romalik/cpu5/microcode/instruction_set.ods

Sheet: ISA
 | 0* | 1* | 2* | 3* | 4* | 5* | 6* | 7* | 8* | 9* | A* | B* | C* | D* | E* | F*
 | 0000 | 0001 | 0010 | 0011 | 0100 | 0101 | 0110 | 0111 | 1000 | 1001 | 1010 | 1011 | 1100 | 1101 | 1110 | 1111
*0 | hlt |  |  |  |  |  | movw w, [m+#] | movw [m+#], w | mov wl,a | mov a,wl | jnz | tadd rd#, rs#, rs# | add | mov b,a | mov a,b | push xm
*1 | di |  |  |  |  |  | movw y, [m+#] | movw [m+#], y | mov wh,a | mov a,wh | jnc | tsub rd#, rs#, rs# | sub | mov sl,a | mov a,sl | pop mx
*2 | ei |  |  |  |  |  | movw z, [m+#] | movw [m+#], z | mov yl,a | mov a,yl | jg | tneg rd#, rs# | neg | mov sh,a | mov a,sh | sp+=2
*3 | nop |  |  |  |  |  | mov [w],a | mov a,[w] | mov yh,a | mov a,yh | ja | tshl rd#, rs# | shl | mov ml,a | mov a,ml | sp+=8
*4 |  |  |  |  |  |  | mov [y],a | mov a,[y] | mov zl,a | mov a,zl | jge | tshlc rd#, rs# | shlc | mov mh,a | mov a,mh | sp-=2
*5 |  |  |  |  |  |  | mov [z],a | mov a,[z] | mov zh,a | mov a,zh | - | tinc rd#, rs# | inc | mov [m+#],a | mov a,[m+#] | sp-=8
*6 |  |  |  |  |  |  | push w | pop w | w++ | w-- | - | tadc rd#, rs#, rs# | adc | mov xl,a | mov a,xl | push [m+#]
*7 | x++ |  |  |  |  |  | push y | pop y | y++ | y-- | - | tsbc rd#, rs#, rs# | sbc | mov xh,a | mov a,xh | pop [m+#]
*8 |  |  |  |  |  |  | push z | pop z | z++ | z-- | jz | tnot rd#, rs# | not |  |  | pushw [m+#]
*9 |  |  |  |  |  |  |  |  | ldd w, ## | y++ & z++ | jc | tand rd#, rs#, rs# | and | push a | pop a | popw [m+#]
*A |  |  |  |  |  |  |  |  | ldd y, ## | [y]→[z] | jle | tor rd#, rs#, rs# | or | mov f,a | mov a,f | mov [m+#],[m+#]
*B |  |  |  |  |  |  |  |  | ldd z, ## |  | jbe | txor rd#, rs#, rs# | xor | mov [x],a | mov a,[x] | mov2 [m+#],[m+#]
*C |  |  |  |  |  |  |  |  |  |  | jl | tzero rd# | zero | ldd s, ## | ld a, #
*D |  |  |  |  |  |  |  |  |  |  | - | ttest rd#, rs# | test | ldd m, ##
*E |  |  |  |  |  |  |  |  |  |  | - | tshr rd#, rs# | shr | ldd x, ## | movsm | movw x, [m+#]
*F | iret | syscall | iretf |  |  |  |  |  |  |  | jmp | tshrc rd#, rs# | shrc | ld r#, # | movms

Sheet: Timings
 |  |  |  |  |  |  | ns | steps | adjusted steps | min step length | adjusted stage time ns | slack ns
 |  |  |  |  |  | mc | 70 | 4.28571428571429 | 4 | 17.5 | 80 | 10
Step 20 ns |  |  |  |  |  | R(tlb+ram) | 130 | 7.95918367346939 | 8 | 16.25 | 160 | 30
CLK freq 100 MHz |  |  |  |  |  | W | 45 | 2.75510204081633 | 3 | 15 | 60 | 15
 |  |  |  |  |  |  | 245 | 15 | 15
cw | 0 | 0 | 0 | 0 | start = NOT(OR(OR(0,1),OR(2,3)))
cw | 0 | 0 | 0 | 1 |  |  |  |  |  | step duration ns | cycle ns | main clock ns | main clock sec | main clock freq Hz | main clock freq MHz
cw | 0 | 0 | 1 | 0 |  |  |  |  |  | 20 | 320 | 10 | 0.00000001 | 100000000 | 100
cw | 0 | 0 | 1 | 1
RD | 0 | 1 | 0 | 0 | cw_clk = AND(NOT(OR(OR(0,1),3)),2)
RD | 0 | 1 | 0 | 1 | phase_read = OR(2,3)
RD | 0 | 1 | 1 | 0
RD | 0 | 1 | 1 | 1
RD | 1 | 0 | 0 | 0
RD | 1 | 0 | 0 | 1
RD | 1 | 0 | 1 | 0
RD | 1 | 0 | 1 | 1
W | 1 | 1 | 0 | 0 | phase_write = AND(2,3)
W | 1 | 1 | 0 | 1
W | 1 | 1 | 1 | 0 |  |  |  |  |  |  |  |  |  |  | 128
RST | 1 | 1 | 1 | 1 | phase_reset = AND(AND(2,3),AND(1,2))
