romalik/cpu5/schematics/cpu5/cpu5.kicad_pcb

## KiCad design schematics/cpu5/cpu5.kicad_pcb (2025-09-12)

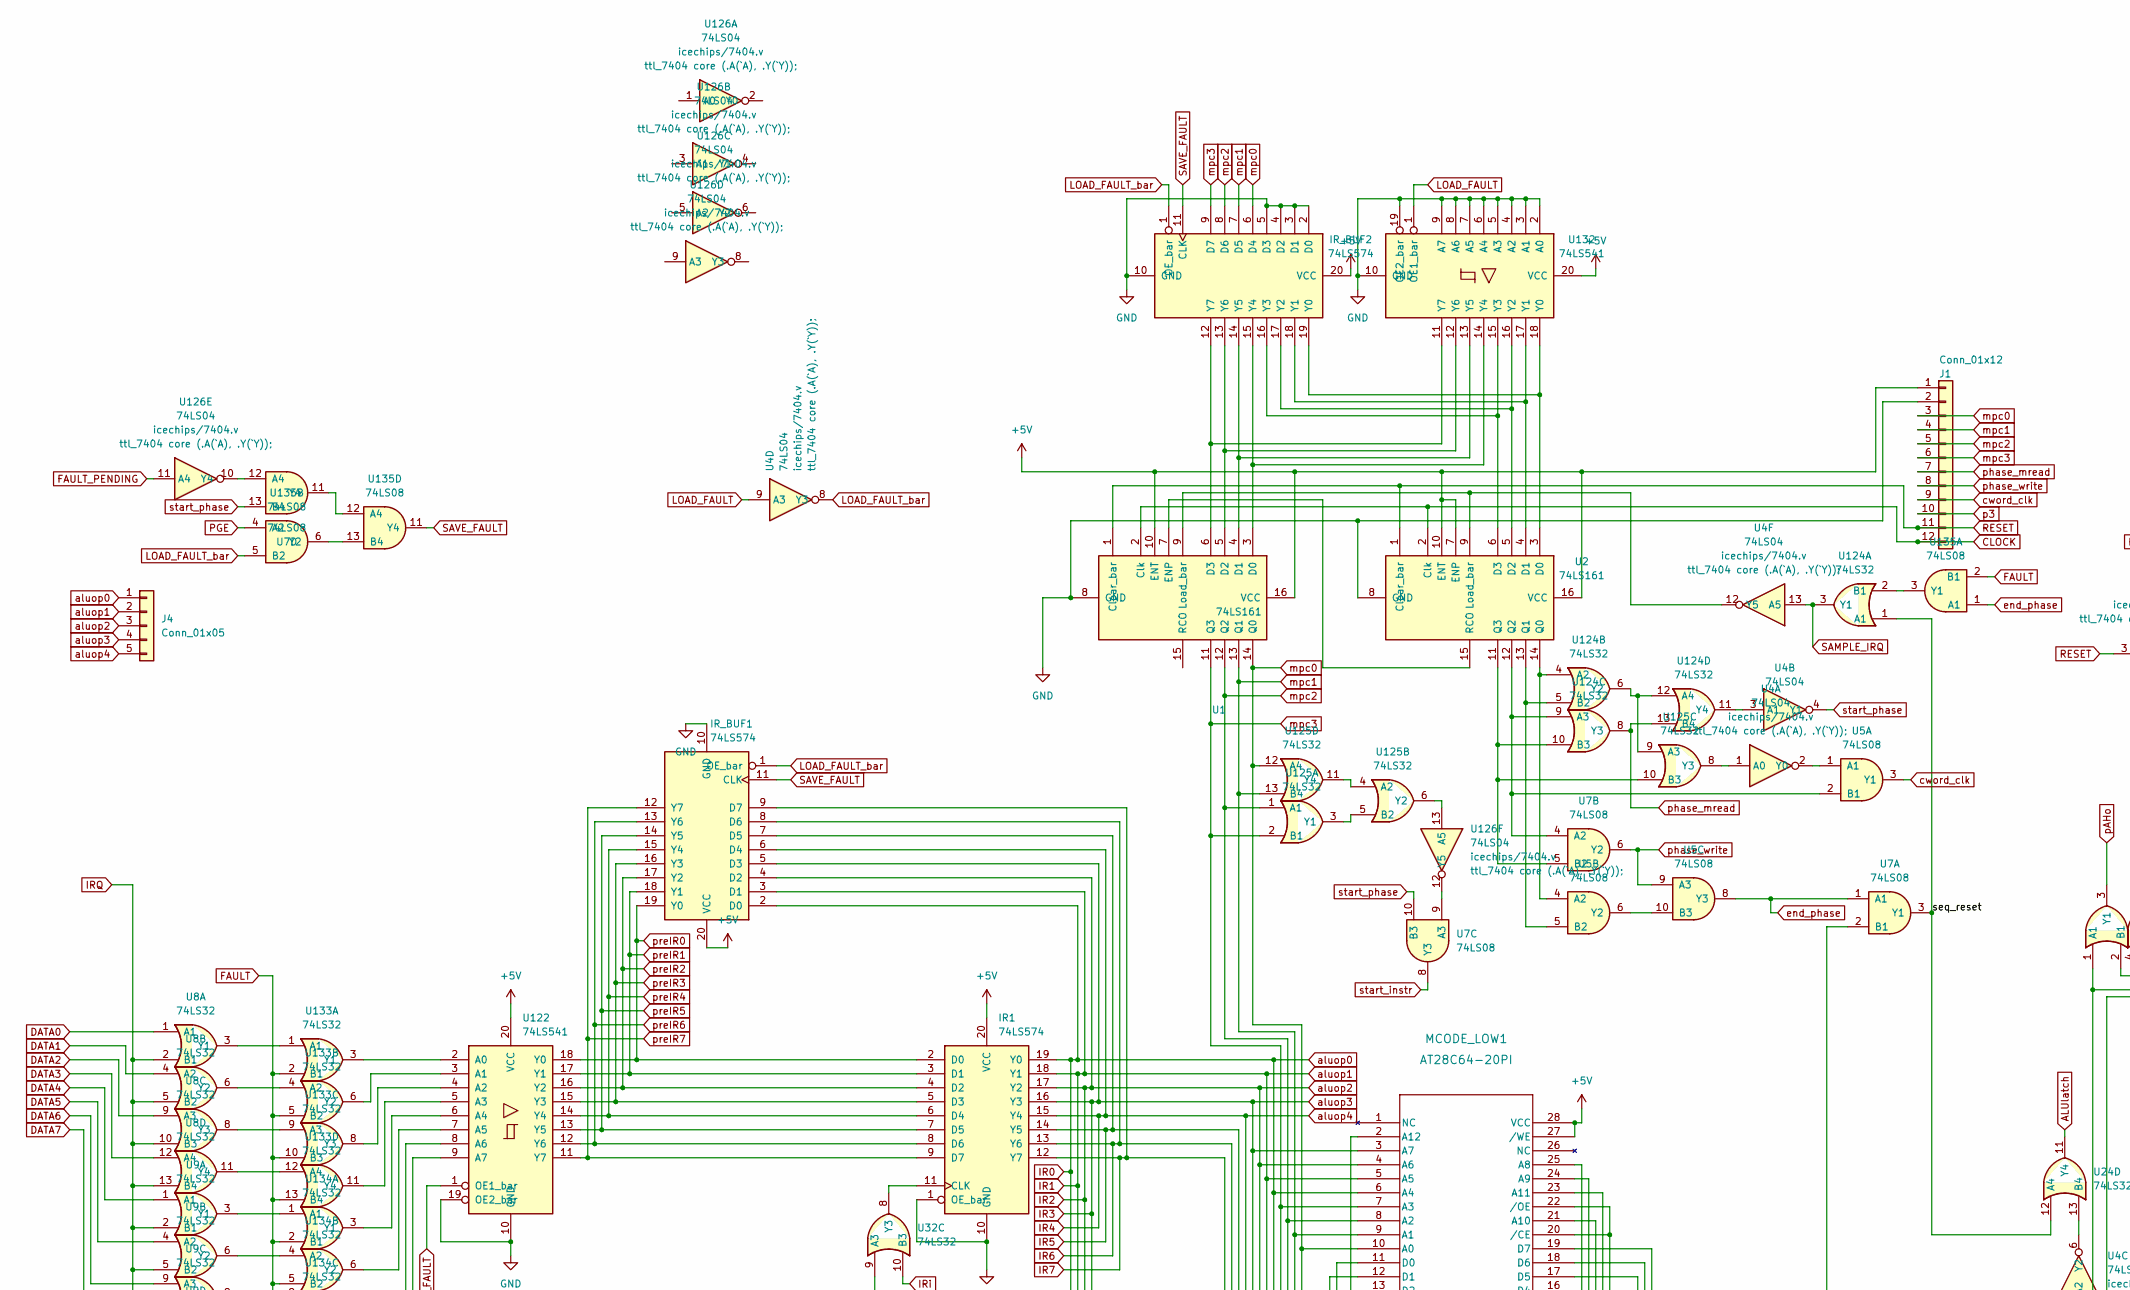
[picture p1: schematic cpu5.kicad_sch, part in row 1, column 1]

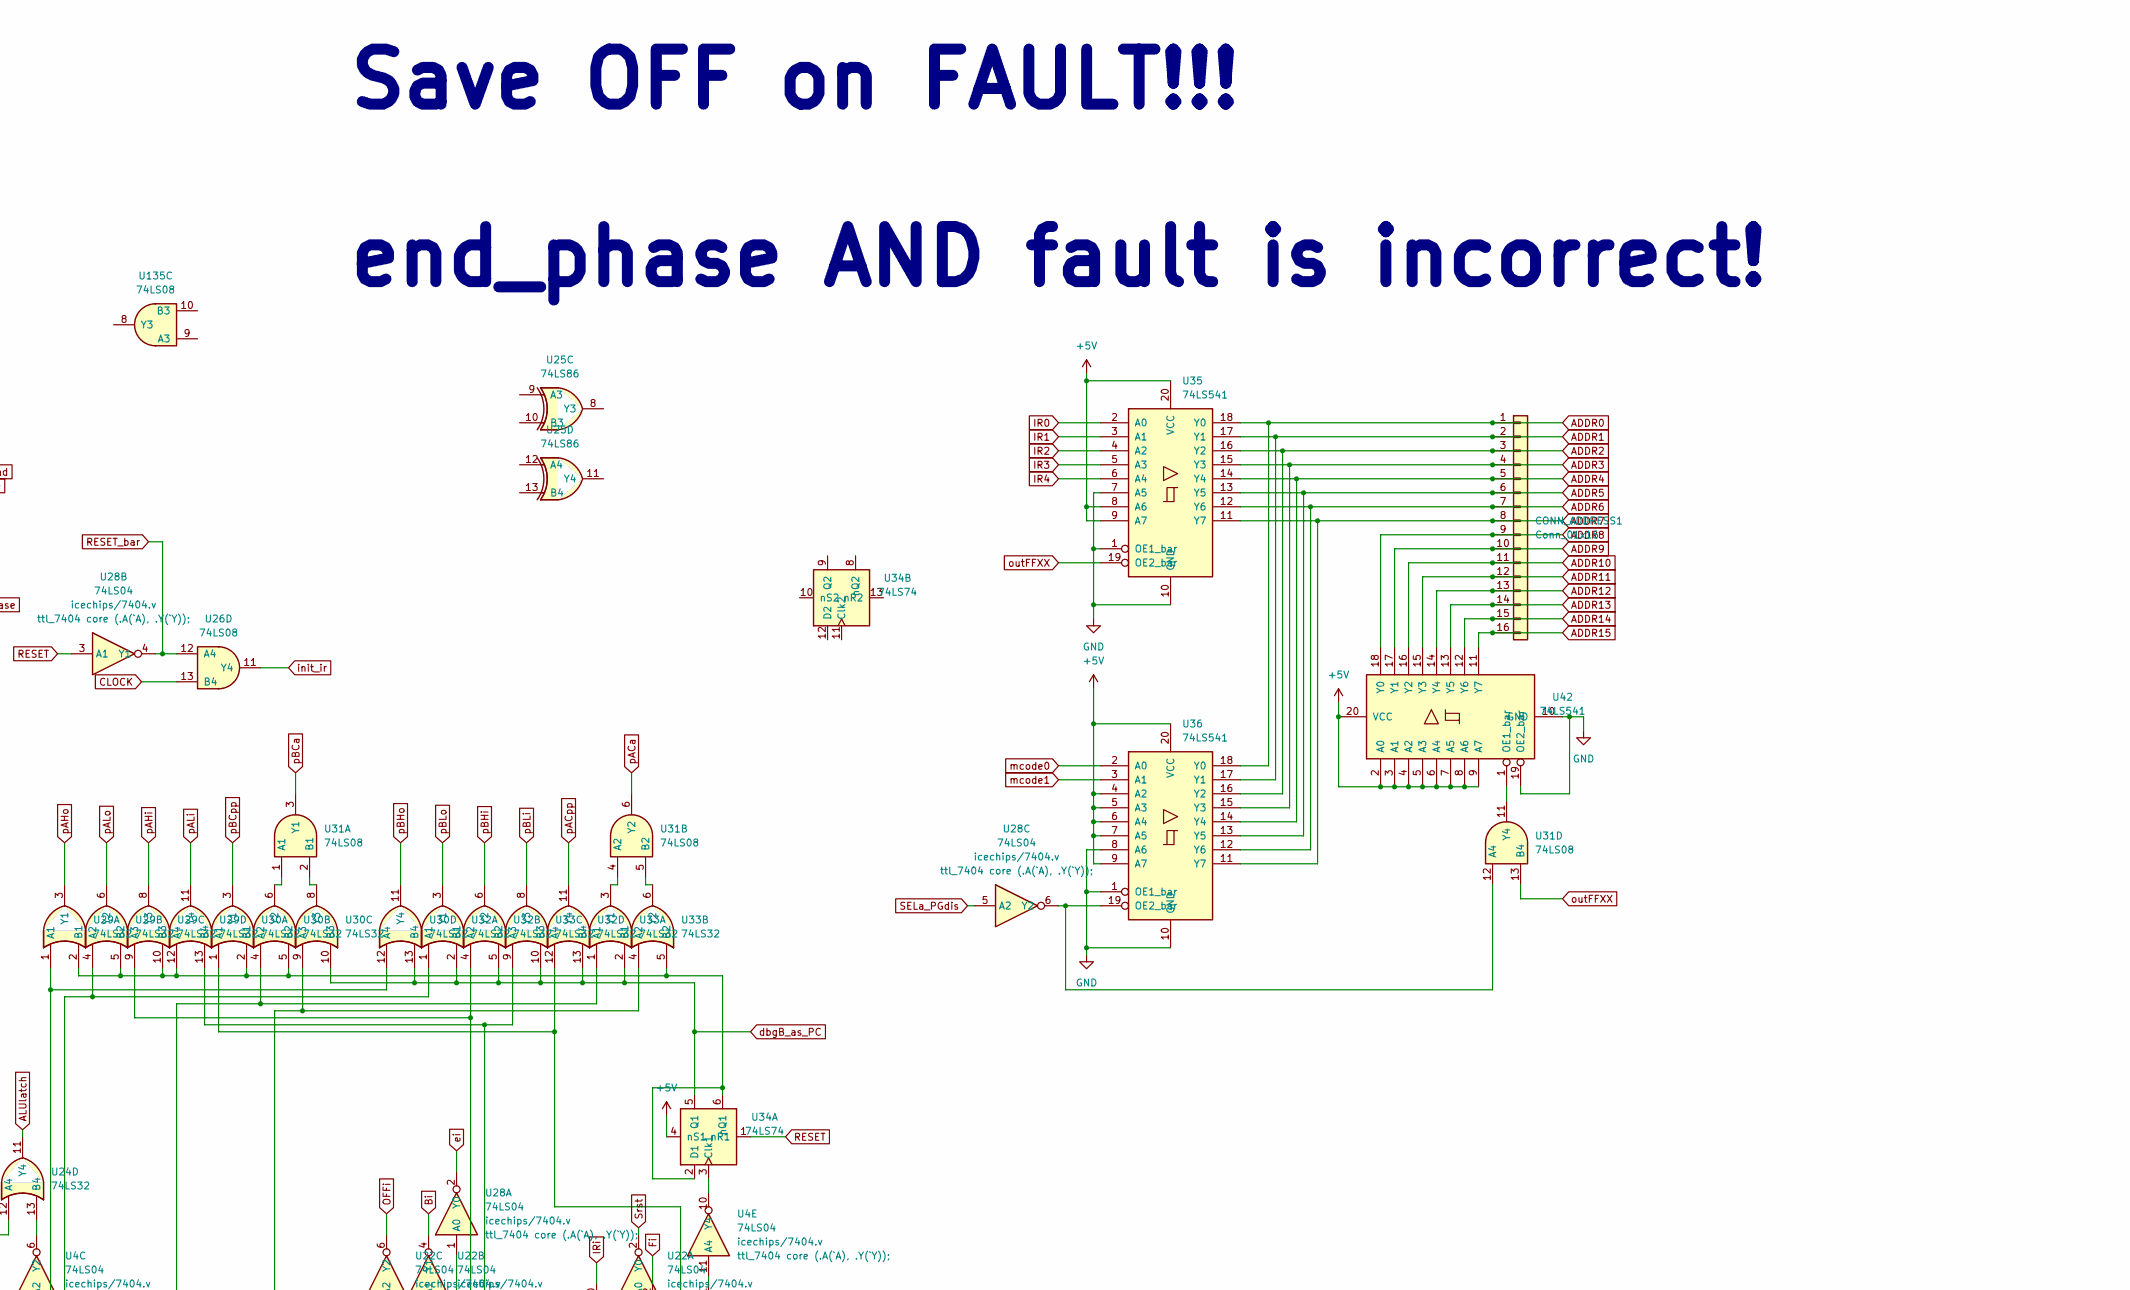
[picture p2: schematic cpu5.kicad_sch, part in row 1, column 2]

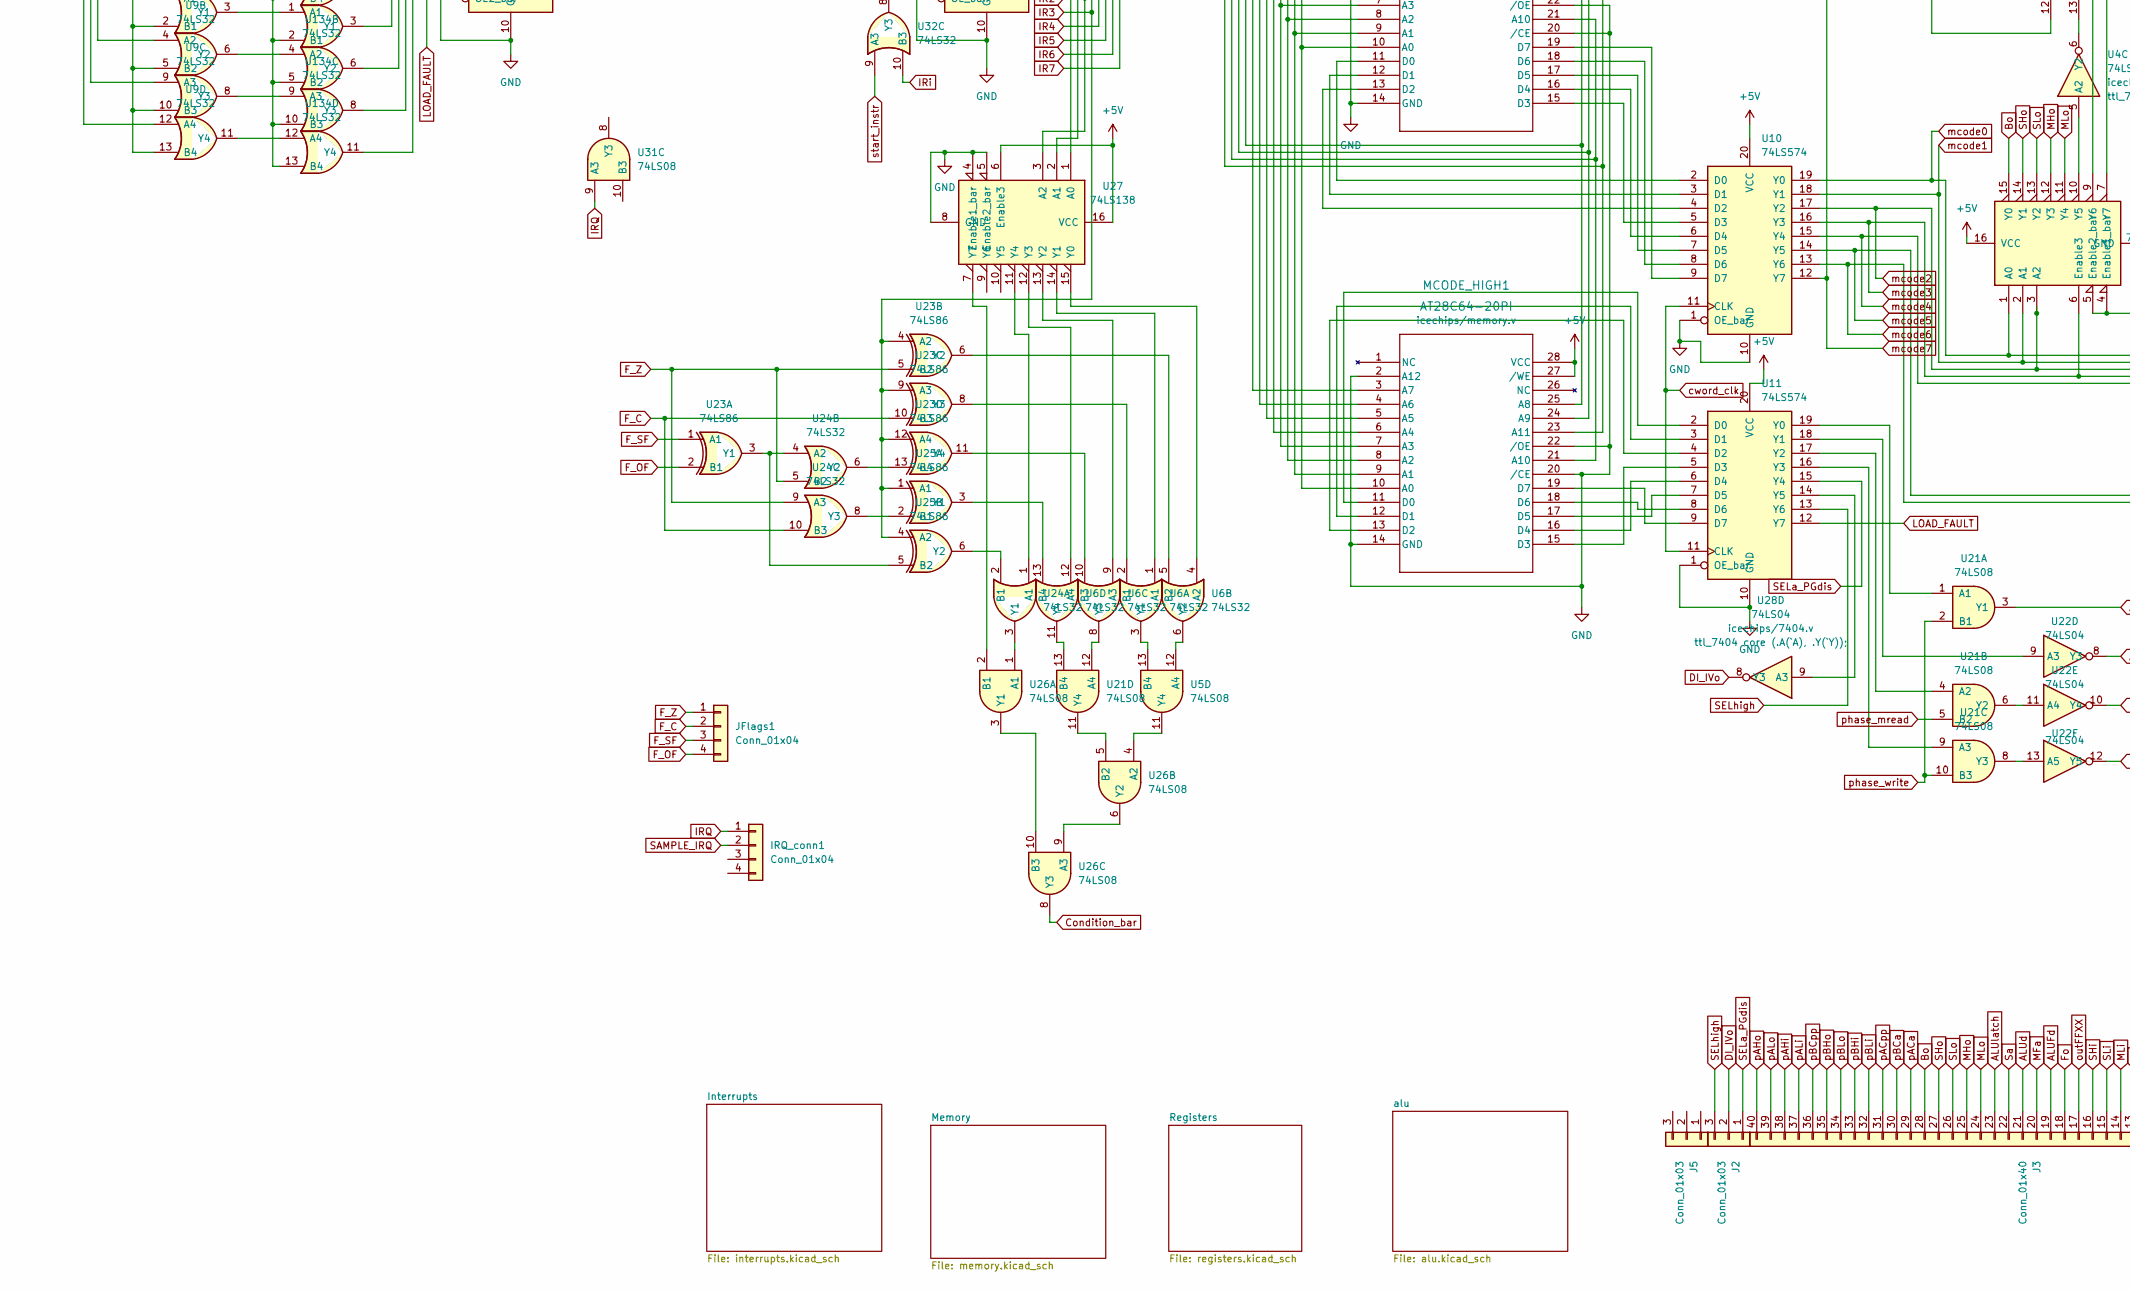
[picture p3: schematic cpu5.kicad_sch, part in row 2, column 1]

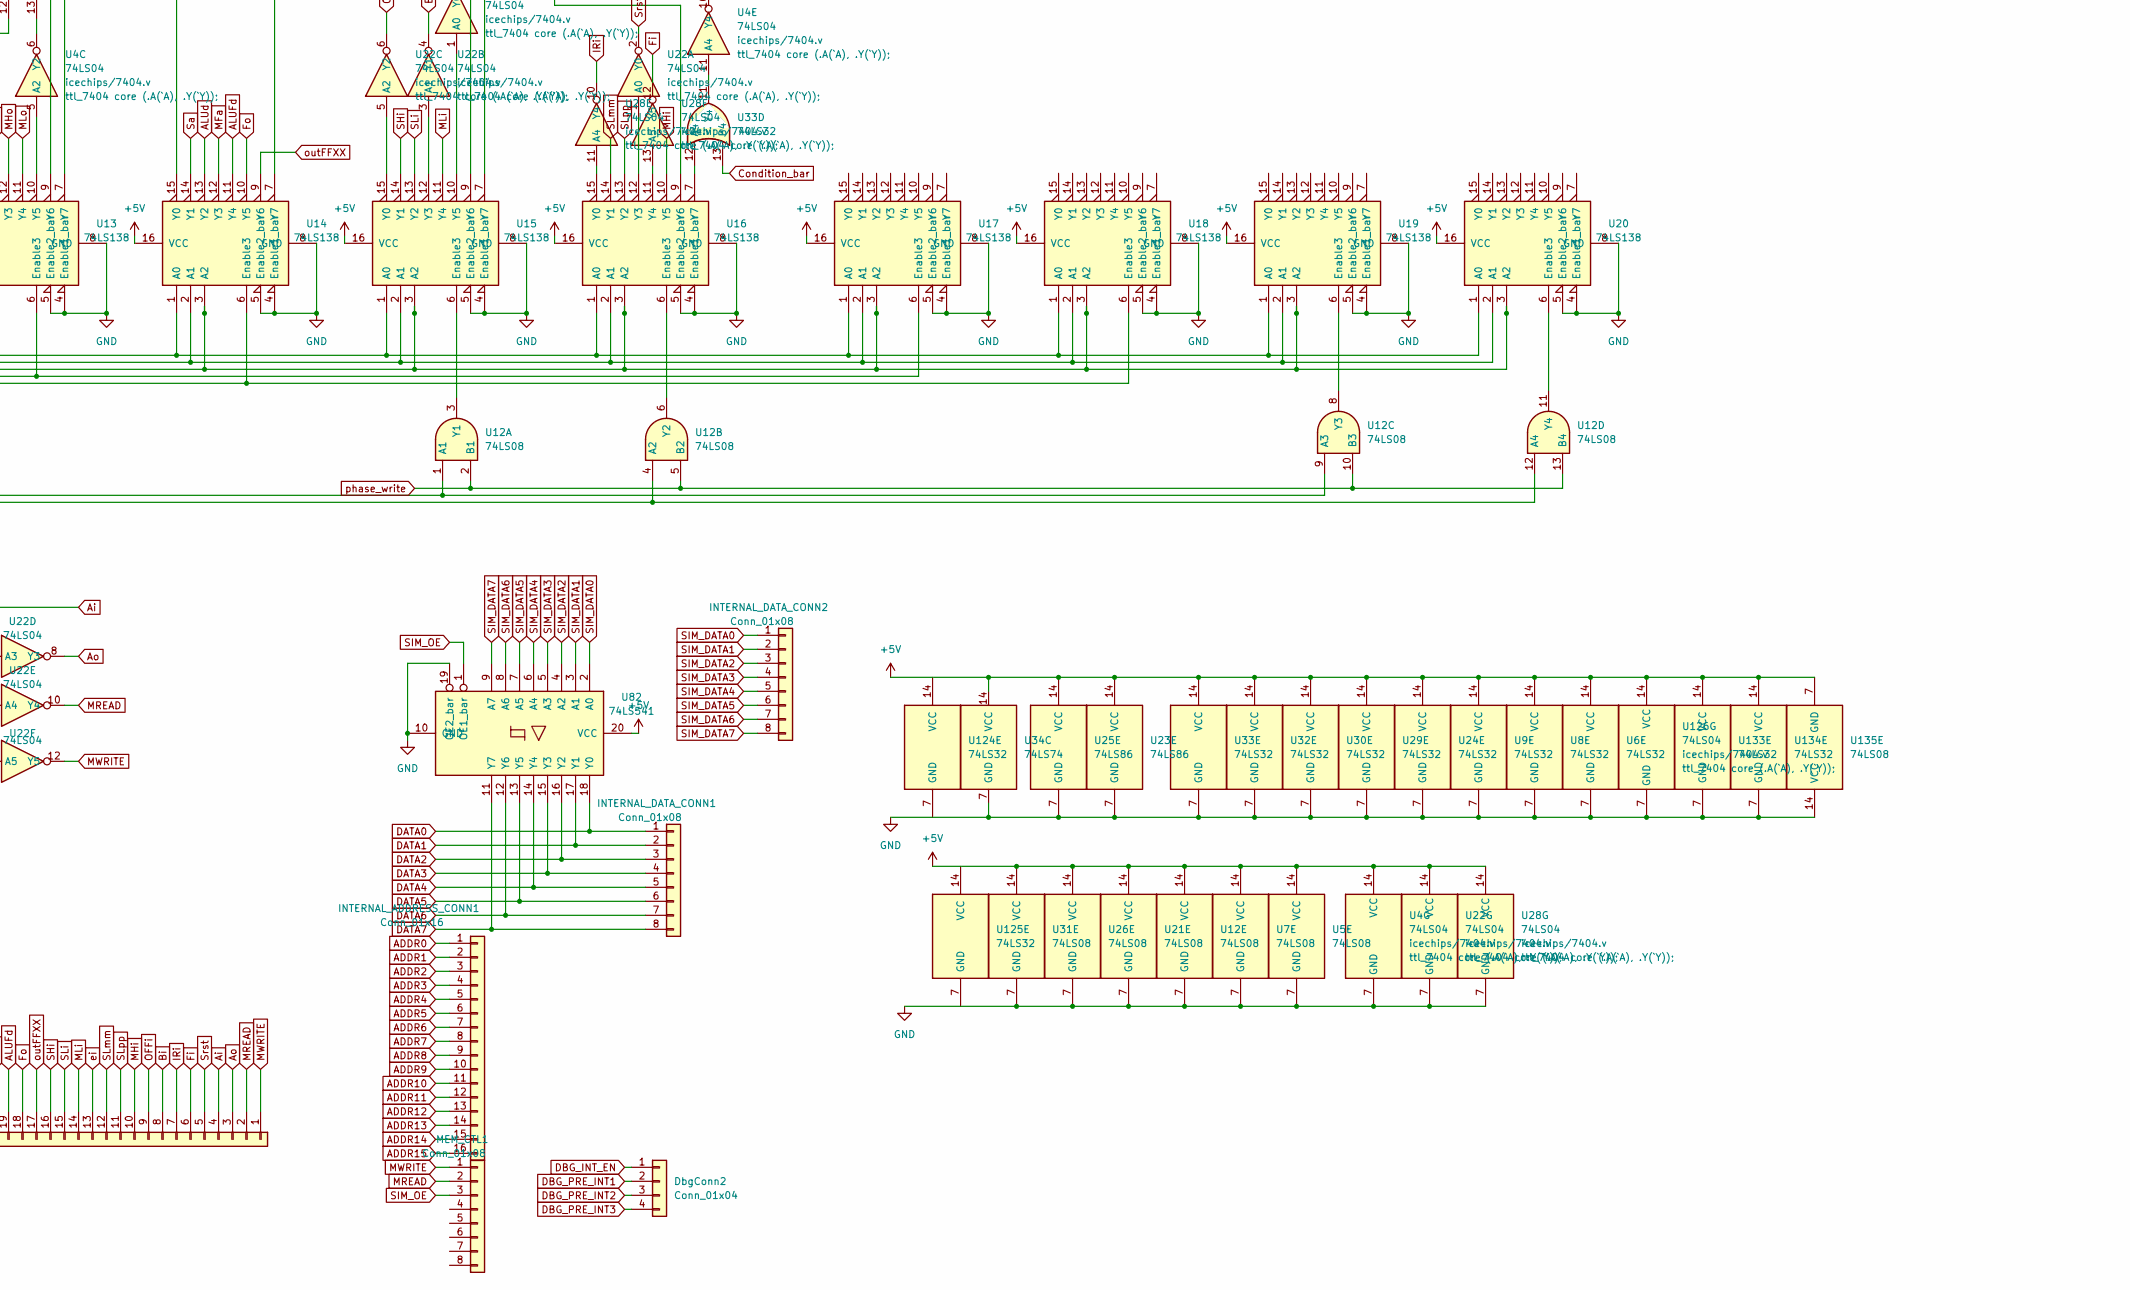
[picture p4: schematic cpu5.kicad_sch, part in row 2, column 2]

Parts:
CONN_ADDRESS1: Conn_01x16; PinHeader_1x16_P2.54mm_Vertical
DbgConn2: Conn_01x04; PinHeader_1x04_P1.00mm_Vertical
INTERNAL_ADDRESS_CONN1: Conn_01x16; PinHeader_1x16_P2.54mm_Vertical
INTERNAL_DATA_CONN1, INTERNAL_DATA_CONN2: Conn_01x08; PinHeader_1x08_P2.54mm_Vertical
IR1: 74LS574; DIP-20_W7.62mm
IRQ_conn1: Conn_01x04; PinHeader_1x04_P1.00mm_Vertical
IR_BUF1, IR_BUF2: 74LS574; DIP-20_W7.62mm
J1: Conn_01x12; PinHeader_1x12_P2.54mm_Vertical
J2, J5: Conn_01x03; PinHeader_1x03_P2.54mm_Vertical
J3: Conn_01x40; PinHeader_1x40_P2.54mm_Vertical
J4: Conn_01x05; PinHeader_1x05_P2.54mm_Vertical
JFlags1: Conn_01x04; PinHeader_1x04_P1.00mm_Vertical
MCODE_HIGH1: AT28C64-20PI; DIP-28_W15.24mm
MCODE_LOW1: AT28C64-20PI; DIP-28_W15.24mm
MEM_CTL1: Conn_01x08; PinHeader_1x08_P2.54mm_Vertical
U1, U2: 74LS161; DIP-16_W7.62mm
U4, U22, U28, U126: 74LS04; DIP-14_W7.62mm
U5, U7, U12, U21, U26, U31, U135: 74LS08; DIP-14_W7.62mm
U6, U8, U9, U24, U29, U30, U32, U33, U124, U125, U133, U134: 74LS32; DIP-14_W7.62mm
U10, U11: 74LS574; DIP-20_W7.62mm
U13, U14, U15, U16, U17, U18, U19, U20, U27: 74LS138; DIP-16_W7.62mm
U23, U25: 74LS86; DIP-14_W7.62mm
U34: 74LS74; DIP-14_W7.62mm
U35, U36, U42, U82, U122, U132: 74LS541; DIP-20_W7.62mm

Connections:
+5V: IR1.20 (VCC), IR_BUF1.20 (VCC), IR_BUF2.20 (VCC), J1.1, MCODE_HIGH1.27 (/WE), MCODE_HIGH1.28 (VCC), MCODE_LOW1.27 (/WE), MCODE_LOW1.28 (VCC), U1.10 (ENT), U1.16 (VCC), U2.7 (ENP), U2.10 (ENT), U2.16 (VCC), U4.14 (VCC), U5.14 (VCC), U6.14 (VCC), U7.14 (VCC), U8.14 (VCC), U9.14 (VCC), U10.20 (VCC), U11.20 (VCC), U12.14 (VCC), U13.16 (VCC), U14.16 (VCC), U15.16 (VCC), U16.16 (VCC), U17.16 (VCC), U18.16 (VCC), U19.16 (VCC), U20.16 (VCC), U21.14 (VCC), U22.14 (VCC), U23.14 (VCC), U24.14 (VCC), U25.14 (VCC), U26.14 (VCC), U27.6 (Enable3), U27.16 (VCC), U28.14 (VCC), U29.14 (VCC), U30.14 (VCC), U31.14 (VCC), U32.14 (VCC), U33.14 (VCC), U34.4 (nS1), U34.14 (VCC), U35.8 (A6), U35.9 (A7), U35.20 (VCC), U36.4 (A2), U36.5 (A3), U36.6 (A4), U36.7 (A5), U36.9 (A7), U36.20 (VCC), U42.2 (A0), U42.3 (A1), U42.4 (A2), U42.5 (A3), U42.6 (A4), U42.7 (A5), U42.8 (A6), U42.9 (A7), U42.20 (VCC), U82.20 (VCC), U122.20 (VCC), U126.14 (VCC), U132.20 (VCC), U133.14 (VCC), U134.14 (VCC), U135.7 (GND); also elsewhere on the board
/seq_reset: U7.3 (Y1), U24.12 (A4), U124.1 (A1)
ADDR0: CONN_ADDRESS1.1, INTERNAL_ADDRESS_CONN1.1, U35.18 (Y0), U36.18 (Y0); also elsewhere on the board
ADDR1: CONN_ADDRESS1.2, INTERNAL_ADDRESS_CONN1.2, U35.17 (Y1), U36.17 (Y1); also elsewhere on the board
ADDR2: CONN_ADDRESS1.3, INTERNAL_ADDRESS_CONN1.3, U35.16 (Y2), U36.16 (Y2); also elsewhere on the board
ADDR3: CONN_ADDRESS1.4, INTERNAL_ADDRESS_CONN1.4, U35.15 (Y3), U36.15 (Y3); also elsewhere on the board
ADDR4: CONN_ADDRESS1.5, INTERNAL_ADDRESS_CONN1.5, U35.14 (Y4), U36.14 (Y4); also elsewhere on the board
ADDR5: CONN_ADDRESS1.6, INTERNAL_ADDRESS_CONN1.6, U35.13 (Y5), U36.13 (Y5); also elsewhere on the board
ADDR6: CONN_ADDRESS1.7, INTERNAL_ADDRESS_CONN1.7, U35.12 (Y6), U36.12 (Y6); also elsewhere on the board
ADDR7: CONN_ADDRESS1.8, INTERNAL_ADDRESS_CONN1.8, U35.11 (Y7), U36.11 (Y7); also elsewhere on the board
ADDR8: CONN_ADDRESS1.9, INTERNAL_ADDRESS_CONN1.9, U42.18 (Y0); also elsewhere on the board
ADDR9: CONN_ADDRESS1.10, INTERNAL_ADDRESS_CONN1.10, U42.17 (Y1); also elsewhere on the board
ADDR10: CONN_ADDRESS1.11, INTERNAL_ADDRESS_CONN1.11, U42.16 (Y2); also elsewhere on the board
ADDR11: CONN_ADDRESS1.12, INTERNAL_ADDRESS_CONN1.12, U42.15 (Y3); also elsewhere on the board
ADDR12: CONN_ADDRESS1.13, INTERNAL_ADDRESS_CONN1.13, U42.14 (Y4); also elsewhere on the board
ADDR13: CONN_ADDRESS1.14, INTERNAL_ADDRESS_CONN1.14, U42.13 (Y5); also elsewhere on the board
ADDR14: CONN_ADDRESS1.15, INTERNAL_ADDRESS_CONN1.15, U42.12 (Y6); also elsewhere on the board
ADDR15: CONN_ADDRESS1.16, INTERNAL_ADDRESS_CONN1.16, U42.11 (Y7); also elsewhere on the board
ALUFd: J3.19, U14.11 (Y4); also elsewhere on the board
ALUd: J3.21, U14.13 (Y2); also elsewhere on the board
ALUlatch: J3.23, U24.11 (Y4); also elsewhere on the board
Ai: J3.4, U21.3 (Y1); also elsewhere on the board
Ao: J3.3, U22.8 (Y3); also elsewhere on the board
Bi: J3.8, U22.4 (Y1); also elsewhere on the board
Bo: J3.28, U13.15 (Y0); also elsewhere on the board
CLOCK: J1.12, U1.2 (Clk), U2.2 (Clk), U26.13 (B4)
Condition_bar: U26.8 (Y3), U33.13 (B4)
DATA0: INTERNAL_DATA_CONN1.1, U8.1 (A1), U82.18 (Y0); also elsewhere on the board
DATA1: INTERNAL_DATA_CONN1.2, U8.4 (A2), U82.17 (Y1); also elsewhere on the board
DATA2: INTERNAL_DATA_CONN1.3, U8.9 (A3), U82.16 (Y2); also elsewhere on the board
DATA3: INTERNAL_DATA_CONN1.4, U8.12 (A4), U82.15 (Y3); also elsewhere on the board
DATA4: INTERNAL_DATA_CONN1.5, U9.1 (A1), U82.14 (Y4); also elsewhere on the board
DATA5: INTERNAL_DATA_CONN1.6, U9.4 (A2), U82.13 (Y5); also elsewhere on the board
DATA6: INTERNAL_DATA_CONN1.7, U9.9 (A3), U82.12 (Y6); also elsewhere on the board
DATA7: INTERNAL_DATA_CONN1.8, U9.12 (A4), U82.11 (Y7); also elsewhere on the board
DBG_INT_EN: DbgConn2.1; also elsewhere on the board
DBG_PRE_INT1: DbgConn2.2; also elsewhere on the board
DBG_PRE_INT2: DbgConn2.3; also elsewhere on the board
DBG_PRE_INT3: DbgConn2.4; also elsewhere on the board
DI_IVo: J2.2, U28.8 (Y3); also elsewhere on the board
FAULT: U133.2 (B1), U133.5 (B2), U133.10 (B3), U133.13 (B4), U134.2 (B1), U134.5 (B2), U134.10 (B3), U134.13 (B4), U135.2 (B1); also elsewhere on the board
FAULT_PENDING: U126.11 (A4); also elsewhere on the board
F_C: JFlags1.2, U23.10 (B3), U24.10 (B3); also elsewhere on the board
F_OF: JFlags1.4, U23.2 (B1); also elsewhere on the board
F_SF: JFlags1.3, U23.1 (A1); also elsewhere on the board
F_Z: JFlags1.1, U23.5 (B2), U24.5 (B2), U24.9 (A3); also elsewhere on the board
Fi: J3.6, U28.12 (Y5); also elsewhere on the board
Fo: J3.18, U14.10 (Y5); also elsewhere on the board
GND: IR1.1 (OE_bar), IR1.10 (GND), IR_BUF1.10 (GND), IR_BUF2.2 (D0), IR_BUF2.3 (D1), IR_BUF2.4 (D2), IR_BUF2.5 (D3), IR_BUF2.10 (GND), J1.2, MCODE_HIGH1.2 (A12), MCODE_HIGH1.14 (GND), MCODE_HIGH1.20 (/CE), MCODE_HIGH1.22 (/OE), MCODE_LOW1.2 (A12), MCODE_LOW1.14 (GND), MCODE_LOW1.20 (/CE), MCODE_LOW1.22 (/OE), U1.8 (GND), U2.8 (GND), U4.7 (GND), U5.7 (GND), U6.7 (GND), U7.7 (GND), U8.7 (GND), U9.7 (GND), U10.1 (OE_bar), U10.10 (GND), U11.1 (OE_bar), U11.10 (GND), U12.7 (GND), U13.4 (Enable1_bar), U13.5 (Enable2_bar), U13.8 (GND), U14.4 (Enable1_bar), U14.5 (Enable2_bar), U14.8 (GND), U15.4 (Enable1_bar), U15.5 (Enable2_bar), U15.8 (GND), U16.4 (Enable1_bar), U16.5 (Enable2_bar), U16.8 (GND), U17.4 (Enable1_bar), U17.5 (Enable2_bar), U17.8 (GND), U18.4 (Enable1_bar), U18.5 (Enable2_bar), U18.8 (GND), U19.4 (Enable1_bar), U19.5 (Enable2_bar), U19.8 (GND), U20.4 (Enable1_bar), U20.5 (Enable2_bar), U20.8 (GND), U21.7 (GND), U22.7 (GND), U23.7 (GND), U24.7 (GND), U25.7 (GND), U26.7 (GND), U27.4 (Enable1_bar), U27.5 (Enable2_bar), U27.8 (GND), U28.7 (GND), U29.7 (GND), U30.7 (GND), U31.7 (GND), U32.7 (GND), U33.7 (GND), U34.7 (GND), U35.1 (OE1_bar), U35.7 (A5), U35.10 (GND), U36.1 (OE1_bar), U36.8 (A6), U36.10 (GND), U42.10 (GND), U42.19 (OE2_bar), U82.10 (GND), U82.19 (OE2_bar), U122.10 (GND), U122.19 (OE2_bar), U126.7 (GND), U132.2 (A0), U132.3 (A1), U132.4 (A2), U132.5 (A3), U132.6 (A4), U132.7 (A5), U132.8 (A6), U132.9 (A7), U132.10 (GND), U132.19 (OE2_bar), U133.7 (GND), U134.7 (GND), U135.14 (VCC); also elsewhere on the board
IR0: IR1.19 (Y0), IR_BUF1.2 (D0), J4.1, MCODE_HIGH1.6 (A4), MCODE_LOW1.6 (A4), U27.1 (A0), U35.2 (A0); also elsewhere on the board
IR1: IR1.18 (Y1), IR_BUF1.3 (D1), J4.2, MCODE_HIGH1.5 (A5), MCODE_LOW1.5 (A5), U27.2 (A1), U35.3 (A1); also elsewhere on the board
IR2: IR1.17 (Y2), IR_BUF1.4 (D2), J4.3, MCODE_HIGH1.4 (A6), MCODE_LOW1.4 (A6), U27.3 (A2), U35.4 (A2); also elsewhere on the board
IR3: IR1.16 (Y3), IR_BUF1.5 (D3), J4.4, MCODE_HIGH1.3 (A7), MCODE_LOW1.3 (A7), U23.4 (A2), U23.9 (A3), U23.12 (A4), U25.1 (A1), U25.4 (A2), U35.5 (A3); also elsewhere on the board
IR4: IR1.15 (Y4), IR_BUF1.6 (D4), J4.5, MCODE_HIGH1.25 (A8), MCODE_LOW1.25 (A8), U35.6 (A4); also elsewhere on the board
IR5: IR1.14 (Y5), IR_BUF1.7 (D5), MCODE_HIGH1.24 (A9), MCODE_LOW1.24 (A9)
IR6: IR1.13 (Y6), IR_BUF1.8 (D6), MCODE_HIGH1.21 (A10), MCODE_LOW1.21 (A10)
IR7: IR1.12 (Y7), IR_BUF1.9 (D7), MCODE_HIGH1.23 (A11), MCODE_LOW1.23 (A11)
IRQ: IRQ_conn1.1, U8.2 (B1), U8.5 (B2), U8.10 (B3), U8.13 (B4), U9.2 (B1), U9.5 (B2), U9.10 (B3), U9.13 (B4), U31.9 (A3); also elsewhere on the board
IRi: J3.7, U28.10 (Y4), U32.10 (B3)
LOAD_FAULT: U4.9 (A3), U11.12 (Y7), U122.1 (OE1_bar), U132.1 (OE1_bar); also elsewhere on the board
LOAD_FAULT_bar: IR_BUF1.1 (OE_bar), IR_BUF2.1 (OE_bar), U4.8 (Y3), U135.5 (B2); also elsewhere on the board
MFa: J3.20, U14.12 (Y3); also elsewhere on the board
MHi: J3.10, U16.10 (Y5); also elsewhere on the board
MHo: J3.25, U13.12 (Y3); also elsewhere on the board
MLi: J3.14, U15.11 (Y4); also elsewhere on the board
MLo: J3.24, U13.11 (Y4); also elsewhere on the board
MREAD: J3.2, MEM_CTL1.2, U22.10 (Y4); also elsewhere on the board
MWRITE: J3.1, MEM_CTL1.1, U22.12 (Y5); also elsewhere on the board
unnamed: IR1.11 (CLK), U32.8 (Y3)
unnamed: IR_BUF2.12 (Y7), U1.6 (D3), U132.11 (Y7)
unnamed: IR_BUF2.13 (Y6), U1.5 (D2), U132.12 (Y6)
unnamed: IR_BUF2.14 (Y5), U1.4 (D1), U132.13 (Y5)
unnamed: IR_BUF2.15 (Y4), U1.3 (D0), U132.14 (Y4)
unnamed: IR_BUF2.16 (Y3), U2.6 (D3), U132.15 (Y3)
unnamed: IR_BUF2.17 (Y2), U2.5 (D2), U132.16 (Y2)
unnamed: IR_BUF2.18 (Y1), U2.4 (D1), U132.17 (Y1)
unnamed: IR_BUF2.19 (Y0), U2.3 (D0), U132.18 (Y0)
unnamed: MCODE_HIGH1.11 (D0), U11.2 (D0)
unnamed: MCODE_HIGH1.12 (D1), U11.3 (D1)
unnamed: MCODE_HIGH1.13 (D2), U11.4 (D2)
unnamed: MCODE_HIGH1.15 (D3), U11.5 (D3)
unnamed: MCODE_HIGH1.16 (D4), U11.6 (D4)
unnamed: MCODE_HIGH1.17 (D5), U11.7 (D5)
unnamed: MCODE_HIGH1.18 (D6), U11.8 (D6)
unnamed: MCODE_HIGH1.19 (D7), U11.9 (D7)
unnamed: MCODE_LOW1.11 (D0), U10.2 (D0)
unnamed: MCODE_LOW1.12 (D1), U10.3 (D1)
unnamed: MCODE_LOW1.13 (D2), U10.4 (D2)
unnamed: MCODE_LOW1.15 (D3), U10.5 (D3)
unnamed: MCODE_LOW1.16 (D4), U10.6 (D4)
unnamed: MCODE_LOW1.17 (D5), U10.7 (D5)
unnamed: MCODE_LOW1.18 (D6), U10.8 (D6)
unnamed: MCODE_LOW1.19 (D7), U10.9 (D7)
unnamed: U1.7 (ENP), U2.15 (RCO)
unnamed: U1.9 (Load_bar), U2.9 (Load_bar), U4.12 (Y5)
unnamed: U4.2 (Y0), U5.1 (A1)
unnamed: U5.6 (Y2), U5.10 (B3)
unnamed: U5.12 (A4), U6.6 (Y2)
unnamed: U5.13 (B4), U6.3 (Y1)
unnamed: U11.14 (Y5), U28.9 (A3)
unnamed: U11.16 (Y3), U21.9 (A3)
unnamed: U11.17 (Y2), U21.4 (A2)
unnamed: U11.18 (Y1), U22.9 (A3)
unnamed: U11.19 (Y0), U21.1 (A1)
unnamed: U12.3 (Y1), U15.6 (Enable3)
unnamed: U12.6 (Y2), U16.6 (Enable3)
unnamed: U12.8 (Y3), U19.6 (Enable3)
unnamed: U12.11 (Y4), U20.6 (Enable3)
unnamed: U13.7 (Y7), U29.4 (A2), U32.1 (A1)
unnamed: U13.9 (Y6), U29.1 (A1), U30.12 (A4)
unnamed: U4.5 (A2), U13.10 (Y5)
unnamed: U14.7 (Y7), U30.9 (A3), U33.4 (A2)
unnamed: U14.15 (Y0), U30.4 (A2), U33.1 (A1)
unnamed: U15.7 (Y7), U29.13 (B4), U33.9 (A3)
unnamed: U15.9 (Y6), U29.9 (A3), U32.4 (A2)
unnamed: U15.10 (Y5), U28.1 (A0)
unnamed: U15.12 (Y3), U22.3 (A1)
unnamed: U15.15 (Y0), U22.5 (A2)
unnamed: U16.7 (Y7), U33.12 (A4)
unnamed: U16.9 (Y6), U30.1 (A1), U32.12 (A4)
unnamed: U16.11 (Y4), U28.13 (A5)
unnamed: U16.12 (Y3), U22.1 (A0)
unnamed: U16.15 (Y0), U28.11 (A4)
unnamed: U21.6 (Y2), U22.11 (A4)
unnamed: U21.8 (Y3), U22.13 (A5)
unnamed: U21.11 (Y4), U26.5 (B2)
unnamed: U6.8 (Y3), U21.12 (A4)
unnamed: U6.11 (Y4), U21.13 (B4)
unnamed: U23.3 (Y1), U24.4 (A2), U25.5 (B2)
unnamed: U6.5 (B2), U23.6 (Y2)
unnamed: U6.2 (B1), U23.8 (Y3)
unnamed: U6.10 (B3), U23.11 (Y4)
unnamed: U23.13 (B4), U24.6 (Y2)
unnamed: U24.1 (A1), U27.11 (Y4)
unnamed: U24.2 (B1), U25.6 (Y2)
unnamed: U24.3 (Y1), U26.1 (A1)
unnamed: U24.8 (Y3), U25.2 (B1)
unnamed: U4.6 (Y2), U24.13 (B4)
unnamed: U6.13 (B4), U25.3 (Y1)
unnamed: U26.2 (B1), U27.7 (Y7)
unnamed: U5.11 (Y4), U26.4 (A2)
unnamed: U26.6 (Y2), U26.9 (A3)
unnamed: U26.3 (Y1), U26.10 (B3)
unnamed: U6.12 (A4), U27.12 (Y3)
unnamed: U6.9 (A3), U27.13 (Y2)
unnamed: U6.1 (A1), U27.14 (Y1)
unnamed: U6.4 (A2), U27.15 (Y0)
unnamed: U28.6 (Y2), U31.12 (A4), U36.19 (OE2_bar)
unnamed: U29.2 (B1), U29.5 (B2), U29.10 (B3), U29.12 (A4), U30.2 (B1), U30.5 (B2), U33.5 (B2), U34.2 (D1), U34.6 (nQ1)
unnamed: U30.6 (Y2), U31.1 (A1)
unnamed: U30.8 (Y3), U31.2 (B1)
unnamed: U31.4 (A2), U33.3 (Y1)
unnamed: U31.5 (B2), U33.6 (Y2)
unnamed: U31.11 (Y4), U42.1 (OE1_bar)
unnamed: U4.11 (A4), U33.11 (Y4)
unnamed: U4.10 (Y4), U34.3 (Clk1)
unnamed: U122.2 (A0), U133.3 (Y1)
unnamed: U122.3 (A1), U133.6 (Y2)
unnamed: U122.4 (A2), U133.8 (Y3)
unnamed: U122.5 (A3), U133.11 (Y4)
unnamed: U122.6 (A4), U134.3 (Y1)
unnamed: U122.7 (A5), U134.6 (Y2)
unnamed: U122.8 (A6), U134.8 (Y3)
unnamed: U122.9 (A7), U134.11 (Y4)
unnamed: U124.2 (B1), U135.3 (Y1)
unnamed: U2.14 (Q0), U5.4 (A2), U124.4 (A2)
unnamed: U2.13 (Q1), U5.5 (B2), U124.5 (B2)
unnamed: U2.12 (Q2), U5.2 (B1), U7.4 (A2), U124.9 (A3)
unnamed: U2.11 (Q3), U7.5 (B2), U124.10 (B3), U125.10 (B3)
unnamed: U4.3 (A1), U124.11 (Y4)
unnamed: U124.6 (Y2), U124.12 (A4), U125.9 (A3)
unnamed: U125.3 (Y1), U125.5 (B2)
unnamed: U125.6 (Y2), U126.13 (A5)
unnamed: U4.1 (A0), U125.8 (Y3)
unnamed: U125.4 (A2), U125.11 (Y4)
unnamed: U7.12 (A4), U126.10 (Y4)
unnamed: U7.9 (A3), U126.12 (Y5)
unnamed: U8.3 (Y1), U133.1 (A1)
unnamed: U8.6 (Y2), U133.4 (A2)
unnamed: U8.8 (Y3), U133.9 (A3)
unnamed: U8.11 (Y4), U133.12 (A4)
unnamed: U9.3 (Y1), U134.1 (A1)
unnamed: U9.6 (Y2), U134.4 (A2)
unnamed: U9.8 (Y3), U134.9 (A3)
unnamed: U9.11 (Y4), U134.12 (A4)
unnamed: U7.11 (Y4), U135.12 (A4)
unnamed: U135.6 (Y2), U135.13 (B4)
OFFi: J3.9, U22.6 (Y2); also elsewhere on the board
PGE: U135.4 (A2); also elsewhere on the board
RESET: J1.11, U1.1 (Clear_bar), U2.1 (Clear_bar), U28.3 (A1), U34.1 (nR1); also elsewhere on the board
RESET_bar: U26.12 (A4), U28.4 (Y1); also elsewhere on the board
SAMPLE_IRQ: IRQ_conn1.2, U4.13 (A5), U124.3 (Y1); also elsewhere on the board
SAVE_FAULT: IR_BUF1.11 (CLK), IR_BUF2.11 (CLK), U135.11 (Y4); also elsewhere on the board
SELa_PGdis: J2.1, U11.15 (Y4), U28.5 (A2); also elsewhere on the board
SELhigh: J2.3, U11.13 (Y6); also elsewhere on the board
SHi: J3.16, U15.14 (Y1); also elsewhere on the board
SHo: J3.27, U13.14 (Y1); also elsewhere on the board
SIM_DATA0: INTERNAL_DATA_CONN2.1, U82.2 (A0)
SIM_DATA1: INTERNAL_DATA_CONN2.2, U82.3 (A1)
SIM_DATA2: INTERNAL_DATA_CONN2.3, U82.4 (A2)
SIM_DATA3: INTERNAL_DATA_CONN2.4, U82.5 (A3)
SIM_DATA4: INTERNAL_DATA_CONN2.5, U82.6 (A4)
SIM_DATA5: INTERNAL_DATA_CONN2.6, U82.7 (A5)
SIM_DATA6: INTERNAL_DATA_CONN2.7, U82.8 (A6)
SIM_DATA7: INTERNAL_DATA_CONN2.8, U82.9 (A7)
SIM_OE: MEM_CTL1.3, U82.1 (OE1_bar)
SLi: J3.15, U15.13 (Y2); also elsewhere on the board
SLmm: J3.12, U16.14 (Y1); also elsewhere on the board
SLo: J3.26, U13.13 (Y2); also elsewhere on the board
SLpp: J3.11, U16.13 (Y2); also elsewhere on the board
Sa: J3.22, U14.14 (Y1); also elsewhere on the board
Srst: J3.5, U22.2 (Y0); also elsewhere on the board
cword_clk: J1.9, U5.3 (Y1), U10.11 (CLK), U11.11 (CLK)
dbgB_as_PC: U30.10 (B3), U30.13 (B4), U32.2 (B1), U32.5 (B2), U32.13 (B4), U33.2 (B1), U33.10 (B3), U34.5 (Q1)
ei: J3.13, U28.2 (Y0); also elsewhere on the board
end_phase: U5.8 (Y3), U7.1 (A1), U135.1 (A1)
init_ir: U26.11 (Y4)
mcode0: U10.19 (Y0), U13.1 (A0), U14.1 (A0), U15.1 (A0), U16.1 (A0), U17.1 (A0), U18.1 (A0), U19.1 (A0), U20.1 (A0), U36.2 (A0)
mcode1: U10.18 (Y1), U13.2 (A1), U14.2 (A1), U15.2 (A1), U16.2 (A1), U17.2 (A1), U18.2 (A1), U19.2 (A1), U20.2 (A1), U36.3 (A1)
mcode2: U10.17 (Y2), U13.3 (A2), U14.3 (A2), U15.3 (A2), U16.3 (A2), U17.3 (A2), U18.3 (A2), U19.3 (A2), U20.3 (A2)
mcode3: U10.16 (Y3), U13.6 (Enable3), U17.6 (Enable3)
mcode4: U10.15 (Y4), U14.6 (Enable3), U18.6 (Enable3)
mcode5: U10.14 (Y5), U12.1 (A1), U12.9 (A3)
mcode6: U10.13 (Y6), U12.4 (A2), U12.12 (A4)
mcode7: U7.2 (B1), U10.12 (Y7)
mpc0: IR_BUF2.6 (D4), J1.3, MCODE_HIGH1.10 (A0), MCODE_LOW1.10 (A0), U1.14 (Q0), U125.12 (A4)
mpc1: IR_BUF2.7 (D5), J1.4, MCODE_HIGH1.9 (A1), MCODE_LOW1.9 (A1), U1.13 (Q1), U125.13 (B4)
mpc2: IR_BUF2.8 (D6), J1.5, MCODE_HIGH1.8 (A2), MCODE_LOW1.8 (A2), U1.12 (Q2), U125.1 (A1)
mpc3: IR_BUF2.9 (D7), J1.6, MCODE_HIGH1.7 (A3), MCODE_LOW1.7 (A3), U1.11 (Q3), U125.2 (B1)
outFFXX: J3.17, U14.9 (Y6), U31.13 (B4), U35.19 (OE2_bar)
p3: J1.10
pACa: J3.29, U31.6 (Y2); also elsewhere on the board
pACpp: J3.31, U32.11 (Y4); also elsewhere on the board
pAHi: J3.38, U29.8 (Y3); also elsewhere on the board
pAHo: J3.40, U29.3 (Y1); also elsewhere on the board
pALi: J3.37, U29.11 (Y4); also elsewhere on the board
pALo: J3.39, U29.6 (Y2); also elsewhere on the board
pBCa: J3.30, U31.3 (Y1); also elsewhere on the board
pBCpp: J3.36, U30.3 (Y1); also elsewhere on the board
pBHi: J3.33, U32.6 (Y2); also elsewhere on the board
pBHo: J3.35, U30.11 (Y4); also elsewhere on the board
pBLi: J3.32, U33.8 (Y3); also elsewhere on the board
pBLo: J3.34, U32.3 (Y1); also elsewhere on the board
phase_mread: J1.7, U21.5 (B2), U124.8 (Y3), U124.13 (B4)
phase_write: J1.8, U5.9 (A3), U7.6 (Y2), U12.2 (B1), U12.5 (B2), U12.10 (B3), U12.13 (B4), U21.2 (B1), U21.10 (B3)
preIR0: IR1.2 (D0), IR_BUF1.19 (Y0), U122.18 (Y0)
preIR1: IR1.3 (D1), IR_BUF1.18 (Y1), U122.17 (Y1)
preIR2: IR1.4 (D2), IR_BUF1.17 (Y2), U122.16 (Y2)
preIR3: IR1.5 (D3), IR_BUF1.16 (Y3), U122.15 (Y3)
preIR4: IR1.6 (D4), IR_BUF1.15 (Y4), U122.14 (Y4)
preIR5: IR1.7 (D5), IR_BUF1.14 (Y5), U122.13 (Y5)
preIR6: IR1.8 (D6), IR_BUF1.13 (Y6), U122.12 (Y6)
preIR7: IR1.9 (D7), IR_BUF1.12 (Y7), U122.11 (Y7)
start_instr: U7.8 (Y3), U32.9 (A3)
start_phase: U4.4 (Y1), U7.10 (B3), U7.13 (B4); also elsewhere on the board

Notes on the sheet:
Save OFF on FAULT!!! end_phase AND fault is incorrect!
