romalik/cpu5/schematics/cpu5/cpu5.kicad_pcb

## KiCad design schematics/cpu5/cpu5.kicad_pcb (continued)

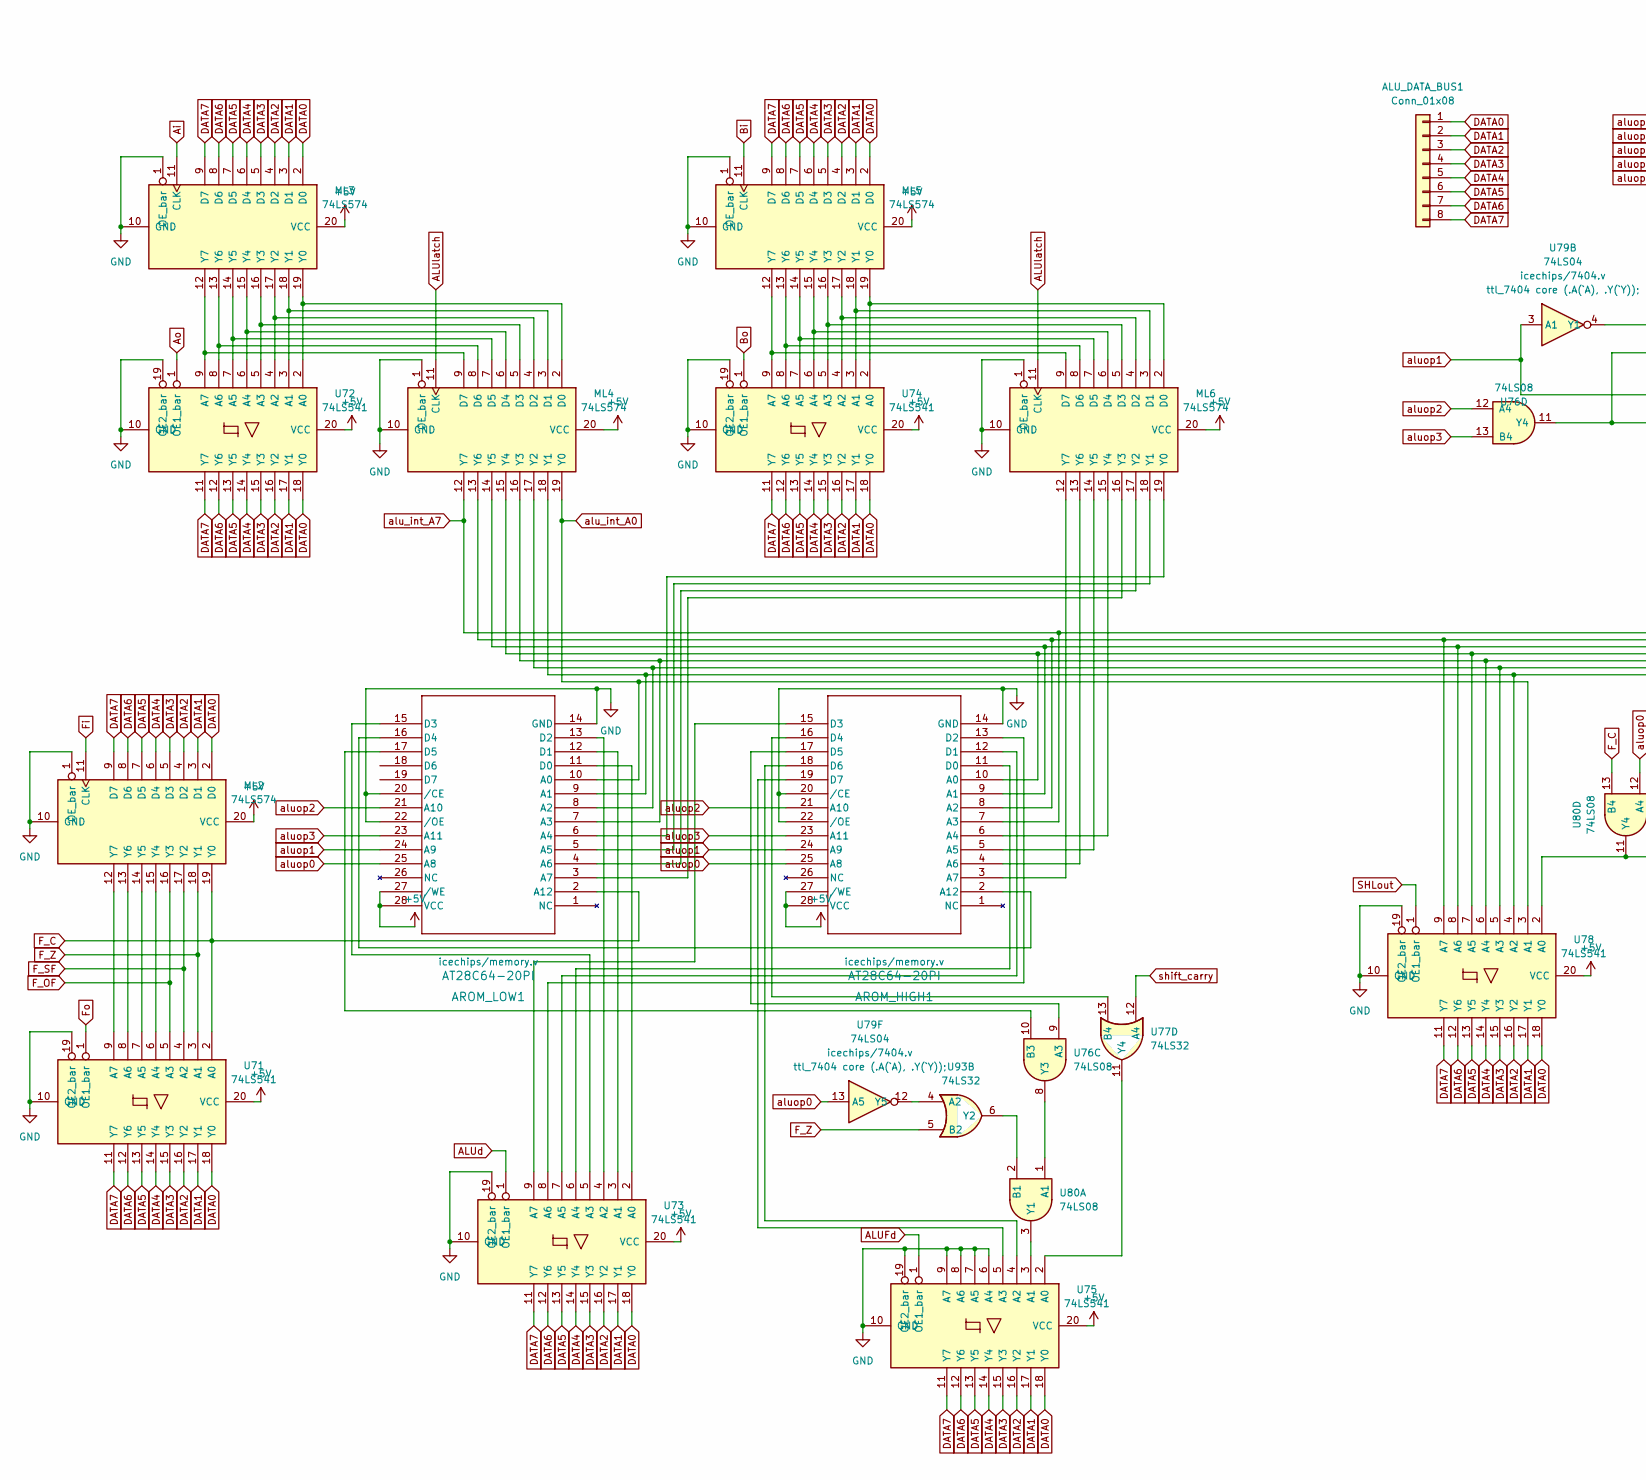
[picture p5: schematic alu.kicad_sch, part in row 1, column 1]

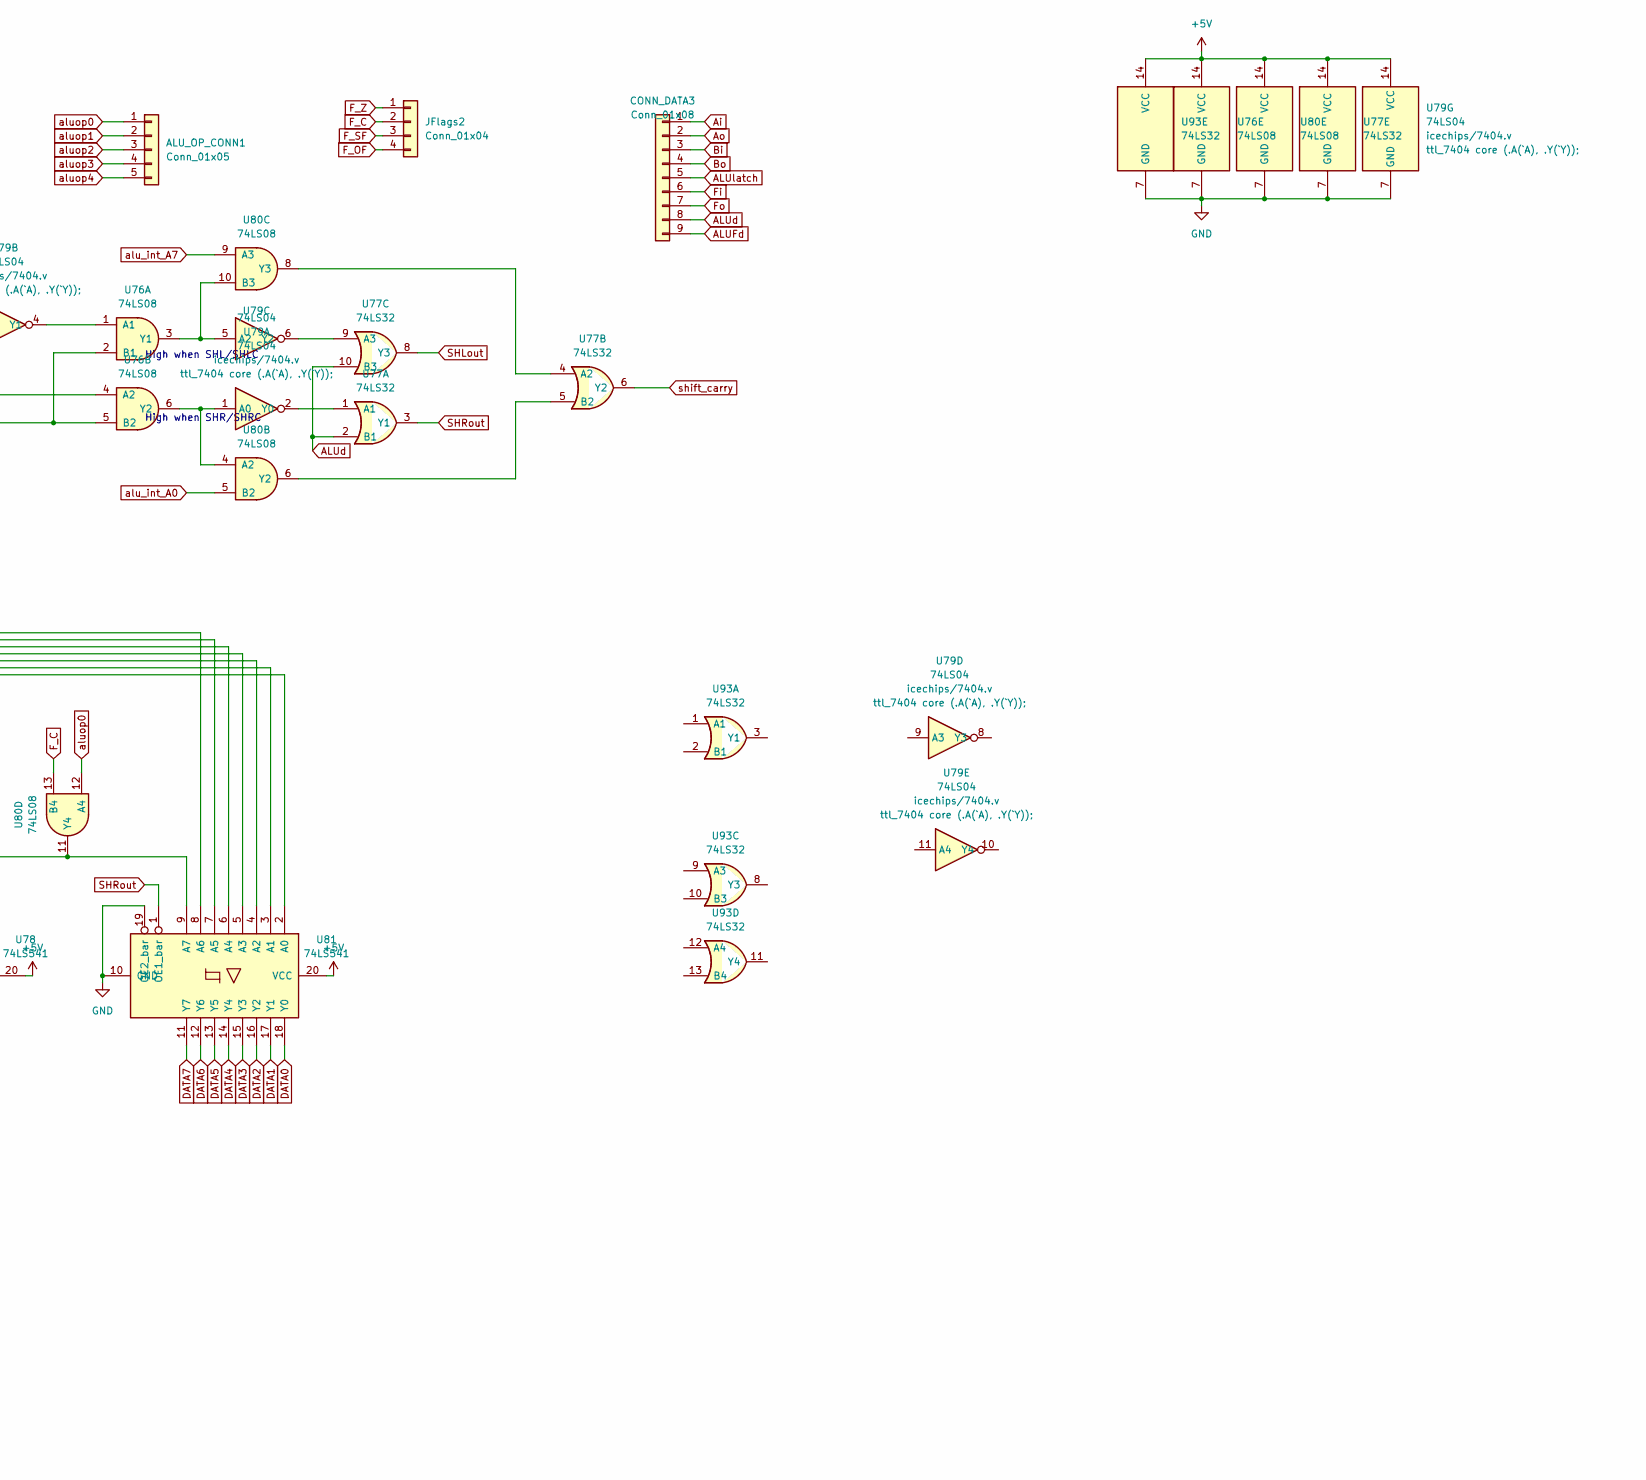
[picture p6: schematic alu.kicad_sch, part in row 1, column 2]

Parts:
ALU_DATA_BUS1: Conn_01x08; PinHeader_1x08_P2.54mm_Vertical
ALU_OP_CONN1: Conn_01x05; PinHeader_1x05_P2.54mm_Vertical
AROM_HIGH1: AT28C64-20PI; DIP-28_W15.24mm
AROM_LOW1: AT28C64-20PI; DIP-28_W15.24mm
CONN_DATA3: Conn_01x08; PinHeader_1x09_P2.54mm_Vertical
JFlags2: Conn_01x04; PinHeader_1x04_P1.00mm_Vertical
ML2, ML3, ML4, ML5, ML6: 74LS574; DIP-20_W7.62mm
U71, U72, U73, U74, U75, U78, U81: 74LS541; DIP-20_W7.62mm
U76, U80: 74LS08; DIP-14_W7.62mm
U77, U93: 74LS32; DIP-14_W7.62mm
U79: 74LS04; DIP-14_W7.62mm

Connections:
+5V: AROM_HIGH1.27 (/WE), AROM_HIGH1.28 (VCC), AROM_LOW1.27 (/WE), AROM_LOW1.28 (VCC), ML2.20 (VCC), ML3.20 (VCC), ML4.20 (VCC), ML5.20 (VCC), ML6.20 (VCC), U71.20 (VCC), U72.20 (VCC), U73.20 (VCC), U74.20 (VCC), U75.20 (VCC), U76.14 (VCC), U77.14 (VCC), U78.20 (VCC), U79.14 (VCC), U80.14 (VCC), U81.20 (VCC), U93.14 (VCC); also elsewhere on the board
ALUFd: CONN_DATA3.9, U75.1 (OE1_bar); also elsewhere on the board
ALUd: CONN_DATA3.8, U73.1 (OE1_bar), U77.2 (B1), U77.10 (B3); also elsewhere on the board
ALUlatch: CONN_DATA3.5, ML4.11 (CLK), ML6.11 (CLK); also elsewhere on the board
Ai: CONN_DATA3.1, ML3.11 (CLK); also elsewhere on the board
Ao: CONN_DATA3.2, U72.1 (OE1_bar); also elsewhere on the board
Bi: CONN_DATA3.3, ML5.11 (CLK); also elsewhere on the board
Bo: CONN_DATA3.4, U74.1 (OE1_bar); also elsewhere on the board
DATA0: ALU_DATA_BUS1.1, ML2.2 (D0), ML3.2 (D0), ML5.2 (D0), U71.18 (Y0), U72.18 (Y0), U73.18 (Y0), U74.18 (Y0), U75.18 (Y0), U78.18 (Y0), U81.18 (Y0); also elsewhere on the board
DATA1: ALU_DATA_BUS1.2, ML2.3 (D1), ML3.3 (D1), ML5.3 (D1), U71.17 (Y1), U72.17 (Y1), U73.17 (Y1), U74.17 (Y1), U75.17 (Y1), U78.17 (Y1), U81.17 (Y1); also elsewhere on the board
DATA2: ALU_DATA_BUS1.3, ML2.4 (D2), ML3.4 (D2), ML5.4 (D2), U71.16 (Y2), U72.16 (Y2), U73.16 (Y2), U74.16 (Y2), U75.16 (Y2), U78.16 (Y2), U81.16 (Y2); also elsewhere on the board
DATA3: ALU_DATA_BUS1.4, ML2.5 (D3), ML3.5 (D3), ML5.5 (D3), U71.15 (Y3), U72.15 (Y3), U73.15 (Y3), U74.15 (Y3), U75.15 (Y3), U78.15 (Y3), U81.15 (Y3); also elsewhere on the board
DATA4: ALU_DATA_BUS1.5, ML2.6 (D4), ML3.6 (D4), ML5.6 (D4), U71.14 (Y4), U72.14 (Y4), U73.14 (Y4), U74.14 (Y4), U75.14 (Y4), U78.14 (Y4), U81.14 (Y4); also elsewhere on the board
DATA5: ALU_DATA_BUS1.6, ML2.7 (D5), ML3.7 (D5), ML5.7 (D5), U71.13 (Y5), U72.13 (Y5), U73.13 (Y5), U74.13 (Y5), U75.13 (Y5), U78.13 (Y5), U81.13 (Y5); also elsewhere on the board
DATA6: ALU_DATA_BUS1.7, ML2.8 (D6), ML3.8 (D6), ML5.8 (D6), U71.12 (Y6), U72.12 (Y6), U73.12 (Y6), U74.12 (Y6), U75.12 (Y6), U78.12 (Y6), U81.12 (Y6); also elsewhere on the board
DATA7: ALU_DATA_BUS1.8, ML2.9 (D7), ML3.9 (D7), ML5.9 (D7), U71.11 (Y7), U72.11 (Y7), U73.11 (Y7), U74.11 (Y7), U75.11 (Y7), U78.11 (Y7), U81.11 (Y7); also elsewhere on the board
F_C: AROM_LOW1.2 (A12), JFlags2.2, ML2.19 (Y0), U71.2 (A0), U80.13 (B4); also elsewhere on the board
F_OF: JFlags2.4, ML2.16 (Y3), U71.5 (A3); also elsewhere on the board
F_SF: JFlags2.3, ML2.17 (Y2), U71.4 (A2); also elsewhere on the board
F_Z: JFlags2.1, ML2.18 (Y1), U71.3 (A1), U93.5 (B2); also elsewhere on the board
Fi: CONN_DATA3.6, ML2.11 (CLK); also elsewhere on the board
Fo: CONN_DATA3.7, U71.1 (OE1_bar); also elsewhere on the board
GND: AROM_HIGH1.14 (GND), AROM_HIGH1.20 (/CE), AROM_HIGH1.22 (/OE), AROM_LOW1.14 (GND), AROM_LOW1.20 (/CE), AROM_LOW1.22 (/OE), ML2.1 (OE_bar), ML2.10 (GND), ML3.1 (OE_bar), ML3.10 (GND), ML4.1 (OE_bar), ML4.10 (GND), ML5.1 (OE_bar), ML5.10 (GND), ML6.1 (OE_bar), ML6.10 (GND), U71.10 (GND), U71.19 (OE2_bar), U72.10 (GND), U72.19 (OE2_bar), U73.10 (GND), U73.19 (OE2_bar), U74.10 (GND), U74.19 (OE2_bar), U75.6 (A4), U75.7 (A5), U75.8 (A6), U75.9 (A7), U75.10 (GND), U75.19 (OE2_bar), U76.7 (GND), U77.7 (GND), U78.10 (GND), U78.19 (OE2_bar), U79.7 (GND), U80.7 (GND), U81.10 (GND), U81.19 (OE2_bar), U93.7 (GND); also elsewhere on the board
IR0: ALU_OP_CONN1.1, AROM_HIGH1.25 (A8), AROM_LOW1.25 (A8), U79.13 (A5), U80.12 (A4); also elsewhere on the board
IR1: ALU_OP_CONN1.2, AROM_HIGH1.24 (A9), AROM_LOW1.24 (A9), U76.4 (A2), U79.3 (A1); also elsewhere on the board
IR2: ALU_OP_CONN1.3, AROM_HIGH1.21 (A10), AROM_LOW1.21 (A10), U76.12 (A4); also elsewhere on the board
IR3: ALU_OP_CONN1.4, AROM_HIGH1.23 (A11), AROM_LOW1.23 (A11), U76.13 (B4); also elsewhere on the board
IR4: ALU_OP_CONN1.5; also elsewhere on the board
unnamed: AROM_HIGH1.2 (A12), AROM_LOW1.16 (D4)
unnamed: AROM_HIGH1.3 (A7), ML6.12 (Y7)
unnamed: AROM_HIGH1.4 (A6), ML6.13 (Y6)
unnamed: AROM_HIGH1.5 (A5), ML6.14 (Y5)
unnamed: AROM_HIGH1.6 (A4), ML6.15 (Y4)
unnamed: AROM_HIGH1.8 (A2), ML4.13 (Y6), U78.9 (A7), U81.7 (A5)
unnamed: AROM_HIGH1.9 (A1), ML4.14 (Y5), U78.8 (A6), U81.6 (A4)
unnamed: AROM_HIGH1.10 (A0), ML4.15 (Y4), U78.7 (A5), U81.5 (A3)
unnamed: AROM_HIGH1.11 (D0), U73.6 (A4)
unnamed: AROM_HIGH1.12 (D1), U73.7 (A5)
unnamed: AROM_HIGH1.13 (D2), U73.8 (A6)
unnamed: AROM_HIGH1.15 (D3), U73.9 (A7)
unnamed: AROM_HIGH1.16 (D4), U77.13 (B4)
unnamed: AROM_HIGH1.17 (D5), U76.9 (A3)
unnamed: AROM_HIGH1.18 (D6), U75.4 (A2)
unnamed: AROM_HIGH1.19 (D7), U75.5 (A3)
unnamed: AROM_LOW1.3 (A7), ML6.16 (Y3)
unnamed: AROM_LOW1.4 (A6), ML6.17 (Y2)
unnamed: AROM_LOW1.5 (A5), ML6.18 (Y1)
unnamed: AROM_LOW1.6 (A4), ML6.19 (Y0)
unnamed: AROM_LOW1.7 (A3), ML4.16 (Y3), U78.6 (A4), U81.4 (A2)
unnamed: AROM_LOW1.8 (A2), ML4.17 (Y2), U78.5 (A3), U81.3 (A1)
unnamed: AROM_LOW1.9 (A1), ML4.18 (Y1), U78.4 (A2), U81.2 (A0)
unnamed: AROM_LOW1.11 (D0), U73.2 (A0)
unnamed: AROM_LOW1.12 (D1), U73.3 (A1)
unnamed: AROM_LOW1.13 (D2), U73.4 (A2)
unnamed: AROM_LOW1.15 (D3), U73.5 (A3)
unnamed: AROM_LOW1.17 (D5), U76.10 (B3)
unnamed: ML2.12 (Y7), U71.9 (A7)
unnamed: ML2.13 (Y6), U71.8 (A6)
unnamed: ML2.14 (Y5), U71.7 (A5)
unnamed: ML2.15 (Y4), U71.6 (A4)
unnamed: ML3.12 (Y7), ML4.9 (D7), U72.9 (A7)
unnamed: ML3.13 (Y6), ML4.8 (D6), U72.8 (A6)
unnamed: ML3.14 (Y5), ML4.7 (D5), U72.7 (A5)
unnamed: ML3.15 (Y4), ML4.6 (D4), U72.6 (A4)
unnamed: ML3.16 (Y3), ML4.5 (D3), U72.5 (A3)
unnamed: ML3.17 (Y2), ML4.4 (D2), U72.4 (A2)
unnamed: ML3.18 (Y1), ML4.3 (D1), U72.3 (A1)
unnamed: ML3.19 (Y0), ML4.2 (D0), U72.2 (A0)
unnamed: ML5.12 (Y7), ML6.9 (D7), U74.9 (A7)
unnamed: ML5.13 (Y6), ML6.8 (D6), U74.8 (A6)
unnamed: ML5.14 (Y5), ML6.7 (D5), U74.7 (A5)
unnamed: ML5.15 (Y4), ML6.6 (D4), U74.6 (A4)
unnamed: ML5.16 (Y3), ML6.5 (D3), U74.5 (A3)
unnamed: ML5.17 (Y2), ML6.4 (D2), U74.4 (A2)
unnamed: ML5.18 (Y1), ML6.3 (D1), U74.3 (A1)
unnamed: ML5.19 (Y0), ML6.2 (D0), U74.2 (A0)
unnamed: U75.2 (A0), U77.11 (Y4)
unnamed: U75.3 (A1), U80.3 (Y1)
unnamed: U76.1 (A1), U79.4 (Y1)
unnamed: U76.3 (Y1), U79.5 (A2), U80.10 (B3)
unnamed: U76.6 (Y2), U79.1 (A0), U80.4 (A2)
unnamed: U76.8 (Y3), U80.1 (A1)
unnamed: U76.2 (B1), U76.5 (B2), U76.11 (Y4)
unnamed: U77.1 (A1), U79.2 (Y0)
unnamed: U77.4 (A2), U80.8 (Y3)
unnamed: U77.5 (B2), U80.6 (Y2)
unnamed: U77.9 (A3), U79.6 (Y2)
unnamed: U78.2 (A0), U80.11 (Y4), U81.9 (A7)
unnamed: U79.12 (Y5), U93.4 (A2)
unnamed: U80.2 (B1), U93.6 (Y2)
SHLout: U77.8 (Y3), U78.1 (OE1_bar)
SHRout: U77.3 (Y1), U81.1 (OE1_bar)
alu_int_A0: AROM_LOW1.10 (A0), ML4.19 (Y0), U78.3 (A1), U80.5 (B2)
alu_int_A7: AROM_HIGH1.7 (A3), ML4.12 (Y7), U80.9 (A3), U81.8 (A6)
shift_carry: U77.6 (Y2), U77.12 (A4)

Notes on the sheet:
High when SHR/SHRC
High when SHL/SHLC

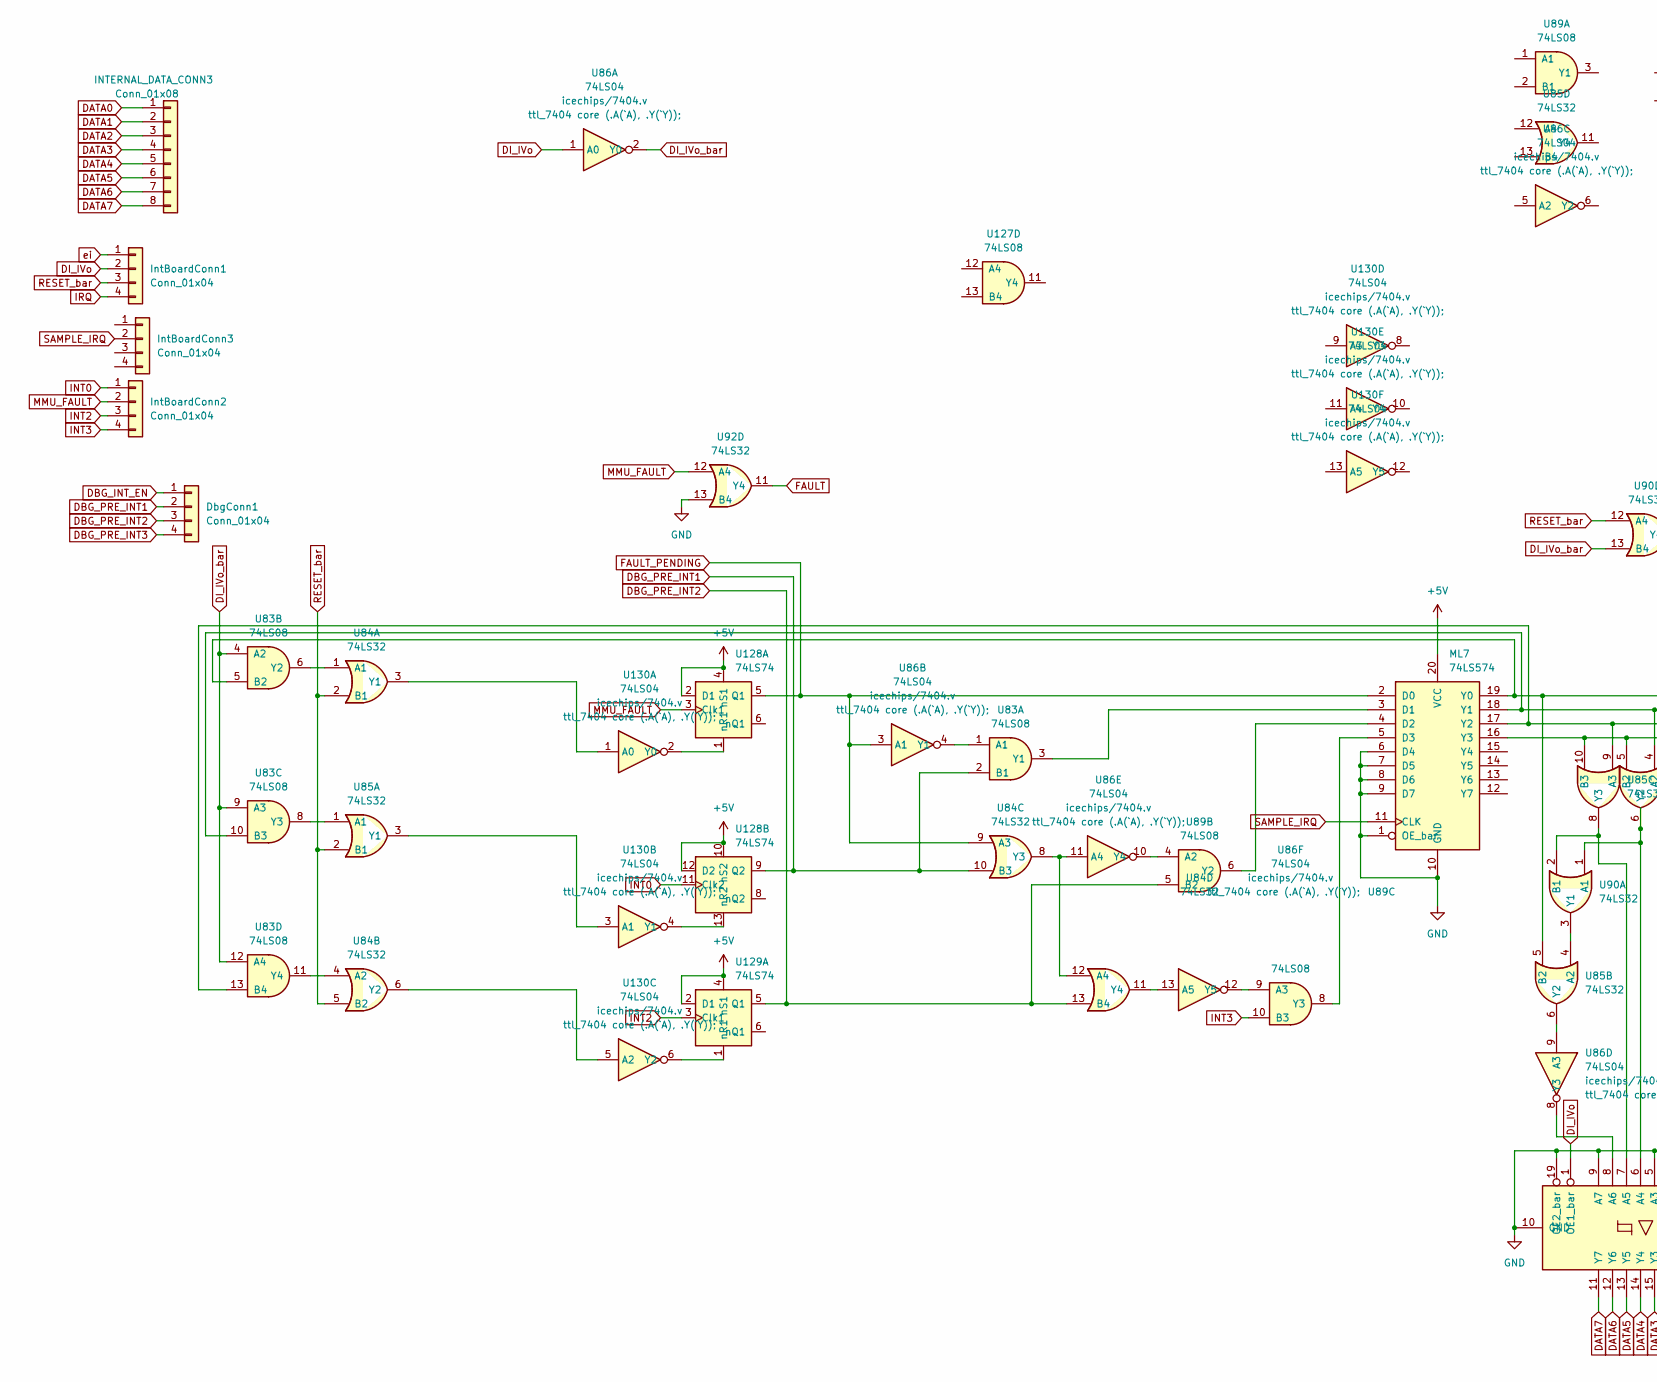
[picture p7: schematic interrupts.kicad_sch, part in row 1, column 1]

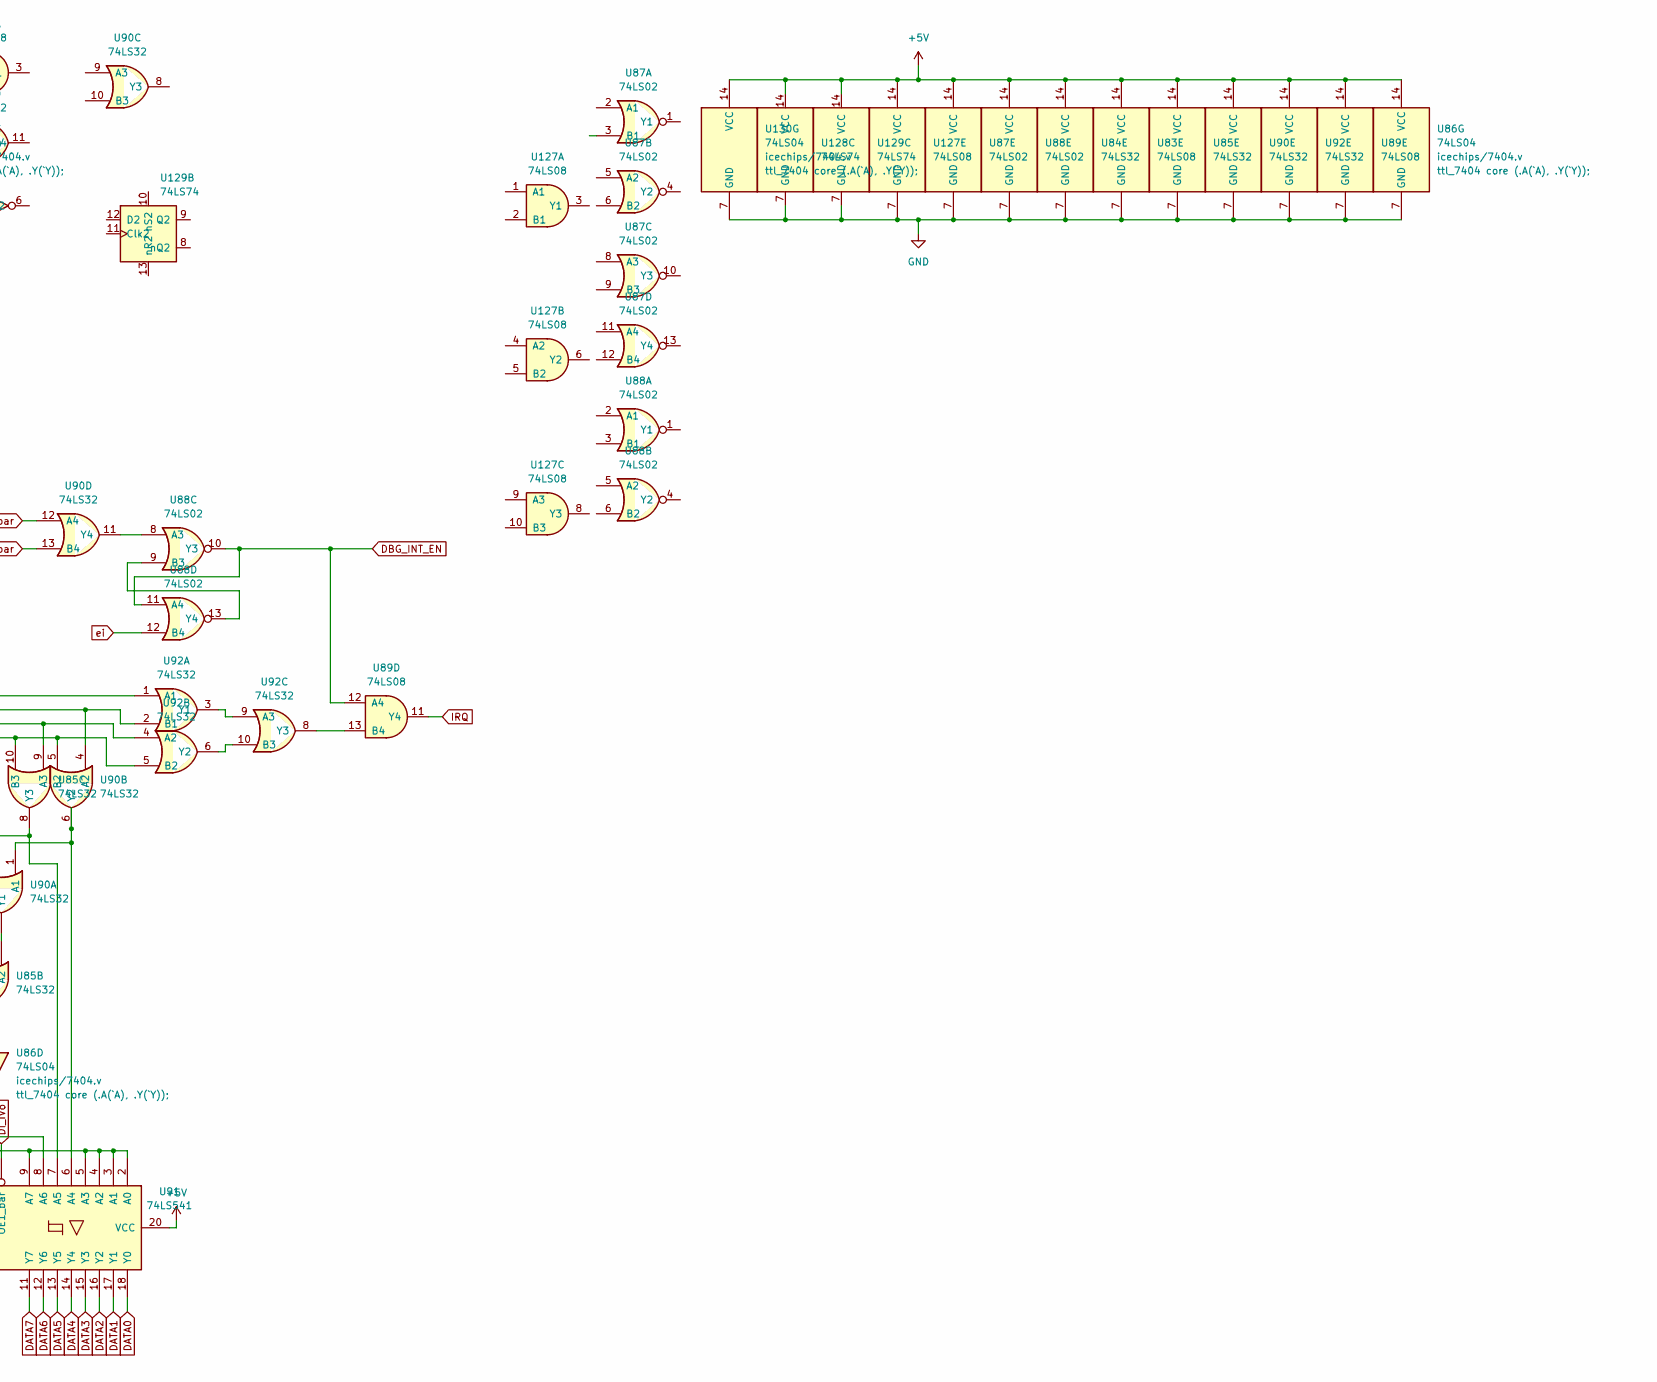
[picture p8: schematic interrupts.kicad_sch, part in row 1, column 2]

Parts:
DbgConn1: Conn_01x04; PinHeader_1x04_P1.00mm_Vertical
INTERNAL_DATA_CONN3: Conn_01x08; PinHeader_1x08_P2.54mm_Vertical
IntBoardConn1, IntBoardConn2, IntBoardConn3: Conn_01x04; PinHeader_1x04_P1.00mm_Vertical
ML7: 74LS574; DIP-20_W7.62mm
U83, U89, U127: 74LS08; DIP-14_W7.62mm
U84, U85, U90, U92: 74LS32; DIP-14_W7.62mm
U86, U130: 74LS04; DIP-14_W7.62mm
U87, U88: 74LS02; DIP-14_W7.62mm
U91: 74LS541; DIP-20_W7.62mm
U128, U129: 74LS74; DIP-14_W7.62mm

Connections:
+5V: ML7.20 (VCC), U83.14 (VCC), U84.14 (VCC), U85.14 (VCC), U86.14 (VCC), U87.14 (VCC), U88.14 (VCC), U89.14 (VCC), U90.14 (VCC), U91.20 (VCC), U92.14 (VCC), U127.14 (VCC), U128.2 (D1), U128.4 (nS1), U128.10 (nS2), U128.12 (D2), U128.14 (VCC), U129.2 (D1), U129.4 (nS1), U129.14 (VCC), U130.14 (VCC); also elsewhere on the board
DATA0: INTERNAL_DATA_CONN3.1, U91.18 (Y0); also elsewhere on the board
DATA1: INTERNAL_DATA_CONN3.2, U91.17 (Y1); also elsewhere on the board
DATA2: INTERNAL_DATA_CONN3.3, U91.16 (Y2); also elsewhere on the board
DATA3: INTERNAL_DATA_CONN3.4, U91.15 (Y3); also elsewhere on the board
DATA4: INTERNAL_DATA_CONN3.5, U91.14 (Y4); also elsewhere on the board
DATA5: INTERNAL_DATA_CONN3.6, U91.13 (Y5); also elsewhere on the board
DATA6: INTERNAL_DATA_CONN3.7, U91.12 (Y6); also elsewhere on the board
DATA7: INTERNAL_DATA_CONN3.8, U91.11 (Y7); also elsewhere on the board
DBG_INT_EN: DbgConn1.1, U88.10 (Y3), U88.11 (A4), U89.12 (A4); also elsewhere on the board
DBG_PRE_INT1: DbgConn1.2, U83.2 (B1), U84.10 (B3), U128.9 (Q2); also elsewhere on the board
DBG_PRE_INT2: DbgConn1.3, U84.13 (B4), U89.5 (B2), U129.5 (Q1); also elsewhere on the board
DBG_PRE_INT3: DbgConn1.4; also elsewhere on the board
DI_IVo: IntBoardConn1.2, U86.1 (A0), U91.1 (OE1_bar); also elsewhere on the board
DI_IVo_bar: U83.4 (A2), U83.9 (A3), U83.12 (A4), U86.2 (Y0), U90.13 (B4)
FAULT: U92.11 (Y4); also elsewhere on the board
FAULT_PENDING: ML7.2 (D0), U84.9 (A3), U86.3 (A1), U128.5 (Q1); also elsewhere on the board
GND: ML7.1 (OE_bar), ML7.6 (D4), ML7.7 (D5), ML7.8 (D6), ML7.9 (D7), ML7.10 (GND), U83.7 (GND), U84.7 (GND), U85.7 (GND), U86.7 (GND), U87.7 (GND), U88.7 (GND), U89.7 (GND), U90.7 (GND), U91.2 (A0), U91.3 (A1), U91.4 (A2), U91.5 (A3), U91.9 (A7), U91.10 (GND), U91.19 (OE2_bar), U92.7 (GND), U92.13 (B4), U127.7 (GND), U128.7 (GND), U129.7 (GND), U130.7 (GND); also elsewhere on the board
INT0: IntBoardConn2.1, U128.11 (Clk2)
INT2: IntBoardConn2.3, U129.3 (Clk1)
INT3: IntBoardConn2.4, U89.10 (B3)
IRQ: IntBoardConn1.4, U89.11 (Y4); also elsewhere on the board
MMU_FAULT: IntBoardConn2.2, U92.12 (A4), U128.3 (Clk1); also elsewhere on the board
unnamed: ML7.3 (D1), U83.3 (Y1)
unnamed: ML7.4 (D2), U89.6 (Y2)
unnamed: ML7.5 (D3), U89.8 (Y3)
unnamed: ML7.16 (Y3), U85.10 (B3), U90.5 (B2), U92.5 (B2)
unnamed: ML7.17 (Y2), U83.13 (B4), U85.9 (A3), U92.4 (A2)
unnamed: ML7.18 (Y1), U83.10 (B3), U90.4 (A2), U92.2 (B1)
unnamed: ML7.19 (Y0), U83.5 (B2), U85.5 (B2), U92.1 (A1)
unnamed: U83.1 (A1), U86.4 (Y1)
unnamed: U83.6 (Y2), U84.1 (A1)
unnamed: U83.8 (Y3), U85.1 (A1)
unnamed: U83.11 (Y4), U84.4 (A2)
unnamed: U84.11 (Y4), U86.13 (A5)
unnamed: U84.8 (Y3), U84.12 (A4), U86.11 (A4)
unnamed: U85.4 (A2), U90.3 (Y1)
unnamed: U85.6 (Y2), U86.9 (A3)
unnamed: U85.8 (Y3), U90.2 (B1), U91.7 (A5)
unnamed: U86.8 (Y3), U91.8 (A6)
unnamed: U86.10 (Y4), U89.4 (A2)
unnamed: U86.12 (Y5), U89.9 (A3)
unnamed: U88.8 (A3), U90.11 (Y4)
unnamed: U88.9 (B3), U88.13 (Y4)
unnamed: U89.13 (B4), U92.8 (Y3)
unnamed: U90.1 (A1), U90.6 (Y2), U91.6 (A4)
unnamed: U92.3 (Y1), U92.9 (A3)
unnamed: U92.6 (Y2), U92.10 (B3)
unnamed: U128.1 (nR1), U130.2 (Y0)
unnamed: U128.13 (nR2), U130.4 (Y1)
unnamed: U129.1 (nR1), U130.6 (Y2)
unnamed: U84.3 (Y1), U130.1 (A0)
unnamed: U85.3 (Y1), U130.3 (A1)
unnamed: U84.6 (Y2), U130.5 (A2)
RESET_bar: IntBoardConn1.3, U84.2 (B1), U84.5 (B2), U85.2 (B1), U90.12 (A4); also elsewhere on the board
SAMPLE_IRQ: IntBoardConn3.2, ML7.11 (CLK); also elsewhere on the board
ei: IntBoardConn1.1, U88.12 (B4); also elsewhere on the board
