romalik/cpu5/schematics/cpu5/cpu5.kicad_pcb

## KiCad design schematics/cpu5/cpu5.kicad_pcb (continued)

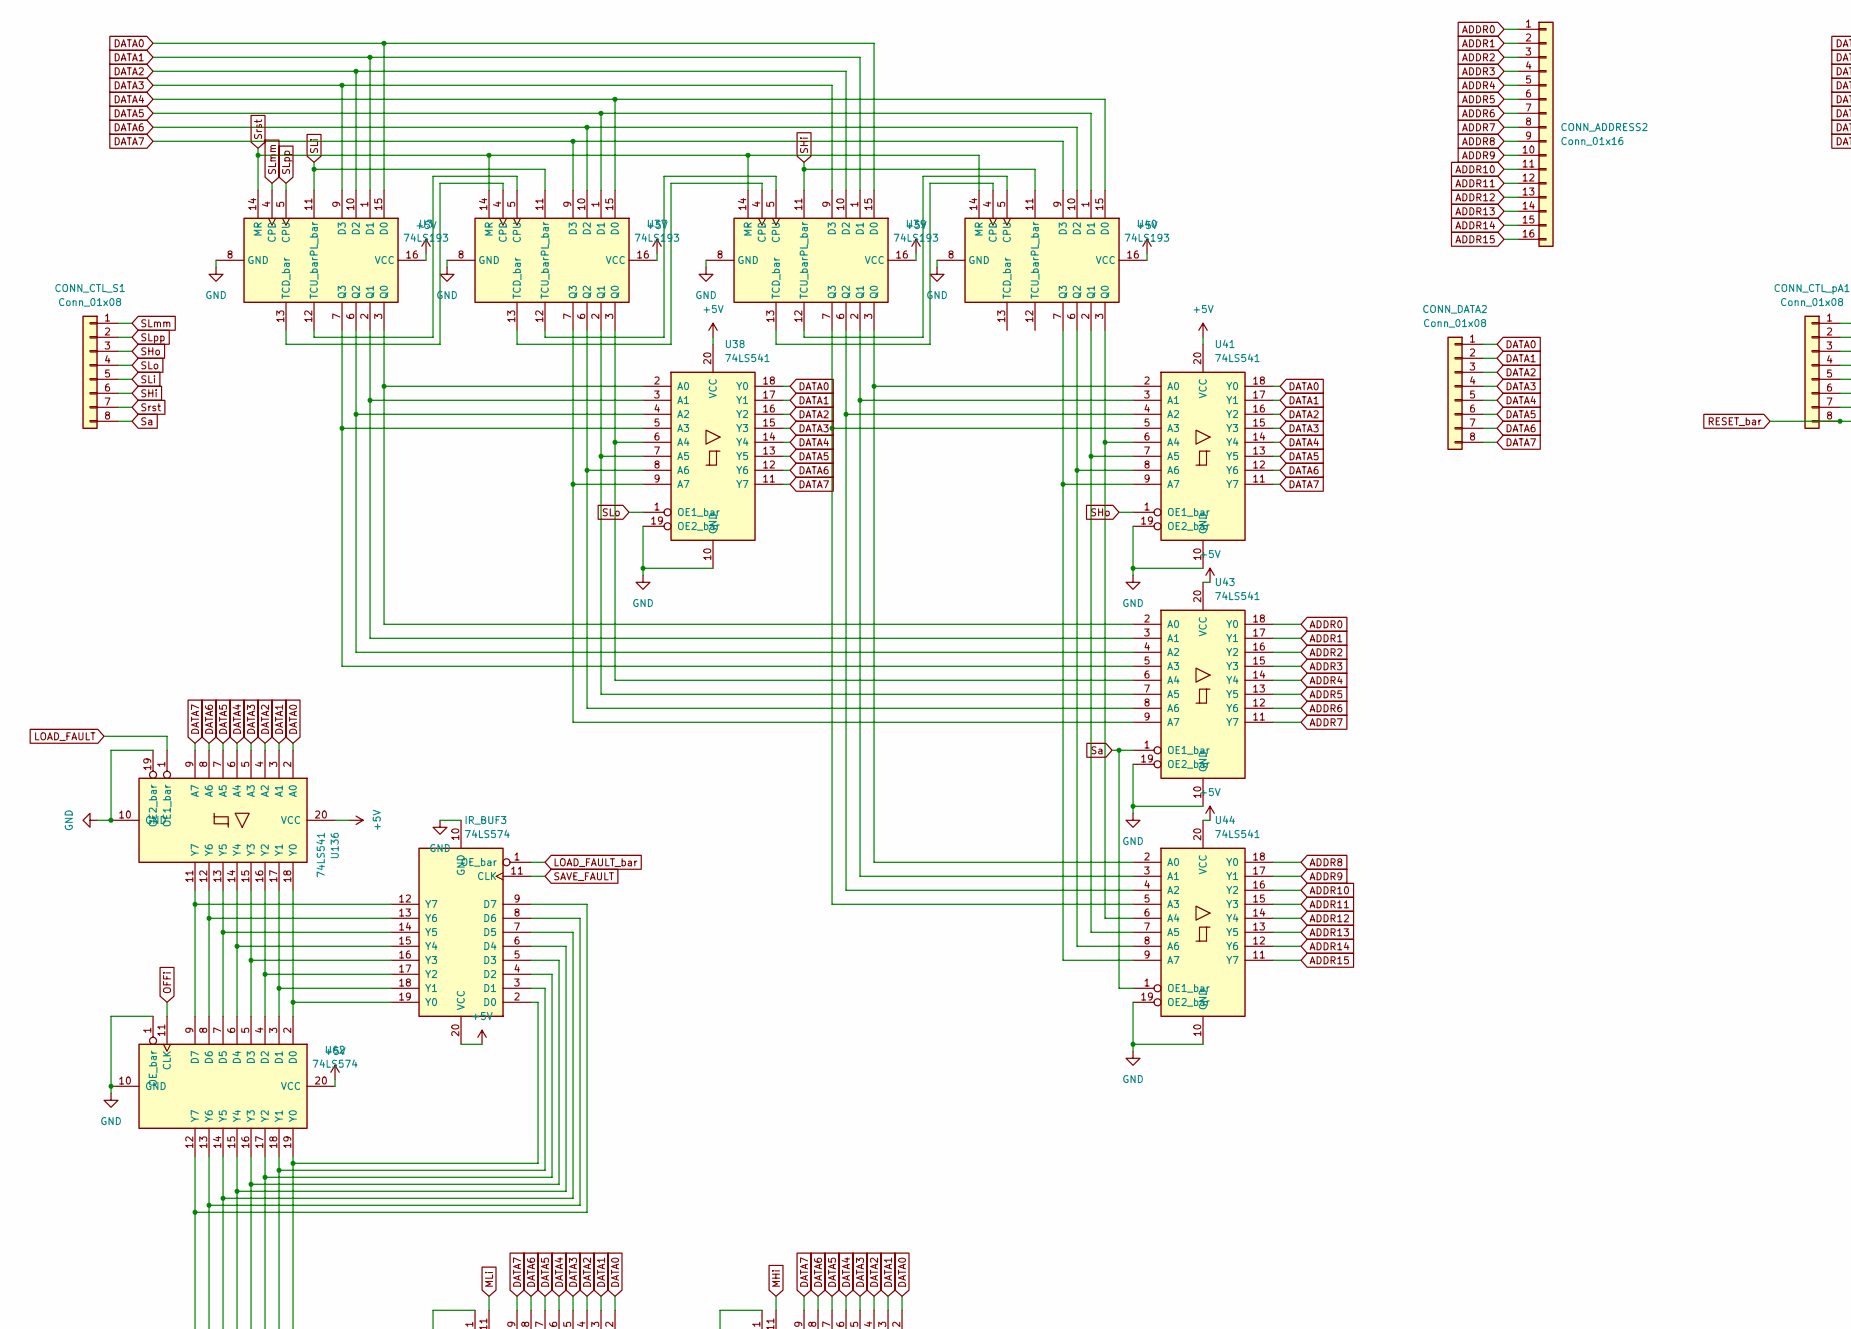
[picture p9: schematic registers.kicad_sch, part in row 1, column 1]

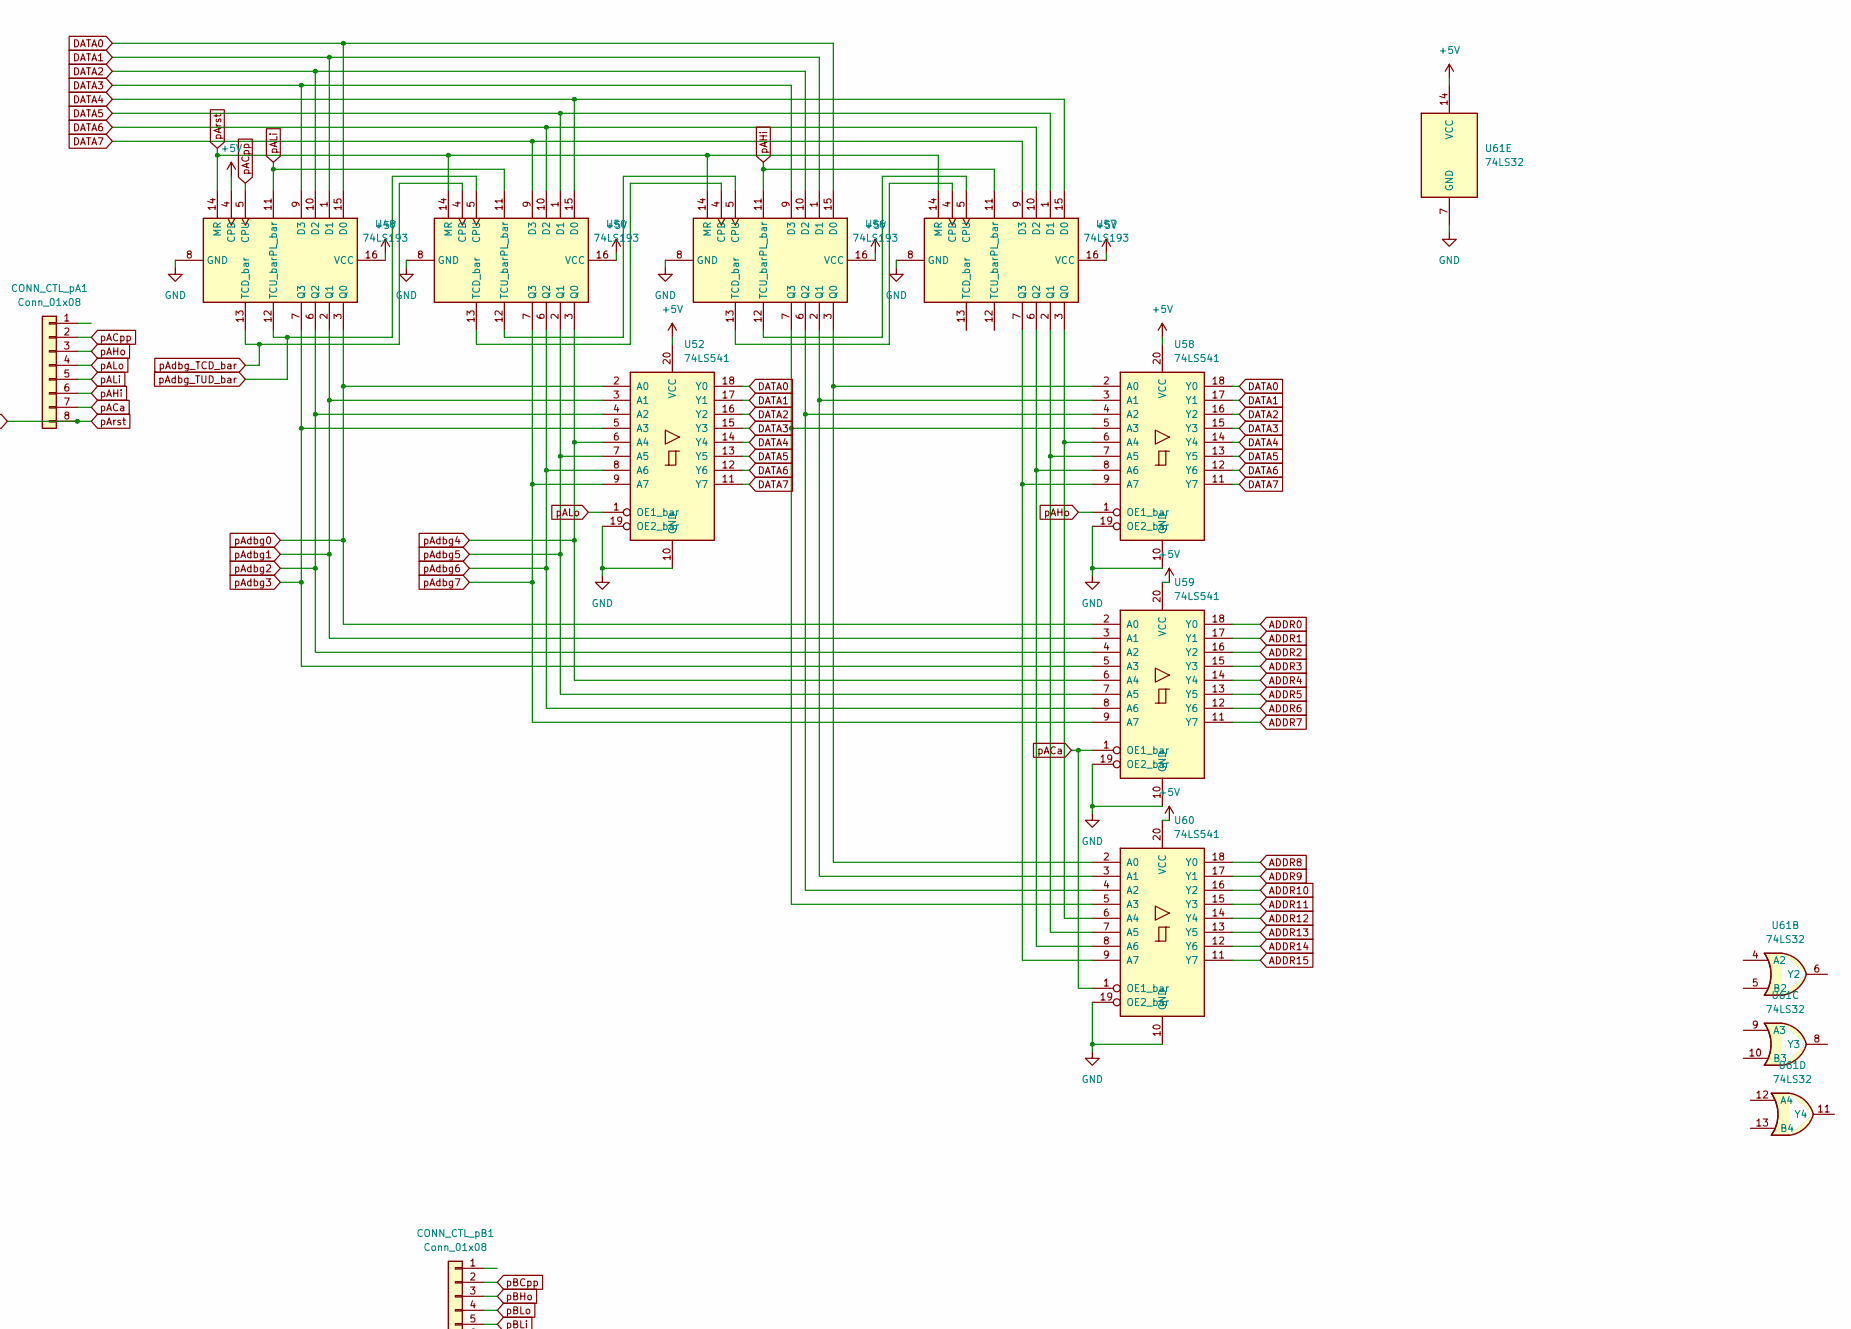
[picture p10: schematic registers.kicad_sch, part in row 1, column 2]

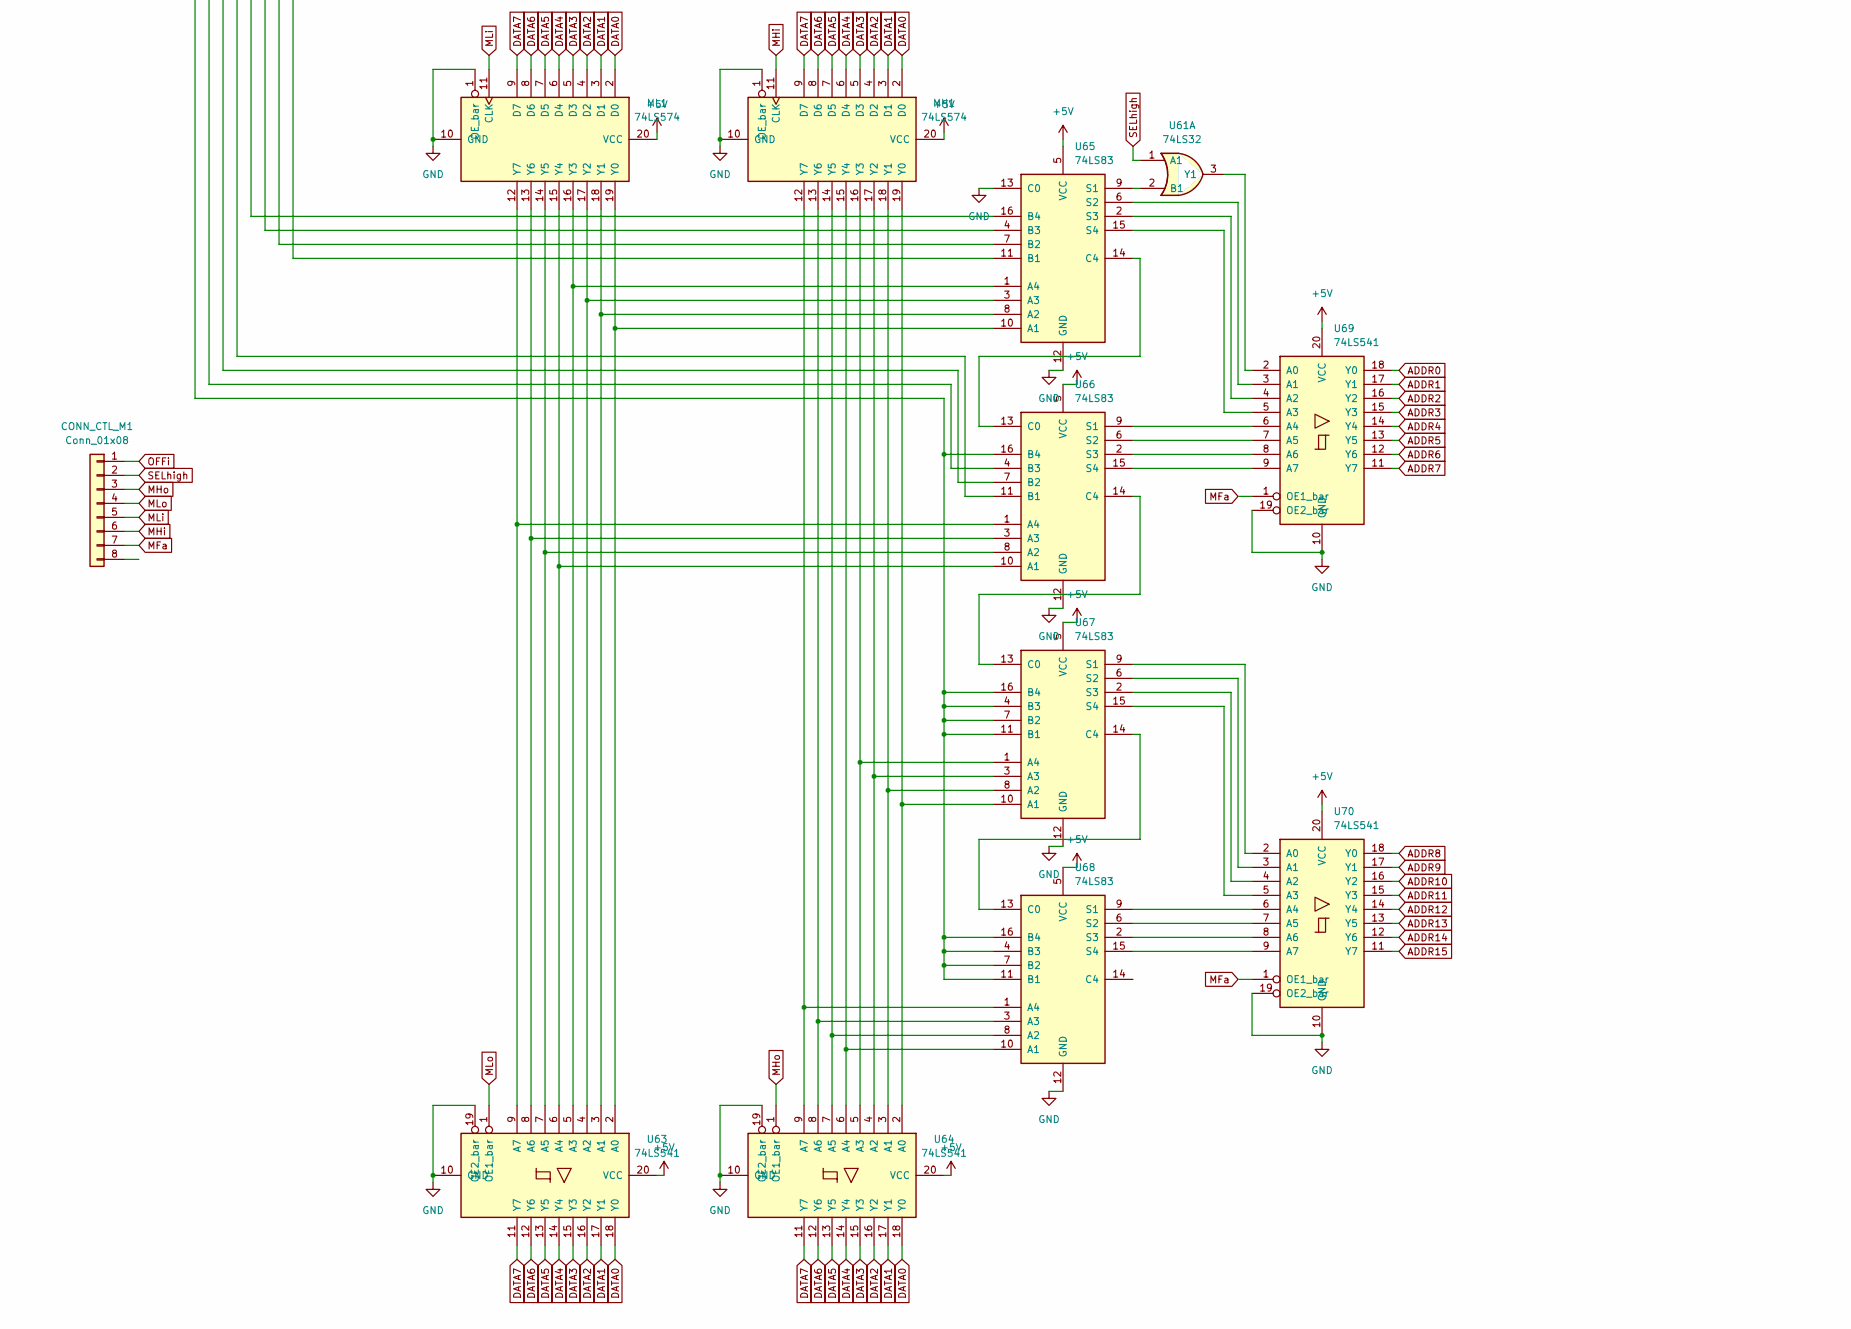
[picture p11: schematic registers.kicad_sch, part in row 2, column 1]

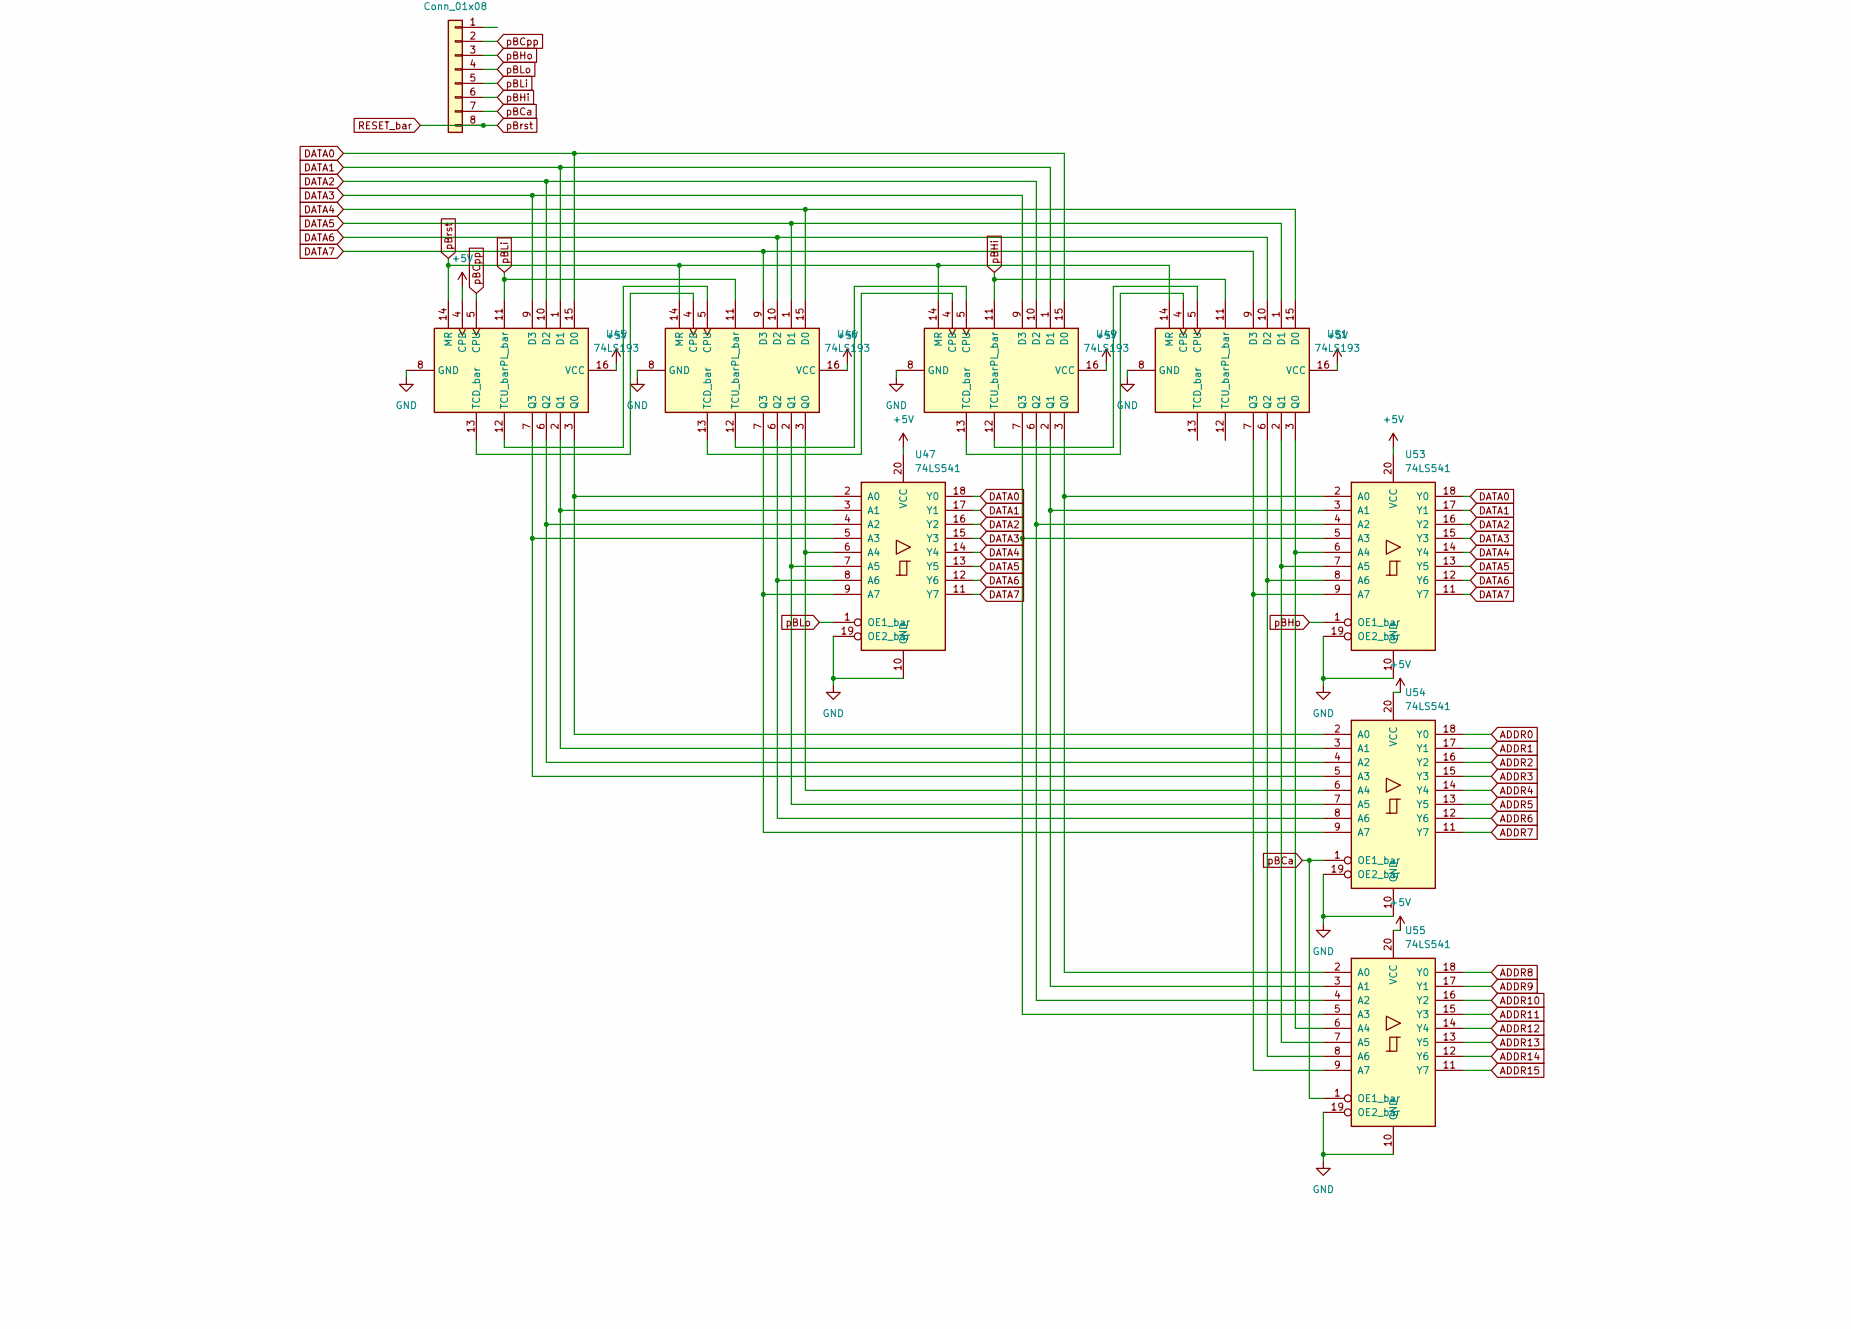
[picture p12: schematic registers.kicad_sch, part in row 2, column 2]

Parts:
CONN_ADDRESS2: Conn_01x16; PinHeader_1x16_P2.54mm_Vertical
CONN_CTL_M1: Conn_01x08; PinHeader_1x08_P2.54mm_Vertical
CONN_CTL_S1: Conn_01x08; PinHeader_1x08_P2.54mm_Vertical
CONN_CTL_pA1: Conn_01x08; PinHeader_1x08_P2.54mm_Vertical
CONN_CTL_pB1: Conn_01x08; PinHeader_1x08_P2.54mm_Vertical
CONN_DATA2: Conn_01x08; PinHeader_1x08_P2.54mm_Vertical
IR_BUF3: 74LS574; DIP-20_W7.62mm
MH1: 74LS574; DIP-20_W7.62mm
ML1: 74LS574; DIP-20_W7.62mm
U3, U37, U39, U40, U45, U46, U48, U49, U50, U51, U56, U57: 74LS193; DIP-16_W7.62mm
U38, U41, U43, U44, U47, U52, U53, U54, U55, U58, U59, U60, U63, U64, U69, U70, U136: 74LS541; DIP-20_W7.62mm
U61: 74LS32; DIP-14_W7.62mm
U62: 74LS574; DIP-20_W7.62mm
U65, U66, U67, U68: 74LS83; DIP-16_W7.62mm

Connections:
+5V: IR_BUF3.20 (VCC), MH1.20 (VCC), ML1.20 (VCC), U3.16 (VCC), U37.16 (VCC), U38.20 (VCC), U39.16 (VCC), U40.16 (VCC), U41.20 (VCC), U43.20 (VCC), U44.20 (VCC), U45.4 (CPD), U45.16 (VCC), U46.16 (VCC), U47.20 (VCC), U48.4 (CPD), U48.16 (VCC), U49.16 (VCC), U50.16 (VCC), U51.16 (VCC), U52.20 (VCC), U53.20 (VCC), U54.20 (VCC), U55.20 (VCC), U56.16 (VCC), U57.16 (VCC), U58.20 (VCC), U59.20 (VCC), U60.20 (VCC), U61.14 (VCC), U62.20 (VCC), U63.20 (VCC), U64.20 (VCC), U65.5 (VCC), U66.5 (VCC), U67.5 (VCC), U68.5 (VCC), U69.20 (VCC), U70.20 (VCC), U136.20 (VCC); also elsewhere on the board
ADDR0: CONN_ADDRESS2.1, U43.18 (Y0), U54.18 (Y0), U59.18 (Y0), U69.18 (Y0); also elsewhere on the board
ADDR1: CONN_ADDRESS2.2, U43.17 (Y1), U54.17 (Y1), U59.17 (Y1), U69.17 (Y1); also elsewhere on the board
ADDR2: CONN_ADDRESS2.3, U43.16 (Y2), U54.16 (Y2), U59.16 (Y2), U69.16 (Y2); also elsewhere on the board
ADDR3: CONN_ADDRESS2.4, U43.15 (Y3), U54.15 (Y3), U59.15 (Y3), U69.15 (Y3); also elsewhere on the board
ADDR4: CONN_ADDRESS2.5, U43.14 (Y4), U54.14 (Y4), U59.14 (Y4), U69.14 (Y4); also elsewhere on the board
ADDR5: CONN_ADDRESS2.6, U43.13 (Y5), U54.13 (Y5), U59.13 (Y5), U69.13 (Y5); also elsewhere on the board
ADDR6: CONN_ADDRESS2.7, U43.12 (Y6), U54.12 (Y6), U59.12 (Y6), U69.12 (Y6); also elsewhere on the board
ADDR7: CONN_ADDRESS2.8, U43.11 (Y7), U54.11 (Y7), U59.11 (Y7), U69.11 (Y7); also elsewhere on the board
ADDR8: CONN_ADDRESS2.9, U44.18 (Y0), U55.18 (Y0), U60.18 (Y0), U70.18 (Y0); also elsewhere on the board
ADDR9: CONN_ADDRESS2.10, U44.17 (Y1), U55.17 (Y1), U60.17 (Y1), U70.17 (Y1); also elsewhere on the board
ADDR10: CONN_ADDRESS2.11, U44.16 (Y2), U55.16 (Y2), U60.16 (Y2), U70.16 (Y2); also elsewhere on the board
ADDR11: CONN_ADDRESS2.12, U44.15 (Y3), U55.15 (Y3), U60.15 (Y3), U70.15 (Y3); also elsewhere on the board
ADDR12: CONN_ADDRESS2.13, U44.14 (Y4), U55.14 (Y4), U60.14 (Y4), U70.14 (Y4); also elsewhere on the board
ADDR13: CONN_ADDRESS2.14, U44.13 (Y5), U55.13 (Y5), U60.13 (Y5), U70.13 (Y5); also elsewhere on the board
ADDR14: CONN_ADDRESS2.15, U44.12 (Y6), U55.12 (Y6), U60.12 (Y6), U70.12 (Y6); also elsewhere on the board
ADDR15: CONN_ADDRESS2.16, U44.11 (Y7), U55.11 (Y7), U60.11 (Y7), U70.11 (Y7); also elsewhere on the board
DATA0: CONN_DATA2.1, MH1.2 (D0), ML1.2 (D0), U3.15 (D0), U38.18 (Y0), U39.15 (D0), U41.18 (Y0), U45.15 (D0), U47.18 (Y0), U48.15 (D0), U49.15 (D0), U52.18 (Y0), U53.18 (Y0), U56.15 (D0), U58.18 (Y0), U63.18 (Y0), U64.18 (Y0), U136.2 (A0); also elsewhere on the board
DATA1: CONN_DATA2.2, MH1.3 (D1), ML1.3 (D1), U3.1 (D1), U38.17 (Y1), U39.1 (D1), U41.17 (Y1), U45.1 (D1), U47.17 (Y1), U48.1 (D1), U49.1 (D1), U52.17 (Y1), U53.17 (Y1), U56.1 (D1), U58.17 (Y1), U63.17 (Y1), U64.17 (Y1), U136.3 (A1); also elsewhere on the board
DATA2: CONN_DATA2.3, MH1.4 (D2), ML1.4 (D2), U3.10 (D2), U38.16 (Y2), U39.10 (D2), U41.16 (Y2), U45.10 (D2), U47.16 (Y2), U48.10 (D2), U49.10 (D2), U52.16 (Y2), U53.16 (Y2), U56.10 (D2), U58.16 (Y2), U63.16 (Y2), U64.16 (Y2), U136.4 (A2); also elsewhere on the board
DATA3: CONN_DATA2.4, MH1.5 (D3), ML1.5 (D3), U3.9 (D3), U38.15 (Y3), U39.9 (D3), U41.15 (Y3), U45.9 (D3), U47.15 (Y3), U48.9 (D3), U49.9 (D3), U52.15 (Y3), U53.15 (Y3), U56.9 (D3), U58.15 (Y3), U63.15 (Y3), U64.15 (Y3), U136.5 (A3); also elsewhere on the board
DATA4: CONN_DATA2.5, MH1.6 (D4), ML1.6 (D4), U37.15 (D0), U38.14 (Y4), U40.15 (D0), U41.14 (Y4), U46.15 (D0), U47.14 (Y4), U50.15 (D0), U51.15 (D0), U52.14 (Y4), U53.14 (Y4), U57.15 (D0), U58.14 (Y4), U63.14 (Y4), U64.14 (Y4), U136.6 (A4); also elsewhere on the board
DATA5: CONN_DATA2.6, MH1.7 (D5), ML1.7 (D5), U37.1 (D1), U38.13 (Y5), U40.1 (D1), U41.13 (Y5), U46.1 (D1), U47.13 (Y5), U50.1 (D1), U51.1 (D1), U52.13 (Y5), U53.13 (Y5), U57.1 (D1), U58.13 (Y5), U63.13 (Y5), U64.13 (Y5), U136.7 (A5); also elsewhere on the board
DATA6: CONN_DATA2.7, MH1.8 (D6), ML1.8 (D6), U37.10 (D2), U38.12 (Y6), U40.10 (D2), U41.12 (Y6), U46.10 (D2), U47.12 (Y6), U50.10 (D2), U51.10 (D2), U52.12 (Y6), U53.12 (Y6), U57.10 (D2), U58.12 (Y6), U63.12 (Y6), U64.12 (Y6), U136.8 (A6); also elsewhere on the board
DATA7: CONN_DATA2.8, MH1.9 (D7), ML1.9 (D7), U37.9 (D3), U38.11 (Y7), U40.9 (D3), U41.11 (Y7), U46.9 (D3), U47.11 (Y7), U50.9 (D3), U51.9 (D3), U52.11 (Y7), U53.11 (Y7), U57.9 (D3), U58.11 (Y7), U63.11 (Y7), U64.11 (Y7), U136.9 (A7); also elsewhere on the board
GND: IR_BUF3.10 (GND), MH1.1 (OE_bar), MH1.10 (GND), ML1.1 (OE_bar), ML1.10 (GND), U3.8 (GND), U37.8 (GND), U38.10 (GND), U38.19 (OE2_bar), U39.8 (GND), U40.8 (GND), U41.10 (GND), U41.19 (OE2_bar), U43.10 (GND), U43.19 (OE2_bar), U44.10 (GND), U44.19 (OE2_bar), U45.8 (GND), U46.8 (GND), U47.10 (GND), U47.19 (OE2_bar), U48.8 (GND), U49.8 (GND), U50.8 (GND), U51.8 (GND), U52.10 (GND), U52.19 (OE2_bar), U53.10 (GND), U53.19 (OE2_bar), U54.10 (GND), U54.19 (OE2_bar), U55.10 (GND), U55.19 (OE2_bar), U56.8 (GND), U57.8 (GND), U58.10 (GND), U58.19 (OE2_bar), U59.10 (GND), U59.19 (OE2_bar), U60.10 (GND), U60.19 (OE2_bar), U61.7 (GND), U62.1 (OE_bar), U62.10 (GND), U63.10 (GND), U63.19 (OE2_bar), U64.10 (GND), U64.19 (OE2_bar), U65.12 (GND), U65.13 (C0), U66.12 (GND), U67.12 (GND), U68.12 (GND), U69.10 (GND), U69.19 (OE2_bar), U70.10 (GND), U70.19 (OE2_bar), U136.10 (GND), U136.19 (OE2_bar); also elsewhere on the board
LOAD_FAULT: U136.1 (OE1_bar); also elsewhere on the board
LOAD_FAULT_bar: IR_BUF3.1 (OE_bar); also elsewhere on the board
MFa: CONN_CTL_M1.7, U69.1 (OE1_bar), U70.1 (OE1_bar); also elsewhere on the board
MHi: CONN_CTL_M1.6, MH1.11 (CLK); also elsewhere on the board
MHo: CONN_CTL_M1.3, U64.1 (OE1_bar); also elsewhere on the board
MLi: CONN_CTL_M1.5, ML1.11 (CLK); also elsewhere on the board
MLo: CONN_CTL_M1.4, U63.1 (OE1_bar); also elsewhere on the board
unnamed: IR_BUF3.2 (D0), U62.19 (Y0), U65.11 (B1)
unnamed: IR_BUF3.3 (D1), U62.18 (Y1), U65.7 (B2)
unnamed: IR_BUF3.4 (D2), U62.17 (Y2), U65.4 (B3)
unnamed: IR_BUF3.5 (D3), U62.16 (Y3), U65.16 (B4)
unnamed: IR_BUF3.6 (D4), U62.15 (Y4), U66.11 (B1)
unnamed: IR_BUF3.7 (D5), U62.14 (Y5), U66.7 (B2)
unnamed: IR_BUF3.8 (D6), U62.13 (Y6), U66.4 (B3)
unnamed: IR_BUF3.9 (D7), U62.12 (Y7), U66.16 (B4), U67.4 (B3), U67.7 (B2), U67.11 (B1), U67.16 (B4), U68.4 (B3), U68.7 (B2), U68.11 (B1), U68.16 (B4)
unnamed: IR_BUF3.12 (Y7), U62.9 (D7), U136.11 (Y7)
unnamed: IR_BUF3.13 (Y6), U62.8 (D6), U136.12 (Y6)
unnamed: IR_BUF3.14 (Y5), U62.7 (D5), U136.13 (Y5)
unnamed: IR_BUF3.15 (Y4), U62.6 (D4), U136.14 (Y4)
unnamed: IR_BUF3.16 (Y3), U62.5 (D3), U136.15 (Y3)
unnamed: IR_BUF3.17 (Y2), U62.4 (D2), U136.16 (Y2)
unnamed: IR_BUF3.18 (Y1), U62.3 (D1), U136.17 (Y1)
unnamed: IR_BUF3.19 (Y0), U62.2 (D0), U136.18 (Y0)
unnamed: MH1.12 (Y7), U64.9 (A7), U68.1 (A4)
unnamed: MH1.13 (Y6), U64.8 (A6), U68.3 (A3)
unnamed: MH1.14 (Y5), U64.7 (A5), U68.8 (A2)
unnamed: MH1.15 (Y4), U64.6 (A4), U68.10 (A1)
unnamed: MH1.16 (Y3), U64.5 (A3), U67.1 (A4)
unnamed: MH1.17 (Y2), U64.4 (A2), U67.3 (A3)
unnamed: MH1.18 (Y1), U64.3 (A1), U67.8 (A2)
unnamed: MH1.19 (Y0), U64.2 (A0), U67.10 (A1)
unnamed: ML1.12 (Y7), U63.9 (A7), U66.1 (A4)
unnamed: ML1.13 (Y6), U63.8 (A6), U66.3 (A3)
unnamed: ML1.14 (Y5), U63.7 (A5), U66.8 (A2)
unnamed: ML1.15 (Y4), U63.6 (A4), U66.10 (A1)
unnamed: ML1.16 (Y3), U63.5 (A3), U65.1 (A4)
unnamed: ML1.17 (Y2), U63.4 (A2), U65.3 (A3)
unnamed: ML1.18 (Y1), U63.3 (A1), U65.8 (A2)
unnamed: ML1.19 (Y0), U63.2 (A0), U65.10 (A1)
unnamed: U3.2 (Q1), U38.3 (A1), U43.3 (A1)
unnamed: U3.3 (Q0), U38.2 (A0), U43.2 (A0)
unnamed: U3.6 (Q2), U38.4 (A2), U43.4 (A2)
unnamed: U3.7 (Q3), U38.5 (A3), U43.5 (A3)
unnamed: U3.12 (TCU_bar), U37.5 (CPU)
unnamed: U3.13 (TCD_bar), U37.4 (CPD)
unnamed: U37.2 (Q1), U38.7 (A5), U43.7 (A5)
unnamed: U37.3 (Q0), U38.6 (A4), U43.6 (A4)
unnamed: U37.6 (Q2), U38.8 (A6), U43.8 (A6)
unnamed: U37.7 (Q3), U38.9 (A7), U43.9 (A7)
unnamed: U37.12 (TCU_bar), U39.5 (CPU)
unnamed: U37.13 (TCD_bar), U39.4 (CPD)
unnamed: U39.2 (Q1), U41.3 (A1), U44.3 (A1)
unnamed: U39.3 (Q0), U41.2 (A0), U44.2 (A0)
unnamed: U39.6 (Q2), U41.4 (A2), U44.4 (A2)
unnamed: U39.7 (Q3), U41.5 (A3), U44.5 (A3)
unnamed: U39.12 (TCU_bar), U40.5 (CPU)
unnamed: U39.13 (TCD_bar), U40.4 (CPD)
unnamed: U40.2 (Q1), U41.7 (A5), U44.7 (A5)
unnamed: U40.3 (Q0), U41.6 (A4), U44.6 (A4)
unnamed: U40.6 (Q2), U41.8 (A6), U44.8 (A6)
unnamed: U40.7 (Q3), U41.9 (A7), U44.9 (A7)
unnamed: U45.2 (Q1), U47.3 (A1), U54.3 (A1)
unnamed: U45.3 (Q0), U47.2 (A0), U54.2 (A0)
unnamed: U45.6 (Q2), U47.4 (A2), U54.4 (A2)
unnamed: U45.7 (Q3), U47.5 (A3), U54.5 (A3)
unnamed: U45.12 (TCU_bar), U46.5 (CPU)
unnamed: U45.13 (TCD_bar), U46.4 (CPD)
unnamed: U46.2 (Q1), U47.7 (A5), U54.7 (A5)
unnamed: U46.3 (Q0), U47.6 (A4), U54.6 (A4)
unnamed: U46.6 (Q2), U47.8 (A6), U54.8 (A6)
unnamed: U46.7 (Q3), U47.9 (A7), U54.9 (A7)
unnamed: U46.12 (TCU_bar), U49.5 (CPU)
unnamed: U46.13 (TCD_bar), U49.4 (CPD)
unnamed: U49.2 (Q1), U53.3 (A1), U55.3 (A1)
unnamed: U49.3 (Q0), U53.2 (A0), U55.2 (A0)
unnamed: U49.6 (Q2), U53.4 (A2), U55.4 (A2)
unnamed: U49.7 (Q3), U53.5 (A3), U55.5 (A3)
unnamed: U49.12 (TCU_bar), U51.5 (CPU)
unnamed: U49.13 (TCD_bar), U51.4 (CPD)
unnamed: U50.12 (TCU_bar), U56.5 (CPU)
unnamed: U50.13 (TCD_bar), U56.4 (CPD)
unnamed: U51.2 (Q1), U53.7 (A5), U55.7 (A5)
unnamed: U51.3 (Q0), U53.6 (A4), U55.6 (A4)
unnamed: U51.6 (Q2), U53.8 (A6), U55.8 (A6)
unnamed: U51.7 (Q3), U53.9 (A7), U55.9 (A7)
unnamed: U56.2 (Q1), U58.3 (A1), U60.3 (A1)
unnamed: U56.3 (Q0), U58.2 (A0), U60.2 (A0)
unnamed: U56.6 (Q2), U58.4 (A2), U60.4 (A2)
unnamed: U56.7 (Q3), U58.5 (A3), U60.5 (A3)
unnamed: U56.12 (TCU_bar), U57.5 (CPU)
unnamed: U56.13 (TCD_bar), U57.4 (CPD)
unnamed: U57.2 (Q1), U58.7 (A5), U60.7 (A5)
unnamed: U57.3 (Q0), U58.6 (A4), U60.6 (A4)
unnamed: U57.6 (Q2), U58.8 (A6), U60.8 (A6)
unnamed: U57.7 (Q3), U58.9 (A7), U60.9 (A7)
unnamed: U61.2 (B1), U65.9 (S1)
unnamed: U61.3 (Y1), U69.2 (A0)
unnamed: U65.2 (S3), U69.4 (A2)
unnamed: U65.6 (S2), U69.3 (A1)
unnamed: U65.14 (C4), U66.13 (C0)
unnamed: U65.15 (S4), U69.5 (A3)
unnamed: U66.2 (S3), U69.8 (A6)
unnamed: U66.6 (S2), U69.7 (A5)
unnamed: U66.9 (S1), U69.6 (A4)
unnamed: U66.14 (C4), U67.13 (C0)
unnamed: U66.15 (S4), U69.9 (A7)
unnamed: U67.2 (S3), U70.4 (A2)
unnamed: U67.6 (S2), U70.3 (A1)
unnamed: U67.9 (S1), U70.2 (A0)
unnamed: U67.14 (C4), U68.13 (C0)
unnamed: U67.15 (S4), U70.5 (A3)
unnamed: U68.2 (S3), U70.8 (A6)
unnamed: U68.6 (S2), U70.7 (A5)
unnamed: U68.9 (S1), U70.6 (A4)
unnamed: U68.15 (S4), U70.9 (A7)
OFFi: CONN_CTL_M1.1, U62.11 (CLK); also elsewhere on the board
RESET_bar: CONN_CTL_pA1.8, CONN_CTL_pB1.8, U45.14 (MR), U46.14 (MR), U48.14 (MR), U49.14 (MR), U50.14 (MR), U51.14 (MR), U56.14 (MR), U57.14 (MR); also elsewhere on the board
SAVE_FAULT: IR_BUF3.11 (CLK); also elsewhere on the board
SELhigh: CONN_CTL_M1.2, U61.1 (A1); also elsewhere on the board
SHi: CONN_CTL_S1.6, U39.11 (PL_bar), U40.11 (PL_bar); also elsewhere on the board
SHo: CONN_CTL_S1.3, U41.1 (OE1_bar); also elsewhere on the board
SLi: CONN_CTL_S1.5, U3.11 (PL_bar), U37.11 (PL_bar); also elsewhere on the board
SLmm: CONN_CTL_S1.1, U3.4 (CPD); also elsewhere on the board
SLo: CONN_CTL_S1.4, U38.1 (OE1_bar); also elsewhere on the board
SLpp: CONN_CTL_S1.2, U3.5 (CPU); also elsewhere on the board
Sa: CONN_CTL_S1.8, U43.1 (OE1_bar), U44.1 (OE1_bar); also elsewhere on the board
Srst: CONN_CTL_S1.7, U3.14 (MR), U37.14 (MR), U39.14 (MR), U40.14 (MR); also elsewhere on the board
pACa: CONN_CTL_pA1.7, U59.1 (OE1_bar), U60.1 (OE1_bar); also elsewhere on the board
pACpp: CONN_CTL_pA1.2, U48.5 (CPU); also elsewhere on the board
pAHi: CONN_CTL_pA1.6, U56.11 (PL_bar), U57.11 (PL_bar); also elsewhere on the board
pAHo: CONN_CTL_pA1.3, U58.1 (OE1_bar); also elsewhere on the board
pALi: CONN_CTL_pA1.5, U48.11 (PL_bar), U50.11 (PL_bar); also elsewhere on the board
pALo: CONN_CTL_pA1.4, U52.1 (OE1_bar); also elsewhere on the board
pAdbg0: U48.3 (Q0), U52.2 (A0), U59.2 (A0)
pAdbg1: U48.2 (Q1), U52.3 (A1), U59.3 (A1)
pAdbg2: U48.6 (Q2), U52.4 (A2), U59.4 (A2)
pAdbg3: U48.7 (Q3), U52.5 (A3), U59.5 (A3)
pAdbg4: U50.3 (Q0), U52.6 (A4), U59.6 (A4)
pAdbg5: U50.2 (Q1), U52.7 (A5), U59.7 (A5)
pAdbg6: U50.6 (Q2), U52.8 (A6), U59.8 (A6)
pAdbg7: U50.7 (Q3), U52.9 (A7), U59.9 (A7)
pAdbg_TCD_bar: U48.13 (TCD_bar), U50.4 (CPD)
pAdbg_TUD_bar: U48.12 (TCU_bar), U50.5 (CPU)
pBCa: CONN_CTL_pB1.7, U54.1 (OE1_bar), U55.1 (OE1_bar); also elsewhere on the board
pBCpp: CONN_CTL_pB1.2, U45.5 (CPU); also elsewhere on the board
pBHi: CONN_CTL_pB1.6, U49.11 (PL_bar), U51.11 (PL_bar); also elsewhere on the board
pBHo: CONN_CTL_pB1.3, U53.1 (OE1_bar); also elsewhere on the board
pBLi: CONN_CTL_pB1.5, U45.11 (PL_bar), U46.11 (PL_bar); also elsewhere on the board
pBLo: CONN_CTL_pB1.4, U47.1 (OE1_bar); also elsewhere on the board
