romalik/cpu5/schematics/cpu5/cpu5.kicad_pcb

## KiCad design schematics/cpu5/cpu5.kicad_pcb (continued)

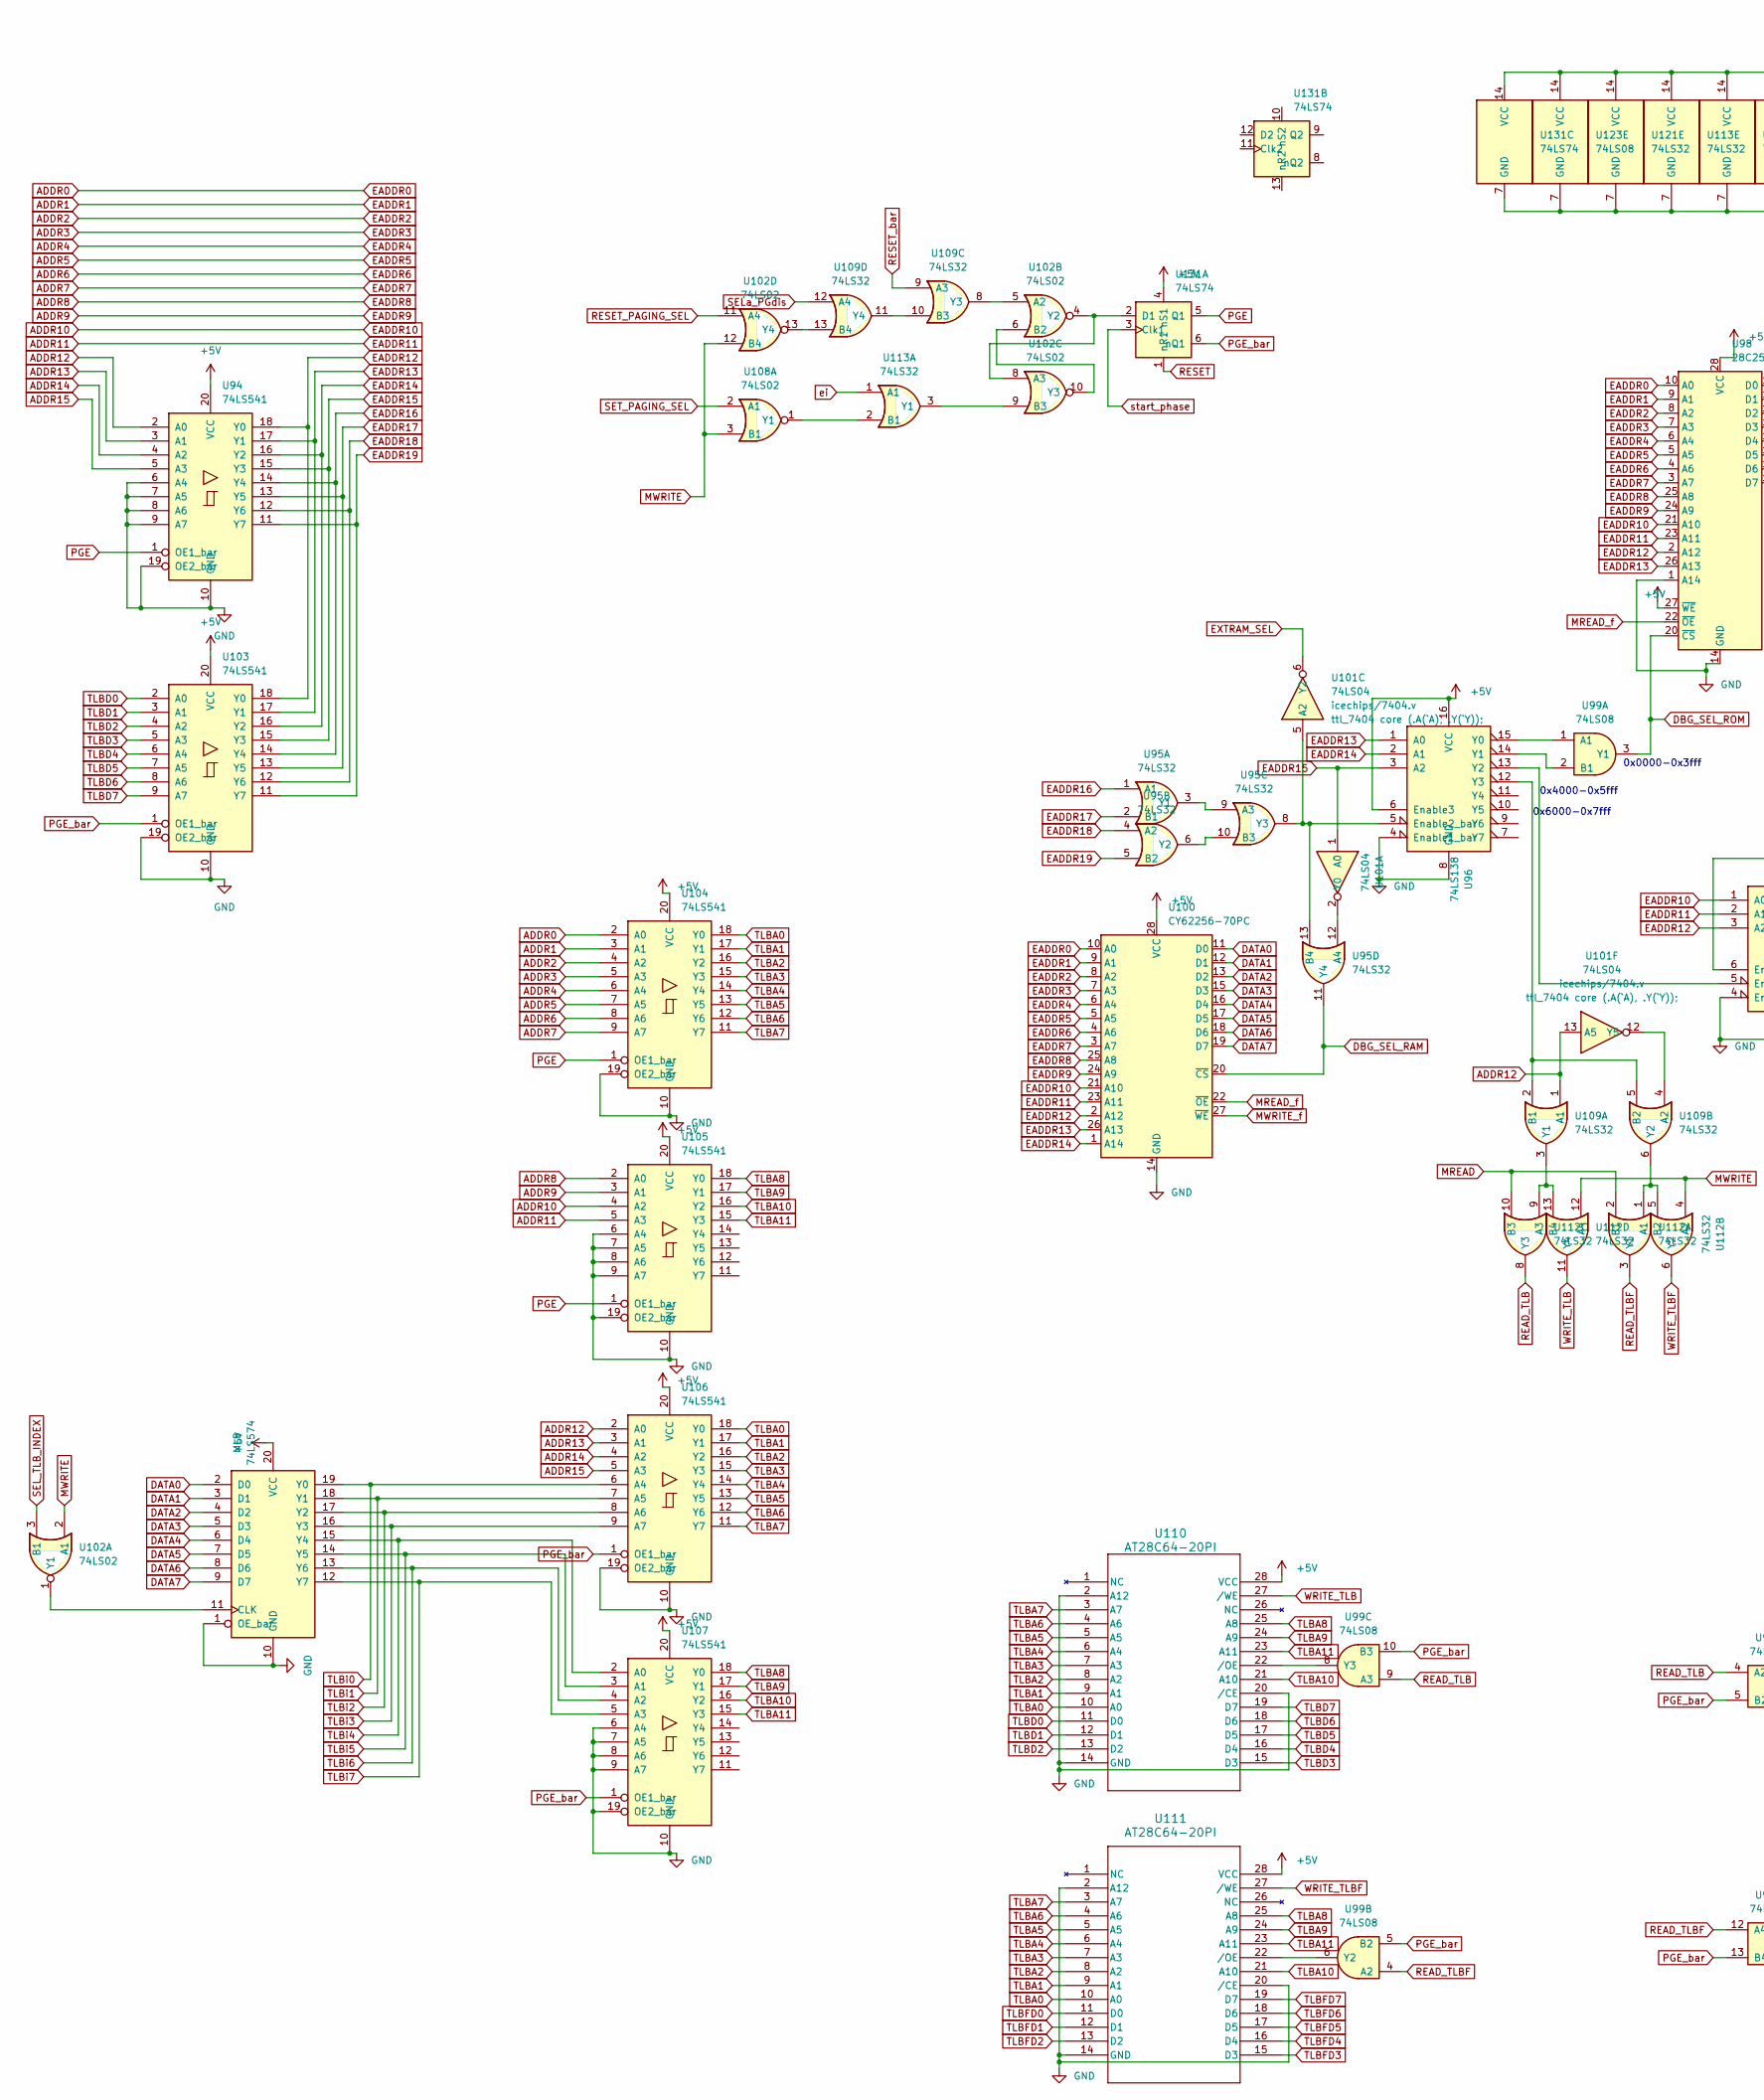
[picture p13: schematic memory.kicad_sch, part in row 1, column 1]

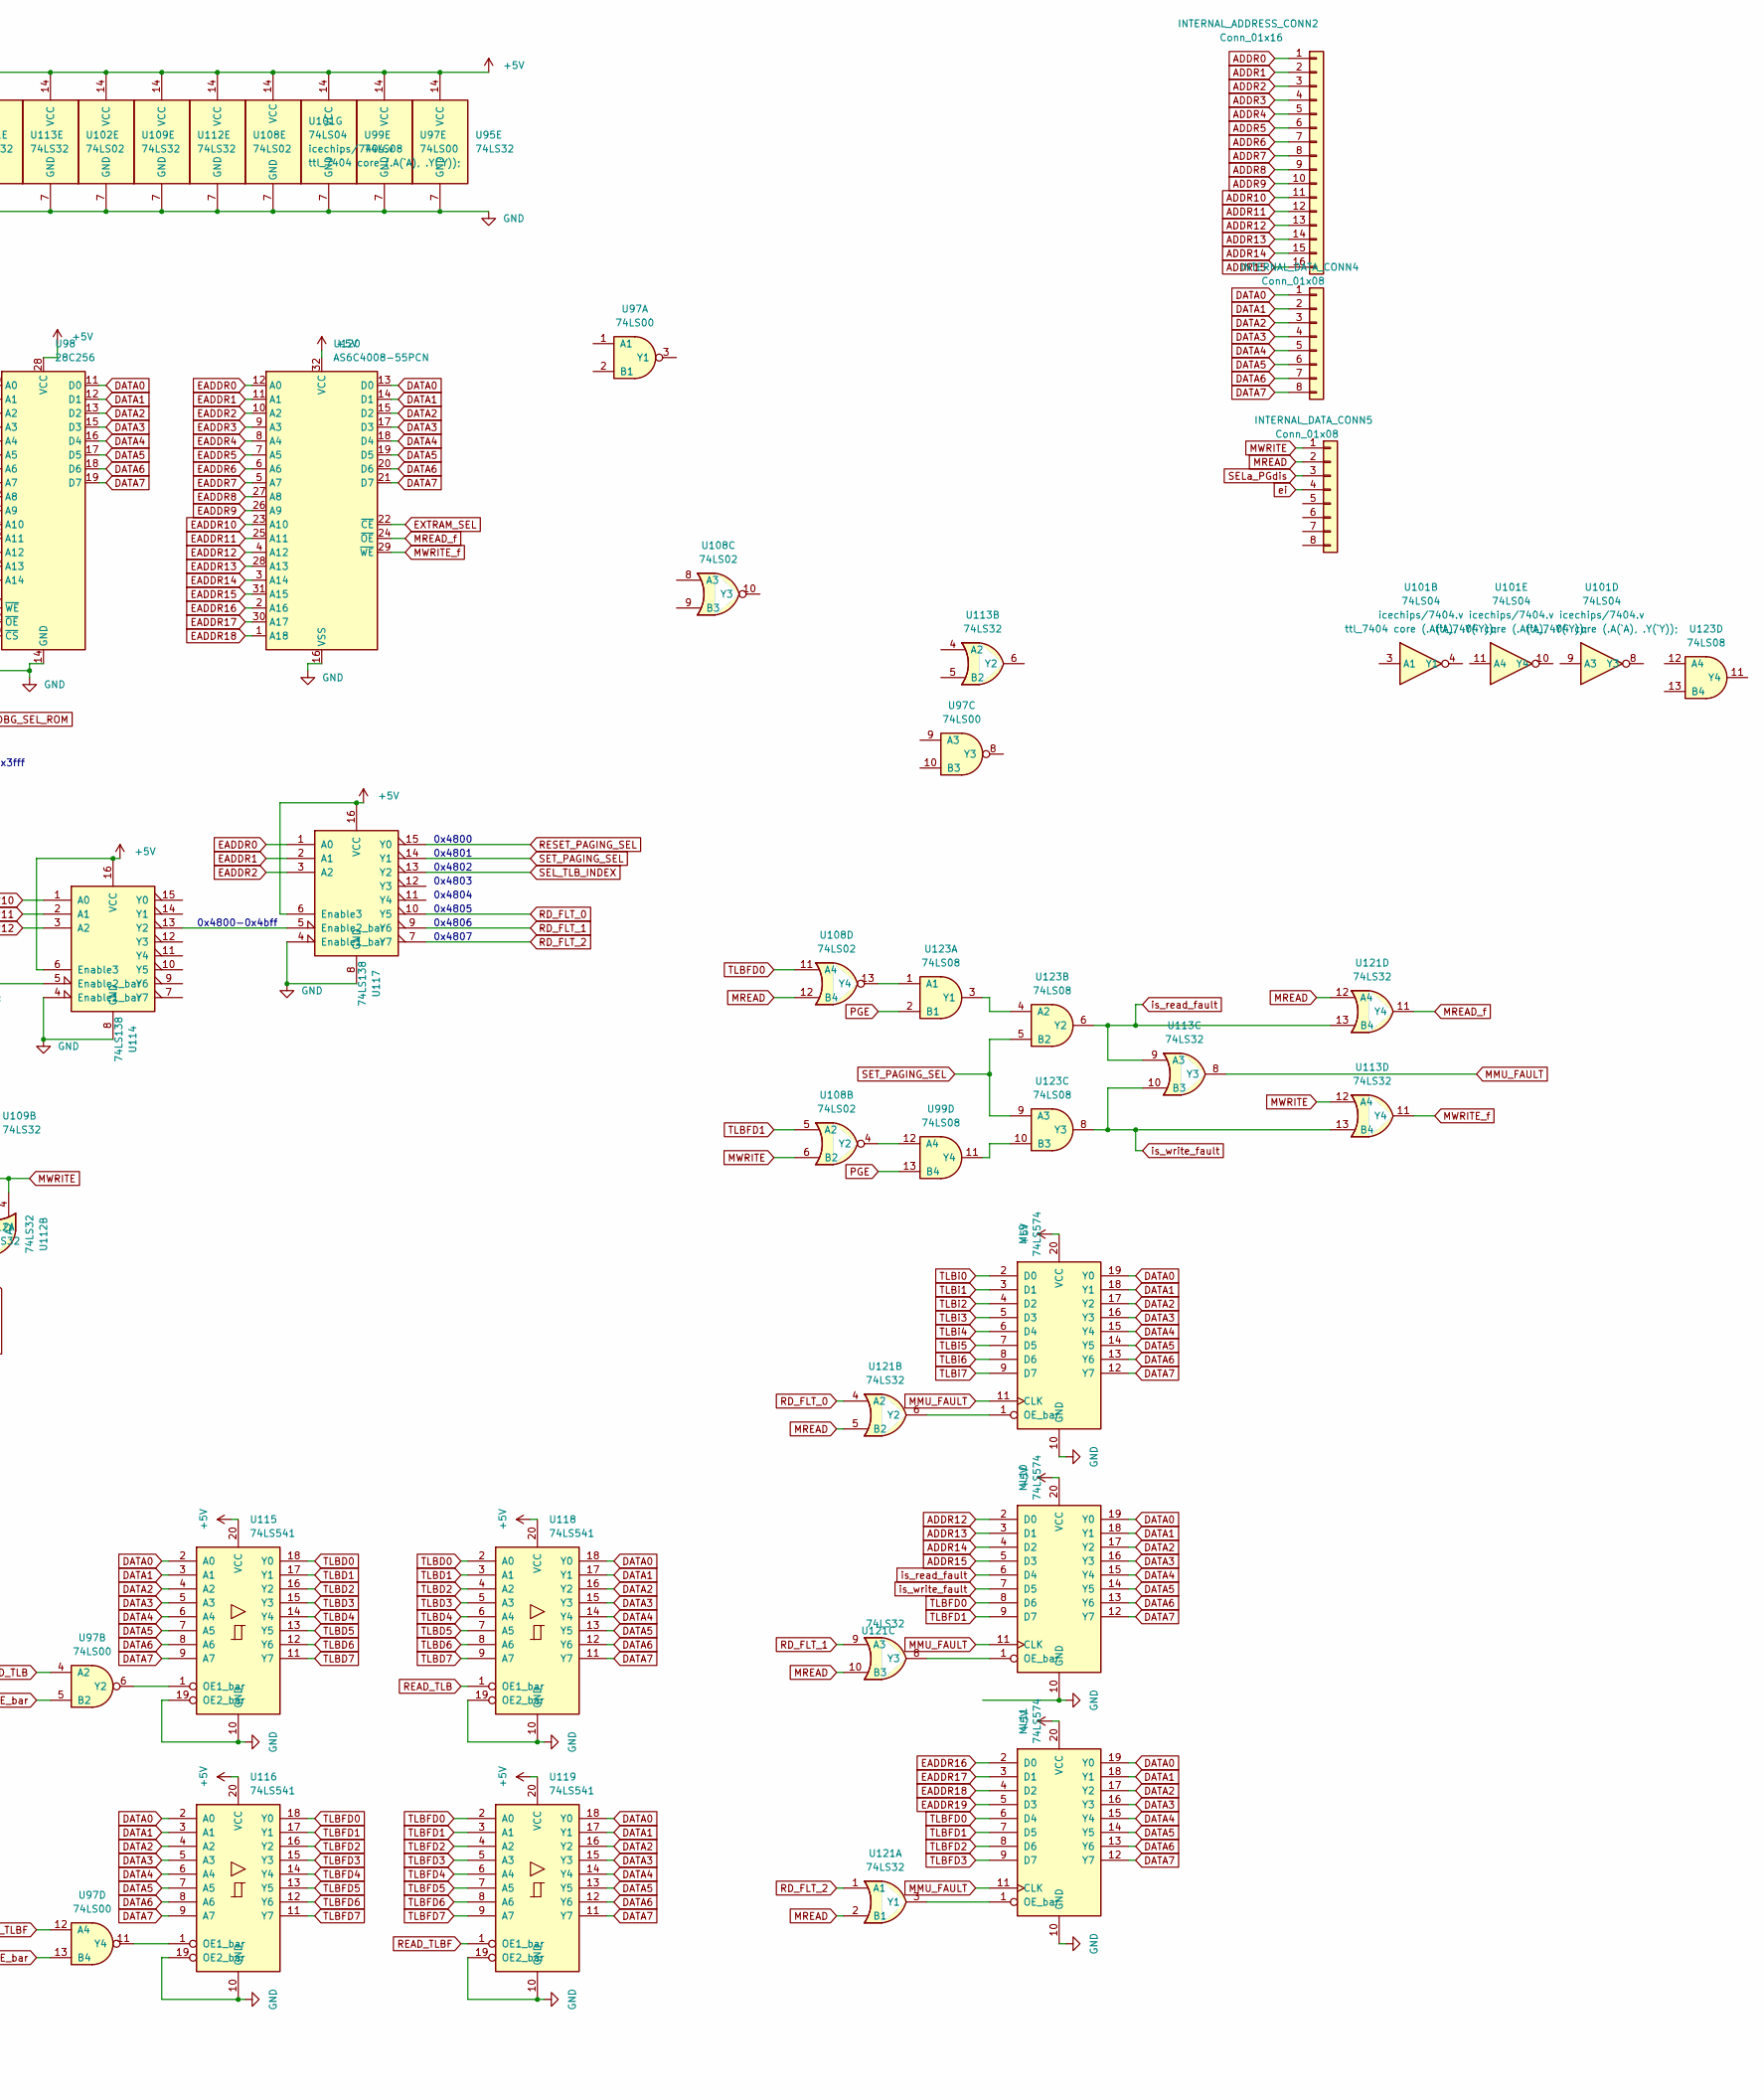
[picture p14: schematic memory.kicad_sch, part in row 1, column 2]

Parts:
INTERNAL_ADDRESS_CONN2: Conn_01x16; PinHeader_1x16_P2.54mm_Vertical
INTERNAL_DATA_CONN4, INTERNAL_DATA_CONN5: Conn_01x08; PinHeader_1x08_P2.54mm_Vertical
ML8, ML9, ML10, ML11: 74LS574; DIP-20_W7.62mm
U94, U103, U104, U105, U106, U107, U115, U116, U118, U119: 74LS541; DIP-20_W7.62mm
U95, U109, U112, U113, U121: 74LS32; DIP-14_W7.62mm
U96, U114, U117: 74LS138; DIP-16_W7.62mm
U97: 74LS00; DIP-14_W7.62mm
U98: 28C256; DIP-28_W15.24mm
U99, U123: 74LS08; DIP-14_W7.62mm
U100: CY62256-70PC; DIP-28_W15.24mm
U101: 74LS04; DIP-14_W7.62mm
U102, U108: 74LS02; DIP-14_W7.62mm
U110, U111: AT28C64-20PI; DIP-28_W7.62mm
U120: AS6C4008-55PCN; DIP-32_W15.24mm
U131: 74LS74; DIP-14_W7.62mm

Connections:
+5V: ML8.20 (VCC), ML9.20 (VCC), ML10.20 (VCC), ML11.20 (VCC), U94.20 (VCC), U95.14 (VCC), U96.6 (Enable3), U96.16 (VCC), U97.14 (VCC), U98.27 (~WE), U98.28 (VCC), U99.14 (VCC), U100.28 (VCC), U101.14 (VCC), U102.14 (VCC), U103.20 (VCC), U104.20 (VCC), U105.20 (VCC), U106.20 (VCC), U107.20 (VCC), U108.14 (VCC), U109.14 (VCC), U110.28 (VCC), U111.28 (VCC), U112.14 (VCC), U113.14 (VCC), U114.6 (Enable3), U114.16 (VCC), U115.20 (VCC), U116.20 (VCC), U117.6 (Enable3), U117.16 (VCC), U118.20 (VCC), U119.20 (VCC), U120.32 (VCC), U121.14 (VCC), U123.14 (VCC), U131.4 (nS1), U131.14 (VCC); also elsewhere on the board
ADDR0: INTERNAL_ADDRESS_CONN2.1, U98.10 (A0), U100.10 (A0), U104.2 (A0), U117.1 (A0), U120.12 (A0); also elsewhere on the board
ADDR1: INTERNAL_ADDRESS_CONN2.2, U98.9 (A1), U100.9 (A1), U104.3 (A1), U117.2 (A1), U120.11 (A1); also elsewhere on the board
ADDR2: INTERNAL_ADDRESS_CONN2.3, U98.8 (A2), U100.8 (A2), U104.4 (A2), U117.3 (A2), U120.10 (A2); also elsewhere on the board
ADDR3: INTERNAL_ADDRESS_CONN2.4, U98.7 (A3), U100.7 (A3), U104.5 (A3), U120.9 (A3); also elsewhere on the board
ADDR4: INTERNAL_ADDRESS_CONN2.5, U98.6 (A4), U100.6 (A4), U104.6 (A4), U120.8 (A4); also elsewhere on the board
ADDR5: INTERNAL_ADDRESS_CONN2.6, U98.5 (A5), U100.5 (A5), U104.7 (A5), U120.7 (A5); also elsewhere on the board
ADDR6: INTERNAL_ADDRESS_CONN2.7, U98.4 (A6), U100.4 (A6), U104.8 (A6), U120.6 (A6); also elsewhere on the board
ADDR7: INTERNAL_ADDRESS_CONN2.8, U98.3 (A7), U100.3 (A7), U104.9 (A7), U120.5 (A7); also elsewhere on the board
ADDR8: INTERNAL_ADDRESS_CONN2.9, U98.25 (A8), U100.25 (A8), U105.2 (A0), U120.27 (A8); also elsewhere on the board
ADDR9: INTERNAL_ADDRESS_CONN2.10, U98.24 (A9), U100.24 (A9), U105.3 (A1), U120.26 (A9); also elsewhere on the board
ADDR10: INTERNAL_ADDRESS_CONN2.11, U98.21 (A10), U100.21 (A10), U105.4 (A2), U114.1 (A0), U120.23 (A10); also elsewhere on the board
ADDR11: INTERNAL_ADDRESS_CONN2.12, U98.23 (A11), U100.23 (A11), U105.5 (A3), U114.2 (A1), U120.25 (A11); also elsewhere on the board
ADDR12: INTERNAL_ADDRESS_CONN2.13, ML10.2 (D0), U94.2 (A0), U101.13 (A5), U106.2 (A0), U109.1 (A1); also elsewhere on the board
ADDR13: INTERNAL_ADDRESS_CONN2.14, ML10.3 (D1), U94.3 (A1), U106.3 (A1); also elsewhere on the board
ADDR14: INTERNAL_ADDRESS_CONN2.15, ML10.4 (D2), U94.4 (A2), U106.4 (A2); also elsewhere on the board
ADDR15: INTERNAL_ADDRESS_CONN2.16, ML10.5 (D3), U94.5 (A3), U106.5 (A3); also elsewhere on the board
DATA0: INTERNAL_DATA_CONN4.1, ML8.2 (D0), ML9.19 (Y0), ML10.19 (Y0), ML11.19 (Y0), U98.11 (D0), U100.11 (D0), U115.2 (A0), U116.2 (A0), U118.18 (Y0), U119.18 (Y0), U120.13 (D0); also elsewhere on the board
DATA1: INTERNAL_DATA_CONN4.2, ML8.3 (D1), ML9.18 (Y1), ML10.18 (Y1), ML11.18 (Y1), U98.12 (D1), U100.12 (D1), U115.3 (A1), U116.3 (A1), U118.17 (Y1), U119.17 (Y1), U120.14 (D1); also elsewhere on the board
DATA2: INTERNAL_DATA_CONN4.3, ML8.4 (D2), ML9.17 (Y2), ML10.17 (Y2), ML11.17 (Y2), U98.13 (D2), U100.13 (D2), U115.4 (A2), U116.4 (A2), U118.16 (Y2), U119.16 (Y2), U120.15 (D2); also elsewhere on the board
DATA3: INTERNAL_DATA_CONN4.4, ML8.5 (D3), ML9.16 (Y3), ML10.16 (Y3), ML11.16 (Y3), U98.15 (D3), U100.15 (D3), U115.5 (A3), U116.5 (A3), U118.15 (Y3), U119.15 (Y3), U120.17 (D3); also elsewhere on the board
DATA4: INTERNAL_DATA_CONN4.5, ML8.6 (D4), ML9.15 (Y4), ML10.15 (Y4), ML11.15 (Y4), U98.16 (D4), U100.16 (D4), U115.6 (A4), U116.6 (A4), U118.14 (Y4), U119.14 (Y4), U120.18 (D4); also elsewhere on the board
DATA5: INTERNAL_DATA_CONN4.6, ML8.7 (D5), ML9.14 (Y5), ML10.14 (Y5), ML11.14 (Y5), U98.17 (D5), U100.17 (D5), U115.7 (A5), U116.7 (A5), U118.13 (Y5), U119.13 (Y5), U120.19 (D5); also elsewhere on the board
DATA6: INTERNAL_DATA_CONN4.7, ML8.8 (D6), ML9.13 (Y6), ML10.13 (Y6), ML11.13 (Y6), U98.18 (D6), U100.18 (D6), U115.8 (A6), U116.8 (A6), U118.12 (Y6), U119.12 (Y6), U120.20 (D6); also elsewhere on the board
DATA7: INTERNAL_DATA_CONN4.8, ML8.9 (D7), ML9.12 (Y7), ML10.12 (Y7), ML11.12 (Y7), U98.19 (D7), U100.19 (D7), U115.9 (A7), U116.9 (A7), U118.11 (Y7), U119.11 (Y7), U120.21 (D7); also elsewhere on the board
DBG_SEL_RAM: U95.11 (Y4), U100.20 (~CS)
DBG_SEL_ROM: U98.20 (~CS), U99.3 (Y1)
EADDR12: U94.18 (Y0), U98.2 (A12), U100.2 (A12), U103.18 (Y0), U114.3 (A2), U120.4 (A12)
EADDR13: U94.17 (Y1), U96.1 (A0), U98.26 (A13), U100.26 (A13), U103.17 (Y1), U120.28 (A13)
EADDR14: U94.16 (Y2), U96.2 (A1), U100.1 (A14), U103.16 (Y2), U120.3 (A14)
EADDR15: U94.15 (Y3), U96.3 (A2), U101.1 (A0), U103.15 (Y3), U120.31 (A15)
EADDR16: ML11.2 (D0), U94.14 (Y4), U95.1 (A1), U103.14 (Y4), U120.2 (A16)
EADDR17: ML11.3 (D1), U94.13 (Y5), U95.2 (B1), U103.13 (Y5), U120.30 (A17)
EADDR18: ML11.4 (D2), U94.12 (Y6), U95.4 (A2), U103.12 (Y6), U120.1 (A18)
EADDR19: ML11.5 (D3), U94.11 (Y7), U95.5 (B2), U103.11 (Y7)
EXTRAM_SEL: U101.6 (Y2), U120.22 (~CE)
GND: ML8.1 (OE_bar), ML8.10 (GND), ML9.10 (GND), ML10.10 (GND), ML11.10 (GND), U94.6 (A4), U94.7 (A5), U94.8 (A6), U94.9 (A7), U94.10 (GND), U94.19 (OE2_bar), U95.7 (GND), U96.4 (Enable1_bar), U96.8 (GND), U97.7 (GND), U98.1 (A14), U98.14 (GND), U99.7 (GND), U100.14 (GND), U101.7 (GND), U102.7 (GND), U103.10 (GND), U103.19 (OE2_bar), U104.10 (GND), U104.19 (OE2_bar), U105.6 (A4), U105.7 (A5), U105.8 (A6), U105.9 (A7), U105.10 (GND), U105.19 (OE2_bar), U106.10 (GND), U106.19 (OE2_bar), U107.6 (A4), U107.7 (A5), U107.8 (A6), U107.9 (A7), U107.10 (GND), U107.19 (OE2_bar), U108.7 (GND), U109.7 (GND), U110.2 (A12), U110.14 (GND), U110.20 (/CE), U111.2 (A12), U111.14 (GND), U111.20 (/CE), U112.7 (GND), U113.7 (GND), U114.4 (Enable1_bar), U114.8 (GND), U115.10 (GND), U115.19 (OE2_bar), U116.10 (GND), U116.19 (OE2_bar), U117.4 (Enable1_bar), U117.8 (GND), U118.10 (GND), U118.19 (OE2_bar), U119.10 (GND), U119.19 (OE2_bar), U120.16 (VSS), U121.7 (GND), U123.7 (GND), U131.7 (GND); also elsewhere on the board
MMU_FAULT: ML9.11 (CLK), ML10.11 (CLK), ML11.11 (CLK), U113.8 (Y3); also elsewhere on the board
MREAD: INTERNAL_DATA_CONN5.2, U108.12 (B4), U112.2 (B1), U112.10 (B3), U121.2 (B1), U121.5 (B2), U121.10 (B3), U121.12 (A4); also elsewhere on the board
MREAD_f: U98.22 (~OE), U100.22 (~OE), U120.24 (~OE), U121.11 (Y4)
MWRITE: INTERNAL_DATA_CONN5.1, U102.2 (A1), U102.12 (B4), U108.3 (B1), U108.6 (B2), U112.4 (A2), U112.12 (A4), U113.12 (A4); also elsewhere on the board
MWRITE_f: U100.27 (~WE), U113.11 (Y4), U120.29 (~WE)
unnamed: ML8.11 (CLK), U102.1 (Y1)
unnamed: ML9.1 (OE_bar), U121.6 (Y2)
unnamed: ML10.1 (OE_bar), U121.8 (Y3)
unnamed: ML11.1 (OE_bar), U121.3 (Y1)
unnamed: U95.3 (Y1), U95.9 (A3)
unnamed: U95.6 (Y2), U95.10 (B3)
unnamed: U96.14 (Y1), U99.2 (B1)
unnamed: U96.15 (Y0), U99.1 (A1)
unnamed: U95.12 (A4), U101.2 (Y0)
unnamed: U95.8 (Y3), U95.13 (B4), U96.5 (Enable2_bar), U101.5 (A2)
unnamed: U101.12 (Y5), U109.4 (A2)
unnamed: U102.4 (Y2), U102.8 (A3), U131.2 (D1)
unnamed: U102.5 (A2), U109.8 (Y3)
unnamed: U102.9 (B3), U113.3 (Y1)
unnamed: U102.6 (B2), U102.10 (Y3)
unnamed: U102.13 (Y4), U109.13 (B4)
unnamed: U108.1 (Y1), U113.2 (B1)
unnamed: U99.12 (A4), U108.4 (Y2)
unnamed: U108.13 (Y4), U123.1 (A1)
unnamed: U96.12 (Y3), U109.2 (B1), U109.5 (B2)
unnamed: U109.3 (Y1), U112.9 (A3), U112.13 (B4)
unnamed: U109.6 (Y2), U112.1 (A1), U112.5 (B2)
unnamed: U109.10 (B3), U109.11 (Y4)
unnamed: U99.8 (Y3), U110.22 (/OE)
unnamed: U99.6 (Y2), U111.22 (/OE)
unnamed: U96.13 (Y2), U114.5 (Enable2_bar)
unnamed: U114.13 (Y2), U117.5 (Enable2_bar)
unnamed: U97.6 (Y2), U115.1 (OE1_bar)
unnamed: U97.11 (Y4), U116.1 (OE1_bar)
unnamed: U123.3 (Y1), U123.4 (A2)
unnamed: U99.11 (Y4), U123.10 (B3)
PGE: U94.1 (OE1_bar), U99.13 (B4), U104.1 (OE1_bar), U105.1 (OE1_bar), U123.2 (B1), U131.5 (Q1); also elsewhere on the board
PGE_bar: U97.5 (B2), U97.13 (B4), U99.5 (B2), U99.10 (B3), U103.1 (OE1_bar), U106.1 (OE1_bar), U107.1 (OE1_bar), U131.6 (nQ1)
RD_FLT_0: U117.10 (Y5), U121.4 (A2)
RD_FLT_1: U117.9 (Y6), U121.9 (A3)
RD_FLT_2: U117.7 (Y7), U121.1 (A1)
READ_TLB: U97.4 (A2), U99.9 (A3), U112.8 (Y3), U118.1 (OE1_bar)
READ_TLBF: U97.12 (A4), U99.4 (A2), U112.3 (Y1), U119.1 (OE1_bar)
RESET: U131.1 (nR1); also elsewhere on the board
RESET_PAGING_SEL: U102.11 (A4), U117.15 (Y0)
RESET_bar: U109.9 (A3); also elsewhere on the board
SEL_TLB_INDEX: U102.3 (B1), U117.13 (Y2)
SELa_PGdis: INTERNAL_DATA_CONN5.3, U109.12 (A4); also elsewhere on the board
SET_PAGING_SEL: U108.2 (A1), U117.14 (Y1), U123.5 (B2), U123.9 (A3)
TLBA0: U104.18 (Y0), U106.18 (Y0), U110.10 (A0), U111.10 (A0)
TLBA1: U104.17 (Y1), U106.17 (Y1), U110.9 (A1), U111.9 (A1)
TLBA2: U104.16 (Y2), U106.16 (Y2), U110.8 (A2), U111.8 (A2)
TLBA3: U104.15 (Y3), U106.15 (Y3), U110.7 (A3), U111.7 (A3)
TLBA4: U104.14 (Y4), U106.14 (Y4), U110.6 (A4), U111.6 (A4)
TLBA5: U104.13 (Y5), U106.13 (Y5), U110.5 (A5), U111.5 (A5)
TLBA6: U104.12 (Y6), U106.12 (Y6), U110.4 (A6), U111.4 (A6)
TLBA7: U104.11 (Y7), U106.11 (Y7), U110.3 (A7), U111.3 (A7)
TLBA8: U105.18 (Y0), U107.18 (Y0), U110.25 (A8), U111.25 (A8)
TLBA9: U105.17 (Y1), U107.17 (Y1), U110.24 (A9), U111.24 (A9)
TLBA10: U105.16 (Y2), U107.16 (Y2), U110.21 (A10), U111.21 (A10)
TLBA11: U105.15 (Y3), U107.15 (Y3), U110.23 (A11), U111.23 (A11)
TLBD0: U103.2 (A0), U110.11 (D0), U115.18 (Y0), U118.2 (A0)
TLBD1: U103.3 (A1), U110.12 (D1), U115.17 (Y1), U118.3 (A1)
TLBD2: U103.4 (A2), U110.13 (D2), U115.16 (Y2), U118.4 (A2)
TLBD3: U103.5 (A3), U110.15 (D3), U115.15 (Y3), U118.5 (A3)
TLBD4: U103.6 (A4), U110.16 (D4), U115.14 (Y4), U118.6 (A4)
TLBD5: U103.7 (A5), U110.17 (D5), U115.13 (Y5), U118.7 (A5)
TLBD6: U103.8 (A6), U110.18 (D6), U115.12 (Y6), U118.8 (A6)
TLBD7: U103.9 (A7), U110.19 (D7), U115.11 (Y7), U118.9 (A7)
TLBFD0: ML10.8 (D6), ML11.6 (D4), U108.11 (A4), U111.11 (D0), U116.18 (Y0), U119.2 (A0)
TLBFD1: ML10.9 (D7), ML11.7 (D5), U108.5 (A2), U111.12 (D1), U116.17 (Y1), U119.3 (A1)
TLBFD2: ML11.8 (D6), U111.13 (D2), U116.16 (Y2), U119.4 (A2)
TLBFD3: ML11.9 (D7), U111.15 (D3), U116.15 (Y3), U119.5 (A3)
TLBFD4: U111.16 (D4), U116.14 (Y4), U119.6 (A4)
TLBFD5: U111.17 (D5), U116.13 (Y5), U119.7 (A5)
TLBFD6: U111.18 (D6), U116.12 (Y6), U119.8 (A6)
TLBFD7: U111.19 (D7), U116.11 (Y7), U119.9 (A7)
TLBi0: ML8.19 (Y0), ML9.2 (D0), U106.6 (A4)
TLBi1: ML8.18 (Y1), ML9.3 (D1), U106.7 (A5)
TLBi2: ML8.17 (Y2), ML9.4 (D2), U106.8 (A6)
TLBi3: ML8.16 (Y3), ML9.5 (D3), U106.9 (A7)
TLBi4: ML8.15 (Y4), ML9.6 (D4), U107.2 (A0)
TLBi5: ML8.14 (Y5), ML9.7 (D5), U107.3 (A1)
TLBi6: ML8.13 (Y6), ML9.8 (D6), U107.4 (A2)
TLBi7: ML8.12 (Y7), ML9.9 (D7), U107.5 (A3)
WRITE_TLB: U110.27 (/WE), U112.11 (Y4)
WRITE_TLBF: U111.27 (/WE), U112.6 (Y2)
ei: INTERNAL_DATA_CONN5.4, U113.1 (A1); also elsewhere on the board
is_read_fault: ML10.6 (D4), U113.9 (A3), U121.13 (B4), U123.6 (Y2)
is_write_fault: ML10.7 (D5), U113.10 (B3), U113.13 (B4), U123.8 (Y3)
start_phase: U131.3 (Clk1); also elsewhere on the board

Notes on the sheet:
0x4807
0x4000-0x5fff
0x0000-0x3fff
0x4806
0x4805
0x4801
0x4804
0x6000-0x7fff
0x4800-0x4bff
0x4800
0x4803
0x4802

Board: 2 copper layers, 187 parts (0 on the bottom side), 567 nets, no tracks yet.
