romalik/cpu5/compiler/ucpp/config.h

#define LOW_MEM
#define PRAGMA_TOKENIZE
#define PRAGMA_TOKEN_END	((unsigned char)'\n')
#define PRAGMA_DUMP
#define STD_INCLUDE_PATH	0
#ifdef __SMALLER_C__
#define NATIVE_SIGNED           long
#define NATIVE_UNSIGNED         unsigned long
#define NATIVE_UNSIGNED_BITS    32
#define NATIVE_SIGNED_MIN       (-0x7fffffffL - 1)
#define NATIVE_SIGNED_MAX       0x7fffffffL
#else
#define NATIVE_SIGNED           long long
#define NATIVE_UNSIGNED         unsigned long long
#define NATIVE_UNSIGNED_BITS    64
#define NATIVE_SIGNED_MIN       (-9223372036854775807LL - 1)
#define NATIVE_SIGNED_MAX       9223372036854775807LL
#endif
#define ARITHMETIC_CHECKS
#define STD_ASSERT 0
#define STD_MACROS 0
#define DEFAULT_CPP_FLAGS	(DISCARD_COMMENTS | WARN_STANDARD \
				| WARN_PRAGMA | FAIL_SHARP | MACRO_VAARG \
				| CPLUSPLUS_COMMENTS | LINE_NUM | TEXT_OUTPUT \
				| KEEP_OUTPUT | HANDLE_TRIGRAPHS \
				| HANDLE_ASSERTIONS)
#define DEFAULT_LEXER_FLAGS	(DISCARD_COMMENTS | WARN_STANDARD | FAIL_SHARP \
				| MACRO_VAARG | CPLUSPLUS_COMMENTS | LEXER \
				| HANDLE_TRIGRAPHS | HANDLE_ASSERTIONS)
#define MAX_CHAR_VAL	128
