romalik/cpu5/simulation/verilator/icechips/74112-tb.v

// Test: Dual J-K flip-flop with set and clear; negative-edge-triggered

// Note: Preset_bar is synchronous, not asynchronous as specified in datasheet for this device,
//       in order to meet requirements for FPGA circuit design (see IceChips Technical Notes)

module test;

`TBASSERT_METHOD(tbassert)

localparam BLOCKS = 3;

// DUT inputs
reg [BLOCKS-1:0] Preset_bar;
reg [BLOCKS-1:0] Clear_bar;
reg [BLOCKS-1:0] J;
reg [BLOCKS-1:0] K;
reg [BLOCKS-1:0] Clk;

// DUT outputs
wire [BLOCKS-1:0] Q;
wire [BLOCKS-1:0] Q_bar;

// DUT
ttl_74112 #(.BLOCKS(BLOCKS), .DELAY_RISE(5), .DELAY_FALL(3)) dut(
  .Preset_bar(Preset_bar),
  .Clear_bar(Clear_bar),
  .J(J),
  .K(K),
  .Clk(Clk),
  .Q(Q),
  .Q_bar(Q_bar)
);

initial
begin
  $dumpfile("74112-tb.vcd");
  $dumpvars;

  // the following set of tests are for: load

#65
  // initial state
  tbassert(Q === 3'bxxx, "Test 1");
  tbassert(Q_bar === 3'bxxx, "Test 1");
#0
  // load all zeroes, the clock input takes on a value
  Clk = 3'b000;
#7
  tbassert(Q === 3'bxxx, "Test 1");
  tbassert(Q_bar === 3'bxxx, "Test 1");
#0
  // load all zeroes, set up the data
  J = 3'b000;
  K = 3'b111;
#25
  tbassert(Q === 3'bxxx, "Test 1");
  tbassert(Q_bar === 3'bxxx, "Test 1");
#0
  // load all zeroes, wait for clock edge
  Clk = 3'b111;
#2
  tbassert(Q === 3'bxxx, "Test 1");
  tbassert(Q_bar === 3'bxxx, "Test 1");
#0
  // load all zeroes, not enough time for output to fall/rise
  Clk = 3'b000;
#2
  tbassert(Q === 3'bxxx, "Test 1");
  tbassert(Q_bar === 3'bxxx, "Test 1");
#5
  // load all zeroes -> output 0s
  tbassert(Q == 3'b000, "Test 1");
  tbassert(Q_bar == 3'b111, "Test 1");
#140
  // hold state
  Clk = 3'b111;
#175
  tbassert(Q == 3'b000, "Test 2");
  tbassert(Q_bar == 3'b111, "Test 2");
#0
  // load all ones, set up the data
  J = 3'b111;
  K = 3'b000;
#125
  tbassert(Q == 3'b000, "Test 3");
  tbassert(Q_bar == 3'b111, "Test 3");
#0
  // load all ones, not enough time for output to rise/fall
  Clk = 3'b000;
#2
  tbassert(Q == 3'b000, "Test 3");
  tbassert(Q_bar == 3'b111, "Test 3");
#5
  // load all ones -> output 1s
  tbassert(Q == 3'b111, "Test 3");
  tbassert(Q_bar == 3'b000, "Test 3");
#50
  // hold state
  Clk = 3'b111;
#125
  tbassert(Q == 3'b111, "Test 4");
  tbassert(Q_bar == 3'b000, "Test 4");
#0
  // hold state, the preset and clear inputs take on values
  Preset_bar = 3'b111;
  Clear_bar = 3'b111;
#50
  tbassert(Q == 3'b111, "Test 4");
  tbassert(Q_bar == 3'b000, "Test 4");
#0
  // load 010, set up the data
  J = 3'b010;
  K = 3'b101;
#15
  // load 010, apply clock edge in first block separately -> output 110
  Clk[0] = 1'b0;
#7
  tbassert(Q == 3'b110, "Test 5");
  tbassert(Q_bar == 3'b001, "Test 5");
#25
  // load 010, apply clock edge in second block separately -> output 110
  Clk[1] = 1'b0;
#7
  tbassert(Q == 3'b110, "Test 6");
  tbassert(Q_bar == 3'b001, "Test 6");
#25
  // load 010, apply clock edge in third block separately -> output 010
  Clk[2] = 1'b0;
#7
  tbassert(Q == 3'b010, "Test 7");
  tbassert(Q_bar == 3'b101, "Test 7");
#140
  // hold state, end clock pulse in second block separately
  Clk[1] = 1'b1;
#7
  tbassert(Q == 3'b010, "Test 8");
  tbassert(Q_bar == 3'b101, "Test 8");
#10
  // hold state, end clock pulse in first block separately
  Clk[0] = 1'b1;
#7
  tbassert(Q == 3'b010, "Test 8");
  tbassert(Q_bar == 3'b101, "Test 8");
#10
  // hold state, end clock pulse in third block separately
  Clk[2] = 1'b1;
#50
  tbassert(Q == 3'b010, "Test 8");
  tbassert(Q_bar == 3'b101, "Test 8");
#0

  // the following set of tests are for: toggle

  // toggle, set up the data
  J = 3'b111;
  K = 3'b111;
  // Clk = 3'b111;
#75
  tbassert(Q == 3'b010, "Test 9");
  tbassert(Q_bar == 3'b101, "Test 9");
#0
  // toggle -> output 101
  Clk = 3'b000;
#7
  tbassert(Q == 3'b101, "Test 9");
  tbassert(Q_bar == 3'b010, "Test 9");
#50
  // hold state
  Clk = 3'b111;
#50
  tbassert(Q == 3'b101, "Test 10");
  tbassert(Q_bar == 3'b010, "Test 10");
#0
  // J = 3'b111;
  // K = 3'b111;
#15
  tbassert(Q == 3'b101, "Test 11");
  tbassert(Q_bar == 3'b010, "Test 11");
#0
  // toggle -> output 010
  Clk = 3'b000;
#7
  tbassert(Q == 3'b010, "Test 11");
  tbassert(Q_bar == 3'b101, "Test 11");
#10
  // hold state
  Clk = 3'b111;
#75
  tbassert(Q == 3'b010, "Test 12");
  tbassert(Q_bar == 3'b101, "Test 12");
#0
  // J = 3'b111;
  // K = 3'b111;
#15
  // toggle, apply clock edge in third block separately -> output 110
  Clk[2] = 1'b0;
#7
  tbassert(Q == 3'b110, "Test 13");
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
  tbassert(Q_bar == 3'b011, "Test 58");
#0
  // toggle value in first block separately
  // J = 3'b011;
  // K = 3'b011;
#40
  Clk = 3'b110;
#15
  Clk = 3'b111;
#15
  tbassert(Q == 3'b101, "Test 59");
  tbassert(Q_bar == 3'b010, "Test 59");
#50
  $finish;
end

endmodule
