romalik/cpu5/simulation/verilator/icechips/74161-tb.v

// Test: 4-bit modulo 16 binary counter with parallel load, asynchronous clear

module test;

`TBASSERT_METHOD(tbassert)
`TBASSERT_2_METHOD(tbassert2)
`TBCLK_WAIT_TICK_METHOD(wait_tick)

localparam WIDTH = 3;

// DUT inputs
reg Clear_bar;
reg Load_bar;
reg ENT;
reg ENP;
reg [WIDTH-1:0] D;
reg Clk;

// DUT outputs
wire RCO;
wire [WIDTH-1:0] Q;

// DUT
ttl_74161 #(.WIDTH(WIDTH), .DELAY_RISE(5), .DELAY_FALL(3)) dut(
  .Clear_bar(Clear_bar),
  .Load_bar(Load_bar),
  .ENT(ENT),
  .ENP(ENP),
  .D(D),
  .Clk(Clk),
  .RCO(RCO),
  .Q(Q)
);

initial Clk = 1'b0;

always #50 Clk = ~Clk;

task parallel_load_and_tick(input [WIDTH-1:0] D_next);
  Load_bar = 1'b0;
  D = D_next;
  repeat (2) @(posedge Clk);
#7
  Load_bar = 1'b1;
endtask

initial
begin
  reg [WIDTH-1:0] D_next;
  reg [WIDTH-1:0] Q_expected;
  integer i;

  $dumpfile("74161-tb.vcd");
  $dumpvars;

  // the following set of tests are for: load

#225
  // steady state, enough time for clock pulse
  tbassert(Q === 3'bxxx, "Test 1");
  tbassert(RCO === 1'bx, "Test 1");
#0
  // load all zeroes, steady state before clock edge
  Load_bar = 1'b0;
  D = 3'b000;
#25
  tbassert(Q === 3'bxxx, "Test 1");
  tbassert(RCO === 1'bx, "Test 1");
#2
  // load all zeroes, at clock edge, not enough time for output to fall
  tbassert(Q === 3'bxxx, "Test 1");
  tbassert(RCO === 1'bx, "Test 1");
#2
  // load all zeroes -> outputs 0
  tbassert(Q == 3'b000, "Test 1");
  tbassert(RCO == 1'b0, "Test 1");
#140
  // steady state, enough time for clock pulse -> no change to outputs after load signal ends
  Load_bar = 1'b1;
#175
  tbassert(Q == 3'b000, "Test 2");
  tbassert(RCO == 1'b0, "Test 2");
#0
  // load all ones (special input ENT set) -> outputs 1s and 1
  Load_bar = 1'b0;
  ENT = 1'b1;
  D = 3'b111;
#125
  Load_bar = 1'b1;
#110
  tbassert(Q == 3'b111, "Test 3");
  tbassert(RCO == 1'b1, "Test 3");
#0
  ENT = 1'b0;
#0

  // repeat tests: the other control inputs take on values, but not clear mode, not count mode

  D_next = 3'b111;  // initial value to start the loop

  for (i = 1; i <= 6; i++)
  begin
    Q_expected = D_next;
    D_next = (Q_expected + 2) ^ 5;  // use a random value for next input

    case (i)
      1:
      begin
        ENT = 1'b0;
      end
      2:
      begin
        ENT = 1'b0;
        ENP = 1'b0;
      end
      3:
      begin
        ENT = 1'b1;
        ENP = 1'b0;
      end
      4:
      begin
        ENT = 1'b0;
        ENP = 1'b1;
      end
      5:
      begin
        Clear_bar = 1'b1;
        ENT = 1'b0;
        ENP = 1'b1;
      end
      6:
      begin
        Clear_bar = 1'b1;
        ENT = 1'b1;
        ENP = 1'b0;
      end
    endcase
#75
    tbassert2(Q == Q_expected, "Test", i, "4");
    tbassert2(RCO == 1'b0, "Test", i, "4");
#0
    // load next input -> outputs correspond to the input
    Load_bar = 1'b0;
    D = D_next;
#100
    tbassert2(Q == D_next, "Test", i, "4");
    tbassert2(RCO == 1'b0, "Test", i, "4");
#0
    // steady state, enough time for clock pulse -> no change to outputs after load signal ends
    Load_bar = 1'b1;
#105
    tbassert2(Q == D_next, "Test", i, "4");
    tbassert2(RCO == 1'b0, "Test", i, "4");

  end

  // end repeat tests

  tbassert2(Q == 3'b011, "Test", 6, "4");  // actual value at exit of the loop
#175

  // the following set of tests are for: clear

  // asynchronous clear from 011, not enough time for output to fall
  Clear_bar = 1'b0;
#2
  tbassert(Q == 3'b011, "Test 5");
  tbassert(RCO == 1'b0, "Test 5");
#2
  // asynchronous clear from 011, not enough time for clock pulse -> outputs 0
  tbassert(Q == 3'b000, "Test 5");
  tbassert(RCO == 1'b0, "Test 5");
#150
  Clear_bar = 1'b1;
#150
  // asynchronous clear from 110 with input ENT set, enough time for clock pulse -> outputs 0
  ENT = 1'b1;
  parallel_load_and_tick(3'b110);
#50
  tbassert(Q == 3'b110, "Test 6");
  tbassert(RCO == 1'b0, "Test 6");
#0
  Clear_bar = 1'b0;
#120
  tbassert(Q == 3'b000, "Test 6");
  tbassert(RCO == 1'b0, "Test 6");
#15
  Clear_bar = 1'b1;
#15
  // asynchronous clear from 111 with input ENT set, enough time for clock pulse -> outputs 0
  ENT = 1'b1;
  parallel_load_and_tick(3'b111);
#50
  tbassert(Q == 3'b111, "Test 7");
  tbassert(RCO == 1'b1, "Test 7");
#0
  Clear_bar = 1'b0;
#250
  tbassert(Q == 3'b000, "Test 7");
  tbassert(RCO == 1'b0, "Test 7");
#20
  Clear_bar = 1'b1;
#15
  // asynchronous clear from 111 with input ENT set, not enough time for clock pulse -> outputs 0
  ENT = 1'b1;
  parallel_load_and_tick(3'b111);
#20
  tbassert(Q == 3'b111, "Test 8");
  tbassert(RCO == 1'b1, "Test 8");
#0
  Clear_bar = 1'b0;
#20
  tbassert(Q == 3'b000, "Test 8");
  tbassert(RCO == 1'b0, "Test 8");
#10
  // steady state -> remains clear after asynchronous clear signal ends
  Clear_bar = 1'b1;
#120
  tbassert(Q == 3'b000, "Test 9");
  tbassert(RCO == 1'b0, "Test 9");
#50

  // the following set of tests are for: clear from initial state

  Clear_bar = 1'bx;
  Load_bar = 1'bx;
  ENT = 1'bx;
  ENP = 1'bx;
#15
  parallel_load_and_tick(3'bxxx);
#0
  Load_bar = 1'bx;
#100
  tbassert(Q === 3'bxxx, "Test 10");
  tbassert(RCO === 1'bx, "Test 10");
#0
  // asynchronous clear from initial state, not enough time for output to fall
  Clear_bar = 1'b0;
#2
  tbassert(Q === 3'bxxx, "Test 10");
  tbassert(RCO === 1'bx, "Test 10");
#2
  // asynchronous clear from initial state, no clock edge nearby -> outputs 0
  tbassert(Q == 3'b000, "Test 10");
  tbassert(RCO == 1'b0, "Test 10");
#75
  Clear_bar = 1'b1;
#50
  Clear_bar = 1'bx;
  // Load_bar = 1'bx;
  // ENT = 1'bx;
  // ENP = 1'bx;
#15
  parallel_load_and_tick(3'bxxx);
#0
  Load_bar = 1'bx;
#92
  tbassert(Q === 3'bxxx, "Test 11");
  tbassert(RCO === 1'bx, "Test 11");
#0
  // asynchronous clear from initial state, not enough time for output to fall
  Clear_bar = 1'b0;
#2
  tbassert(Q === 3'bxxx, "Test 11");
  tbassert(RCO === 1'bx, "Test 11");
#2
  // asynchronous clear from initial state, near or at clock edge -> outputs 0
  tbassert(Q == 3'b000, "Test 11");
  tbassert(RCO == 1'b0, "Test 11");
#75
  // steady state -> remains clear after asynchronous clear signal ends
  Clear_bar = 1'b1;
#120
  tbassert(Q == 3'b000, "Test 12");
  tbassert(RCO == 1'b0, "Test 12");
#0
  Load_bar = 1'b1;
#80
  tbassert(Q == 3'b000, "Test 12");
  tbassert(RCO == 1'b0, "Test 12");
#0

  // the following set of tests are for: steady state

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
  ENP = 1'b1;
  parallel_load_and_tick(3'b111);
#100
  tbassert(RCO == 1'b0, "Test 34");
#10
  ENT = 1'b1;
#15
  tbassert(Q == 3'b111, "Test 34");
  tbassert(RCO == 1'b1, "Test 34");
#0
  ENT = 1'b0;
#15
  tbassert(RCO == 1'b0, "Test 34");
#0
  wait_tick();
#50
  $finish;
end

endmodule
