romalik/cpu5/simulation/verilator/icechips/74283-tb.v

// Test: 4-bit binary full adder with fast carry

module test;

`TBASSERT_METHOD(tbassert)
`TBASSERT_2R_METHOD(tbassert2R)
`CASE_TBASSERT_2R_METHOD(case_tbassert2R, tbassert2R)

localparam WIDTH = 5;

// DUT inputs
reg [WIDTH-1:0] A;
reg [WIDTH-1:0] B;
reg C_in;

// DUT outputs
wire [WIDTH-1:0] Sum;
wire C_out;

// DUT
ttl_74283 #(.WIDTH(WIDTH), .DELAY_RISE(5), .DELAY_FALL(3)) dut(
  .A(A),
  .B(B),
  .C_in(C_in),
  .Sum(Sum),
  .C_out(C_out)
);

initial
begin
  integer i;

  $dumpfile("74283-tb.vcd");
  $dumpvars;

  // all zeroes + Carry 0 -> Sum all 0s + Carry 0
  A = {WIDTH{1'b0}};
  B = {WIDTH{1'b0}};
  C_in = 1'b0;
#4
  tbassert(Sum == 5'b00000, "Test 1");
  tbassert(C_out == 1'b0, "Test 1");
#0
  // all ones (31 + 31) + Carry 1 -> Sum all 1s (31) + Carry 1 (1<<5 == 32)
  A = {WIDTH{1'b1}};
  B = {WIDTH{1'b1}};
  C_in = 1'b1;
#6
  tbassert(Sum == 5'b11111, "Test 2");
  tbassert(C_out == 1'b1, "Test 2");
#0

  // repeat tests: Carry input is clear then set

  for (i = 3; i <= 4; i++)
  begin
    case (i)
      3:
      begin
        C_in = 1'b0;
      end
      4:
      begin
        C_in = 1'b1;
      end
    endcase

    // the following set of tests show the Carry output unaffected by the Carry input
    // (Carry output is clear)

    // 1 + 1 -> 2 + Carry input
    A = 5'b00001;
    B = 5'b00001;
#10
    case_tbassert2R(C_in == 1'b0, Sum == 5'b00010, "Test", "1", i);
    case_tbassert2R(C_in == 1'b1, Sum == 5'b00011, "Test", "1", i);
    tbassert2R(C_out == 1'b0, "Test", "1", i);
#0
    // 1 + 2 -> 3 + Carry input
    // A = 5'b00001;
    B = 5'b00010;
#10
    case_tbassert2R(C_in == 1'b0, Sum == 5'b00011, "Test", "2", i);
    case_tbassert2R(C_in == 1'b1, Sum == 5'b00100, "Test", "2", i);
    tbassert2R(C_out == 1'b0, "Test", "2", i);
#0
    // same on the other inputs
    A = 5'b00010;
    B = 5'b00001;
#10
    case_tbassert2R(C_in == 1'b0, Sum == 5'b00011, "Test", "3", i);
    case_tbassert2R(C_in == 1'b1, Sum == 5'b00100, "Test", "3", i);
    tbassert2R(C_out == 1'b0, "Test", "3", i);
#0

    // the following set of tests show the Carry output affected by the Carry input

    // zeroes on either side and all ones (0 + 31) -> Sum all 1s (31) + Carry input
    A = 5'b00000;
    B = 5'b11111;
#10
    case_tbassert2R(C_in == 1'b0, Sum == 5'b11111, "Test", "4", i);
    case_tbassert2R(C_in == 1'b1, Sum == 5'b00000, "Test", "4", i);
    case_tbassert2R(C_in == 1'b0, C_out == 1'b0, "Test", "4", i);
    case_tbassert2R(C_in == 1'b1, C_out == 1'b1, "Test", "4", i);
#0
    // same on the other inputs
    A = 5'b11111;
    B = 5'b00000;
#10
    case_tbassert2R(C_in == 1'b0, Sum == 5'b11111, "Test", "5", i);
    case_tbassert2R(C_in == 1'b1, Sum == 5'b00000, "Test", "5", i);
    case_tbassert2R(C_in == 1'b0, C_out == 1'b0, "Test", "5", i);
    case_tbassert2R(C_in == 1'b1, C_out == 1'b1, "Test", "5", i);
#0
    // 16 + 15 -> 31 + Carry input
    A = 5'b10000;
    B = 5'b01111;
#10
    case_tbassert2R(C_in == 1'b0, Sum == 5'b11111, "Test", "6", i);
    case_tbassert2R(C_in == 1'b1, Sum == 5'b00000, "Test", "6", i);
    case_tbassert2R(C_in == 1'b0, C_out == 1'b0, "Test", "6", i);
    case_tbassert2R(C_in == 1'b1, C_out == 1'b1, "Test", "6", i);
#0
    // all input bits transition from previous (15 + 16) -> 31 + Carry input
    A = 5'b01111;
    B = 5'b10000;
    C_in = ~C_in;
#10
    case_tbassert2R(C_in == 1'b0, Sum == 5'b11111, "Test", "7", i);
    case_tbassert2R(C_in == 1'b1, Sum == 5'b00000, "Test", "7", i);
    case_tbassert2R(C_in == 1'b0, C_out == 1'b0, "Test", "7", i);
    case_tbassert2R(C_in == 1'b1, C_out == 1'b1, "Test", "7", i);
#0
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
  C_in = 1'b0;
#6
  tbassert(Sum == 5'b10000, "Test 17");
  tbassert(C_out == 1'b1, "Test 17");
#0
  // 29 + 18 + Carry 1 -> 48
  A = 5'b11101;
  B = 5'b10010;
  C_in = 1'b1;
#6
  tbassert(Sum == 5'b10000, "Test 18");
  tbassert(C_out == 1'b1, "Test 18");
#10
  $finish;
end

endmodule
