romalik/cpu5/simulation/verilator/icechips/74150-tb.v

// Test: 16-input multiplexer

module test;

`TBASSERT_METHOD(tbassert)

localparam WIDTH_IN = 5;
localparam WIDTH_SELECT = $clog2(WIDTH_IN);  // do not pass this to the module because
                                             // it is dependent value

// DUT inputs
reg Enable_bar;
reg [WIDTH_SELECT-1:0] Select;  // Select is three bits but only valid in range 3'b000
                                // to 3'b100
reg [WIDTH_IN-1:0] D;

// DUT outputs
wire Y_bar;

// DUT
ttl_74150 #(.WIDTH_IN(WIDTH_IN), .DELAY_RISE(5), .DELAY_FALL(3)) dut(
  .Enable_bar(Enable_bar),
  .Select(Select),
  .D(D),
  .Y_bar(Y_bar)
);

initial
begin
  $dumpfile("74150-tb.vcd");
  $dumpvars;

  // select 000: enabled
  Enable_bar = 1'b0;
  Select = 3'b000;
  D = 5'b01011;
#6
  tbassert(Y_bar == 1'b0, "Test 1");
#0
  // select 000: disabled -> output 0
  Enable_bar = 1'b1;
#6
  tbassert(Y_bar == 1'b1, "Test 2");
#0
  // select 011: disabled
  Select = 3'b011;
#10
  tbassert(Y_bar == 1'b1, "Test 3");
#0
  // select 011: enabled
  Enable_bar = 1'b0;
#10
  tbassert(Y_bar == 1'b0, "Test 4");
#0
  // select 100: enabled
  Select = 3'b100;
#10
  tbassert(Y_bar == 1'b1, "Test 5");
#0
  // select 100: disabled
  Enable_bar = 1'b1;
#10
  tbassert(Y_bar == 1'b1, "Test 6");
#0
  // select 001: disabled
  Select = 3'b001;
#10
  tbassert(Y_bar == 1'b1, "Test 7");
#0
  // select 001: enabled
  Enable_bar = 1'b0;
#10
  tbassert(Y_bar == 1'b0, "Test 8");
#0
  // while enabled: change to select 000 from select 001
  Select = 3'b000;
#10
  tbassert(Y_bar == 1'b0, "Test 9");
#0
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
