romalik/cpu5/(commit log)

2024-04-06 flags, [m+imm]
    [instruction_set.ods]
2024-04-07 c compiler wip
    [instruction_set.ods]
2024-04-07 offset rework
    [instruction_set.ods]
2024-04-07 compiler alpha ready
    [instruction_set.ods]
2024-04-10 another iteration of fixing flags
    [instruction_set.ods]
2024-04-17 +movw X
    [instruction_set.ods]
2024-04-18 tests work
    [instruction_set.ods]
2024-04-20 trenary wip
    [instruction_set.ods]
2024-05-10 interrupts from C
    [instruction_set.ods]
2024-05-10 + uart buffer, syscalls
2024-06-06 add W,Y,Z WIP
    [instruction_set.ods]
2025-03-20 sorta task switching
2025-03-21 proper task switching
2025-08-27 +kicad +verilog
    [cpu5.kicad_pcb, cpu5.kicad_sch]
2025-08-27 microcode rom works
    [cpu5.kicad_sch]
2025-08-30 nop works
    [cpu5.kicad_pcb, cpu5.kicad_sch]
2025-08-31 address marching with PC
    [cpu5.kicad_pcb, cpu5.kicad_sch, registers.kicad_sch]
2025-09-02 verilator works, loop program works
    [alu.kicad_sch, cpu5.kicad_pcb, decoder.kicad_sch, memory.kicad_sch, registers.kicad_sch]
2025-09-07 os + ints work, ZF issue
    [alu.kicad_sch, cpu5.kicad_pcb, cpu5.kicad_sch, interrupts.kicad_sch, registers.kicad_sch]
2025-09-07 flags ok
    [alu.kicad_sch, cpu5.kicad_sch]
2025-09-08 Multithread + paging!
    [alu.kicad_sch, cpu5.kicad_pcb, cpu5.kicad_sch, memory.kicad_sch, registers.kicad_sch]
2025-09-09 start faults
    [cpu5.kicad_sch, interrupts.kicad_sch, memory.kicad_sch]
2025-09-09 faults seem to work
    [cpu5.kicad_sch, instruction_set.ods, interrupts.kicad_sch, memory.kicad_sch]
2025-09-10 Page faults work
    [cpu5.kicad_sch, instruction_set.ods, interrupts.kicad_sch, memory.kicad_sch, registers.kicad_sch]
2025-09-10 perf experiments
    [interrupts.kicad_sch, memory.kicad_sch]
2025-09-12 cmake pipeline
    [cpu5.kicad_pcb]
2025-09-14 interrupts in lsim
2025-09-14 user space works in lsim
    [cpu5.kicad_sch]
2025-09-16 faults fixed
    [cpu5.kicad_sch, memory.kicad_sch]
